Evan-Daruwalla/vision-autonomous-car/cad/README.md

# cad/ — models and print artifacts

## tolerance_coupon_v1.stl / _v2.stl — PRD M1.3

**Why this exists:** nominal Lego geometry (pin hole Ø4.8 mm, beam pitch
8.0 mm) does not print at nominal on an FDM machine — holes come out
undersize, and by an amount specific to *your* printer, filament, nozzle and
slicer settings. Community starting points are ~5.1 mm for a pin fit and
5.3–5.6 mm for a free-rotating axle bore, but those are **unverified on this
printer**, which is the whole point of this part. Every chassis dimension in
M1.5–M1.7 depends on the numbers you get here, so this is the first thing to
print and it gates the rest of M1.

Generated by [`scripts/gen_tolerance_coupon.py`](../scripts/gen_tolerance_coupon.py) —
edit the constants there and re-run rather than editing the STL. **v1 tested
2026-09-05: the axle-bore sweep (5.20-5.70 mm) was entirely too loose, so v2
moves it to 4.80-5.30 mm** (see the generator's module docstring). v1's STL
and its results stay on disk/in this file — it was actually printed and
measured, and the record doesn't overwrite tested history.

```bash
python scripts/gen_tolerance_coupon.py            # writes v2 by default now
python scripts/gen_tolerance_coupon.py -o cad/tolerance_coupon_v1.stl  # v1's own range is no longer the default; regenerate v1 only to re-check it
```

The generator self-validates and refuses to claim success quietly: it checks
the mesh is closed and consistently wound (every directed edge appears once,
its reverse once) and that the signed volume matches the analytic expectation.
v2 output: `manifold PASS`, `volume PASS` at 6.66e-16 relative error,
18,048 triangles, 104 × 56 × 8 mm.

### What's on the plate

| Feature | Layout | Diameters | How to identify |
|---|---|---|---|
| **Pitch row** | 5 holes at exactly **8.00 mm** centres | all 5.10 mm | the tightly-spaced row, no markers |
| **Pin row** | 6 holes at 16 mm centres | 4.80 → 5.30 in 0.1 steps | **one** 3 mm marker hole at the left end |
| **Axle row** | 6 holes at 16 mm centres | 4.80 → 5.30 in 0.1 steps (v2; v1 was 5.20 → 5.70, all found too loose) | **two** 3 mm marker holes, one at each end |

Sweeps ascend left-to-right from the marker end. The plate is 8 mm thick on
purpose — that matches a real Lego beam, and hole shrinkage is depth-dependent,
so a thin coupon would give you optimistic numbers.

### Printing

**Print it with the exact settings you intend to use for the chassis.** If you
later change layer height, nozzle, or filament brand, these numbers stop being
valid and the coupon has to be re-run. Record the settings you used — they go
in the record entry alongside the measurements.

- No supports needed; all holes are vertical through-holes.
- Suggested starting point: 0.2 mm layers, 3 walls, ≥20% infill, 0.4 mm nozzle.
- **Print it twice — once in PLA, once in PETG.** The research calls for PETG
  on rotating bores (PLA galls against Lego axles) and PLA is fine for static
  holes, so you need both sets of numbers. ~15 min each.

### Testing

You need real Lego parts and calipers.

- **Pin row — pass = a Lego pin pushes in with firm thumb pressure and HOLDS.**
  Too tight if you need pliers or the plate creaks; too loose if it falls out
  or wobbles. Record the smallest diameter that seats without excessive force.
- **Axle row — pass = a Lego axle spins FREELY with no perceptible radial
  slop.** Record the smallest diameter that spins freely, since larger means
  more slop.
- **Pitch row — insert two pins joined by a real Lego beam (or a 2-pin
  connector) across holes 1 and 2, then across 1 and 5.** If the beam seats on
  adjacent holes but binds across all five, your printer has a dimensional
  scaling error — measure the actual centre-to-centre distance across the 5
  holes with calipers (nominal 32.00 mm) and note the ratio. That scaling
  factor applies to every chassis part.
- Also caliper each hole's **actual printed diameter** so you know the offset
  between commanded and achieved, not just which hole happens to work.

### Results — v1 (printed and tested 2026-09-05, Appendix DI)

Printer: **Bambu P1S**  Filament: **Bambu ABS, Black** (replaces the
PLA+PETG plan — ABS is now the standing chassis material, Evan 2026-09-05)
Nozzle: **0.4 mm**  Layer height: **0.2 mm**  Walls: **2**  Infill: **10% gyroid**
Shrinkage compensation: **99%** (Bambu Studio X/Y scale-up, ABS-specific)
Date printed: 2026-09-05 (exact time not recorded)

| Row | Commanded Ø | Measured Ø | Offset | Fit verdict |
|---|---|---|---|---|
| Pin | 4.80 | not calipered | — | **PASS — best fit** |
| Pin | 4.90 | not calipered | — | pass |
| Pin | 5.00 | not calipered | — | pass |
| Pin | 5.10 | not calipered | — | not reported |
| Pin | 5.20 | not calipered | — | not reported |
| Pin | 5.30 | not calipered | — | not reported |
| Axle | 5.20 | not calipered | — | **FAIL — too loose ("seems a bit big")** |
| Axle | 5.30 | not calipered | — | FAIL — too loose |
| Axle | 5.40 | not calipered | — | FAIL — too loose |
| Axle | 5.50 | not calipered | — | FAIL — too loose |
| Axle | 5.60 | not calipered | — | FAIL — too loose |
| Axle | 5.70 | not calipered | — | FAIL — too loose |

Evan's report: pin row — "only the smallest 3 are a good fit with the
smallest one being the best" (4.80/4.90/5.00 pass, 4.80 best; 5.10-5.30
not explicitly reported, treated as untested rather than assumed-fail).
Axle row — "all the ones in the first row spin smooth, even the smallest
ones seems a bit big": **all six axle-row diameters too loose**, including
the smallest (5.20) — the sweep brackets nothing at the tight end.
⚠️ **No caliper measurements taken** — verdicts are Evan's fit-by-feel only
(firm/holds vs. spins-free-with-slop), not measured offsets. "Measured Ø"
and "Offset" columns are unfilled because of that, not because they were
skipped in the record.

**The pitch-row dimensional-scaling test (beam across holes 1-2, then
1-5) was NOT run** — Evan spin-tested a Lego axle across the pitch row's 5
holes instead (uniform 5.10 mm, also too loose for an axle, consistent with
the axle-row finding) rather than the beam-span check the row is for. Scale
factor still unknown.

**v1 chosen:** pin holes model at **4.80 mm** (best of 3 tested passes, at
the bottom of the tested range — not bracketed, could be even better below
it). Rotating axle bores: not determined in v1 — the 5.20-5.70 sweep was
entirely too loose, which is why v2 exists.

### Results — v2 (`tolerance_coupon_v2.stl`) — printed and tested 2026-09-05, Appendix DK

Same print settings as v1 (Bambu P1S, Bambu ABS Black, 0.4mm nozzle, 0.2mm
layers, 2 walls, 10% gyroid, 99% shrinkage comp) unless Evan says otherwise
— not independently confirmed unchanged, but no change was reported.

| Row | Commanded Ø | Measured Ø | Offset | Fit verdict |
|---|---|---|---|---|
| Axle | 4.80 | not calipered | — | not reported |
| Axle | 4.90 | not calipered | — | not reported |
| Axle | 5.00 | not calipered | — | **PASS — best fit ("3rd smallest hole is best for axel")** |
| Axle | 5.10 | not calipered | — | not reported |
| Axle | 5.20 | not calipered | — | not reported |
| Axle | 5.30 | not calipered | — | not reported |

Evan reported only the winner, not a pass/fail for every row — 4.80/4.90
being smaller and 5.10-5.30 being larger than the chosen 5.00 doesn't by
itself tell us whether they failed tight, failed loose, or simply fit worse
than 5.00. Recorded as "not reported," not assumed either way.

**Chosen offsets — M1.3's two headline numbers, both closed:**
**pin holes model at 4.80 mm** (v1) · **rotating axle bores model at
5.00 mm** (v2). Sits between the pin's snug-fit diameter (4.80) and v1's
smallest too-loose axle diameter (5.20), which is the physically sensible
place for a rotating cross-axle bore to land relative to a static pin's
socket.

**Still open:** the pitch-row dimensional-scaling check (beam across holes
1-2, then 1-5) has never been run, and no caliper measurements exist for
either coupon — every verdict above is fit-by-feel against the coupon's
pass criteria, not a measured offset.

### When you're done

1. Put the filled table + print settings into a record entry (they are
   portfolio evidence — this is a real measured experiment, not a guess).
2. Write the two chosen offsets into `.claude/project-memory/gotchas.md`,
   replacing the unverified community figures currently there.
3. M1.5 onward can then model against real numbers.

**If the sweep brackets nothing** — every pin hole too tight, or every axle
bore too loose — edit the ranges at the top of the generator and re-run rather
than guessing beyond the ends of the sweep.

---

## servo_lego_coupler_v1.stl — PRD task 8c(ii)

**Why this exists:** the servo-to-pinion coupling is the highest-torque joint
on the car (Appendix BV). ~~The chosen part is the Adafruit #4252 ($0.75), but~~
**Since 2026-10-04 the plan is to PRINT this part (v2, below); #4252 is the
fallback, never bought.** Originally: the chosen part was the Adafruit #4252 ($0.75), but
Adafruit is a sole-source vendor for it and charges ~$10 shipping for that one
item (Evan, 2026-09-03). This is a printed stopgap to try first — **not a
proven replacement.**

Generated by [`scripts/gen_servo_lego_coupler.py`](../scripts/gen_servo_lego_coupler.py) —
edit the constants there and re-run rather than editing the STL.

```bash
python scripts/gen_servo_lego_coupler.py
```

Self-validates the same way the coupon does (closed + consistently wound mesh,
signed volume against an analytic expectation) and refuses to write on failure.
Current output: `manifold PASS`, `volume PASS` at 1.05e-14 relative error,
1,152 triangles, Ø10 × 16 mm, 1015.12 mm³.

### Printed and fitted: v1 was too loose -> v2 (2026-10-04, Appendix FC)

**v1 was printed** (by 2026-09-03; the record had misread this as a bought
Adafruit #4252). **Its Lego-axle socket was TOO LOOSE** (Evan). Printer,
filament and settings were not recorded. Cause: the socket used the coupon's
+0.20 mm free-SPIN offset, where a grip needs the pin row's 0.00.

**`servo_lego_coupler_v2.stl` - print this one.** Same part, socket clearance
0.00 mm (4.80 x 1.80 mm cross, 2.60 mm wall):

```bash
python scripts/gen_servo_lego_coupler.py --socket-clear 0.00 -o cad/servo_lego_coupler_v2.stl
```

**Untested.** The 0.00 came from a round pin; thin cross arms may print
tighter - if a Lego axle will not go in, regenerate at 0.05 or 0.10 rather than
forcing it. Record printer, filament, settings and the fit result this time.
The generator refuses any wall under 1.2 mm (Appendix FD #6).

### v3: half the wall, 2 mm shorter (2026-10-10)

Evan fitted v2: "make the walls of the v2 1/2 as thick and a bit shorter
overall; other than that the dimensions are good". So the bore (4.65 mm) and
the 0.00-clearance cross socket are unchanged. OD 10.0 -> 7.4 mm (socket wall
2.60 -> 1.30, bore wall 2.675 -> 1.375); length 16 -> 14 mm (bore 8 -> 7,
socket 6 -> 5, web still 2). "A bit shorter" = 2 mm was a guess, not a
measured requirement - change `--bore-depth` / `--socket-depth` if not.

```bash
python scripts/gen_servo_lego_coupler.py --socket-clear 0.00 --od 7.4 --bore-depth 7 --socket-depth 5 -o cad/servo_lego_coupler_v3.stl
```

**Untested, and weaker by design:** in twist, the bore section's polar section
modulus drops to about 36% of v2's (computed, (OD^4 - ID^4)/OD), and a
1.375 mm wall around a 0.20 mm press-fit spline is more likely to split in
ABS. 1.30 mm is just above the generator's 1.2 mm floor.

### Drive-motor coupler v1: Pololu #5159 D-shaft to a Lego axle (2026-10-10)

Same generator, same socket and wall as servo v3, with a D-bore at the motor
end: 3.00 mm, 2.50 mm across the flat, 8 mm deep (the shaft is 9 mm, so the
part stops ~1 mm short of the gearbox face). 1.5 mm through-hole in the web
(a 2.2 mm one would cut the flat, which sits 1.0 mm off centre; the generator
now refuses that). OD 7.4 x 15 mm.

```bash
python scripts/gen_servo_lego_coupler.py --socket-clear 0.00 --od 7.4 --bore-dia 3.0 --bore-flat 2.5 --screw-dia 1.5 --bore-depth 8 --socket-depth 5 -o cad/motor_lego_coupler_v1.stl
```

**The 2.50 mm flat is UNMEASURED** - Pololu does not publish it; one retailer
says 2.5 mm (`docs/research/2026-07-23_drive-motor-selection.md`). Caliper
the real shaft (diameter, across-flat, length) before printing and re-run
with the measured numbers. The bore is modelled at nominal (0.00 offset, the
grip that worked on the coupon pins and on v2); if it will not go on, add
0.05-0.10 to `--bore-dia` and `--bore-flat` rather than forcing it. Untested.

**Motor v2 (2026-10-11, Evan): +0.075 mm clearance on the D-bore only** -
3.075 mm dia, 2.575 mm across the flat, still 8 mm deep; socket and body
unchanged. (A 1.5x-longer, 12 mm bore was generated first and dropped at
Evan's call: the shaft is only 9 mm.)

```bash
python scripts/gen_servo_lego_coupler.py --socket-clear 0.00 --od 7.4 --bore-dia 3.075 --bore-flat 2.575 --screw-dia 1.5 --bore-depth 8 --socket-depth 5 -o cad/motor_lego_coupler_v2.stl
```

**Motor v3 (2026-10-11, Evan): another +0.075 mm** - 3.150 mm dia, 2.650 mm
across the flat (+0.150 over v1 in total). Same everything else.

```bash
python scripts/gen_servo_lego_coupler.py --socket-clear 0.00 --od 7.4 --bore-dia 3.15 --bore-flat 2.65 --screw-dia 1.5 --bore-depth 8 --socket-depth 5 -o cad/motor_lego_coupler_v3.stl
```

### The design, and the one thing it deliberately does not do

| end | feature | why |
|---|---|---|
| servo (z 0–8) | Ø4.65 mm plain round bore | 0.20 mm under the 4.85 mm 20T spline; the metal spline cuts its own seat |
| middle (z 8–10) | Ø2.2 mm axial hole | screwdriver access to the servo's OWN retaining screw — zero new parts, stops the coupler walking off the shaft |
| Lego (z 10–16) | 5.00 × 2.00 mm cross socket, 6 mm deep | receives a **real** Lego axle |

**It prints no cross-axle profile.** Appendix BV measured a printed male cross
profile at SF 0.57–0.96 (thin cruciform fins shearing along layer lines) and
`steering.md` permits socket-style printed adapters only. This obeys that: the
printed part is a thick-walled socket (2.50 mm wall at the socket, 2.68 mm at
the bore); the cross profile is the real Lego axle's.

**The spline is not modelled, on purpose.** 20 teeth on a Ø4.85 mm circle is a
~0.76 mm tooth pitch — under what a 0.4 mm nozzle resolves. A modelled spline
would print as a blurred round hole while claiming fidelity it does not have.

### ⚠️ What is NOT known

**No safety factor is claimed, and none can be computed** without a torque
test. The bore-to-spline grip is friction plus spline bite and has never been
loaded. What protects this joint is the existing rule that the servo never
reaches stall (`SERVO_US_SPAN` limiting, task 8c). If it slips, the upgrade is
a transverse M2 grub screw into the bore — **not** the MG996R, which makes the
coupling problem ~5× worse (BOM row 7).

### Four numbers to caliper, then re-run

| constant | current | status |
|---|---|---|
| `SPLINE_DIA` | 4.85 | datasheet range 4.8–4.9; measure the real servo |
| `AXLE_ARM` | 1.80 | Lego cross-axle arm thickness — community value, **unverified**. The 4.80 mm across-the-cross span IS confirmed |
| `SOCKET_CLEAR` | 0.20 | still provisional. ⚠️ The M1.3 coupon IS now printed (2026-09-05) and its axle row closed at 5.00 mm — but that is a FREE-SPIN fit, and this socket needs a firm GRIP to transmit torque, which is closer to the coupon's PIN row (4.80 mm) in spirit. Do not copy 5.00 across without deciding which fit this joint actually wants |
| `BORE_INTERF` | 0.20 | press interference — a guess; the first print settles it |

Print it in **PETG**, not PLA: this is a loaded joint and PLA is the material
Appendix BV's failing numbers were computed against.

## OpenSCAD parts - `cad/scad/` (2026-10-11, Appendix FY)

Printed mounts are parametric OpenSCAD files. OpenSCAD 2021.01 lives at
`~/tools/openscad-2021.01/` (not on PATH; `scripts/render_scad.py` finds it,
or set `$OPENSCAD`). Never hand-export from the GUI for the repo: render with

```bash
.venv/Scripts/python.exe scripts/render_scad.py cad/scad/pla_fit_coupon.scad -o cad/pla_fit_coupon.stl --png preview.png
```

It writes a CANONICAL binary STL (OpenSCAD's raw output reorders facets run to
run, so `check_artifacts.py` could not byte-compare it otherwise). It writes
NOTHING unless the mesh is a closed manifold, the volume is positive, the
bounding box matches, and every ray probe in `<part>.probe.json` passes.
A probe file lists the holes that must be open (with solid walls) and the
points that must be open or solid. `--png` writes a preview with the
`ghost_box` component stand-ins visible.

Shared primitives are in `cad/scad/lib/lego.scad`: `technic_hole` (with optional
counterbores), `pin_grid`, `pilot_hole`, `zip_slot`, `ghost_box`. Holes are
circumscribed polygons, so they never print smaller than nominal.

### pla_fit_coupon.stl - print this FIRST (untested)

72 x 34 x 17 mm. Every mount's Lego interface depends on PLA fits nobody has
measured: the 4.80 mm pin hole came from ABS coupons judged by feel. Print it
with the same settings as the parts (P1S, PLA, 0.1 mm, 2 walls), then report:

- **Row A** (plain, 4.75 / 4.80 / 4.85 / 4.90 / 4.95 / 5.00 from the chamfered
  corner): which hole takes a black friction pin FIRMLY, by hand, without
  force.
- **Row B** (same sizes, 6.2 x 0.8 counterbore on top): does the counterbore
  let the coupon sit flush against a Lego beam when pinned?
- **Row C** (six 4.90 holes at 8 mm pitch): pin a 1x7 beam across all six; if
  the end pins bind, the printer's X/Y scale is off.
- **Horizontal holes** (4.8 / 4.9 / 5.0, through the fin): the same pin test;
  holes printed sideways come out less round.
- **Pilot holes** (1.5 / 1.7 / 1.9): which one a servo mounting screw drives
  into firmly without splitting.
- **Zip slots** (3.0 / 3.5 / 4.0 / 5.0 wide x 1.8): the smallest your zip tie
  passes through.

### motor_mount.stl - v2, printable, UNTESTED (Appendices GJ, GK, GL)

Cradle for the Pololu #5159 under the centre frame, motor connector UP,
held by 2 zip ties, with a back wall behind the encoder. v1 printed
2026-10-12: dimensions fine, but the encoder hit the back third of the side
walls, which v2 removes. v2 takes two REAL black friction pins: push them
into holes A/B of the short beams inside the centre frame from below, then
push the mount up so the pins snap into its arm sockets (6.2 x 0.8 collar
recess, 4.8 bore, 6.2 snap cavity - see
docs/research/2026-10-12_technic-pin-snap-geometry.md). Print upright, floor
on the bed, no supports. Report: do the pins snap and hold; does the motor
sit level with the coupler; is the back wall gap right (encoder end position
was a photo estimate).

### servo_mount.stl - v2, printable, UNTESTED (Appendix GS)

One plate across the two Lego 2x4 L liftarms either side of the MG90D-270,
carrying it by its ears only (the case footprint is open). Two ear screws into
1.7 mm pilots (swap for the coupon's best pilot). Pin holes at studs 1, 2 and 3
of each L; pin studs 1 and 3. Print flat side down, no supports.

### electronics_tray.stl + electronics_deck.stl - printable, UNTESTED (Appendix GW)

Layer 1 (tray) pins straight onto the middle frame row (free holes at studs 0,
4, 6, 10, 11, 15, 16 along both long edges, 48 mm apart) and carries the power
bank (ports to the rear), the 2S holder (one side lobe) and the charger / BMS /
fuse / XT30 (other lobe, zip slots). Layer 2 (deck) pins onto the tray's six
posts and carries the Pi case (camera connector forward, vent window under
it), the Uno on pegs, the LM2596 on a wing and the rocker on a rear tab.
Print both flat side down; the tray is ~162 x 169 mm.
