Evan-Daruwalla/vision-autonomous-car/cad/reference/README.md

# cad/reference - external OpenDRIVE files

These two files were not generated by this repo's code. They are vendored
here (2026-09-09) so the track scripts and their self-checks work on any
clone. Provenance as far as the record shows (added 2026-11-04, audit C3-9,
record NQ):

| File | Source | Record |
|---|---|---|
| `1122.xodr` | A 3x3 grid map Evan exported from LaneMaker on 2026-09-07 (was `~/Downloads/1122.xodr`, 96,786 B) | EF; vendored per the 2026-09-09 audit |
| `figure8.xodr` | Was `~/Downloads/figure 8.xodr` (31,208 B), named in record ER as the resolution of the LaneMaker thread. Who made it and with what tool is NOT recorded | ER |

Not checked: LaneMaker's terms for exported files. The repo LICENSE (MIT)
covers this repo's own code and docs; it makes no claim about these two
files beyond what their source allows.
