Evan-Daruwalla/vision-autonomous-car/pi/requirements-autopilot.txt

# for pi/autopilot.py; numpy and Pillow come from Raspberry Pi OS apt
onnxruntime==1.31.1
