Evan-Daruwalla/vision-autonomous-car/ml/artifacts/p1_first_frame.png

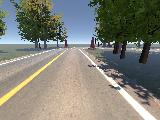
ml/artifacts/p1_first_frame.png
