Evan-Daruwalla/vision-autonomous-car/ml/runs/encoder_cmp/cone_recon.png

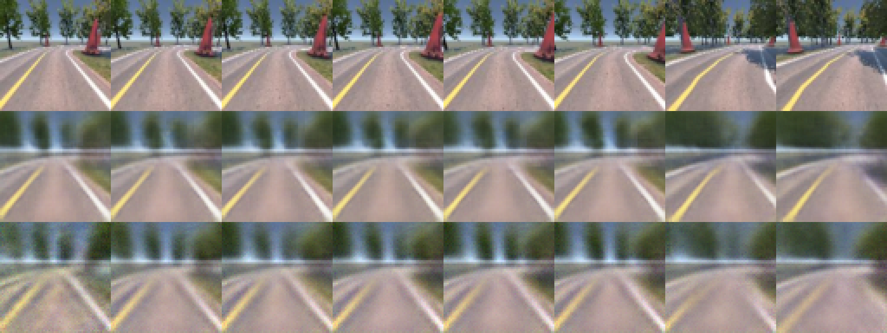
ml/runs/encoder_cmp/cone_recon.png
