Evan-Daruwalla/vision-autonomous-car/ml/runs/rollout/rollout_holdout.png

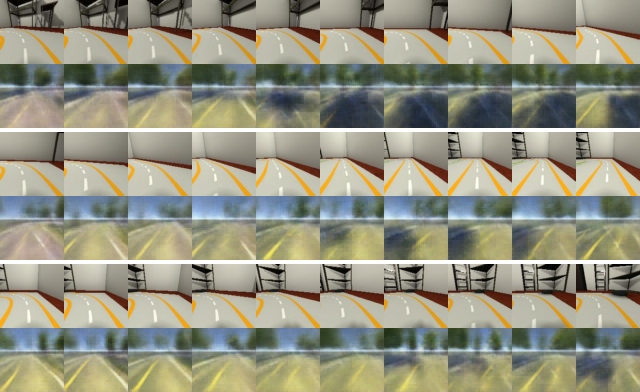
ml/runs/rollout/rollout_holdout.png
