Evan-Daruwalla/vision-autonomous-car/ml/runs/rollout/rollout_val_indomain.png

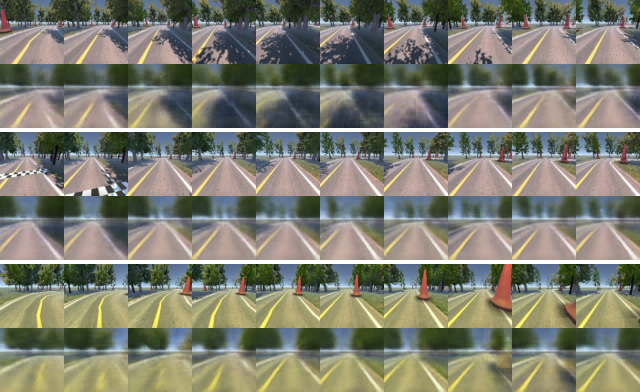
ml/runs/rollout/rollout_val_indomain.png
