Evan-Daruwalla/vision-autonomous-car/ml/runs/vae/recon_fit.png

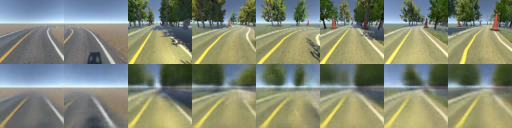
ml/runs/vae/recon_fit.png
