Evan-Daruwalla/vision-autonomous-car/ml/runs/vae/recon_holdout.png

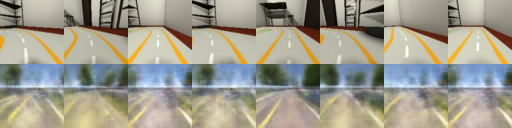
ml/runs/vae/recon_holdout.png
