Evan-Daruwalla/vision-autonomous-car/ml/runs/vae/recon_val_indomain.png

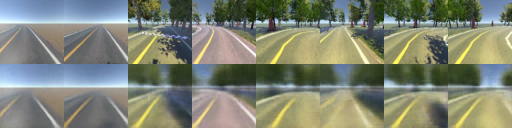
ml/runs/vae/recon_val_indomain.png
