Evan-Daruwalla/vision-autonomous-car/cad/electronics_deck.stl

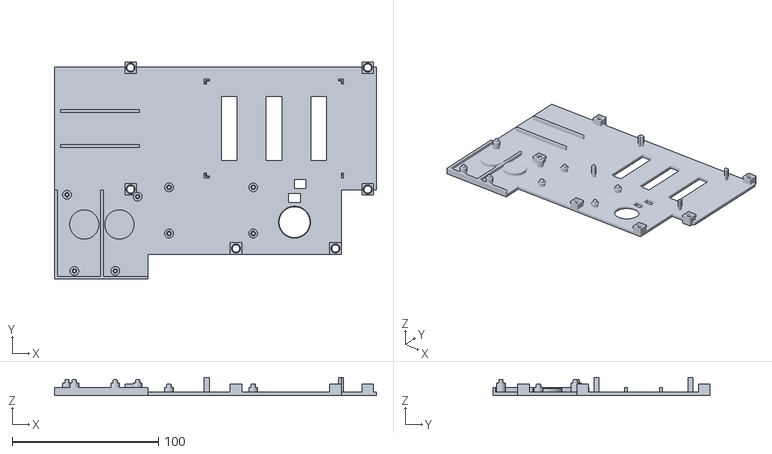
[picture p13: CAD file, 2026-11-01]
cad/electronics_deck.stl
220.0 x 148.6 x 12.5
