Evan-Daruwalla/vision-autonomous-car/cad/electronics_tray.stl

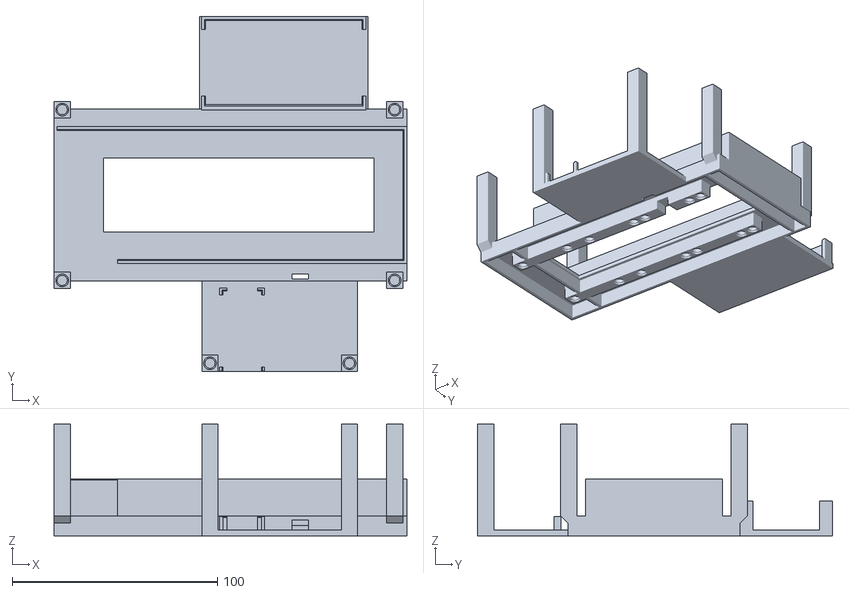
[picture p14: CAD file, 2026-11-01]
cad/electronics_tray.stl
172.0 x 173.0 x 54.5
