Evan-Daruwalla/vision-autonomous-car/cad/pla_fit_coupon.stl

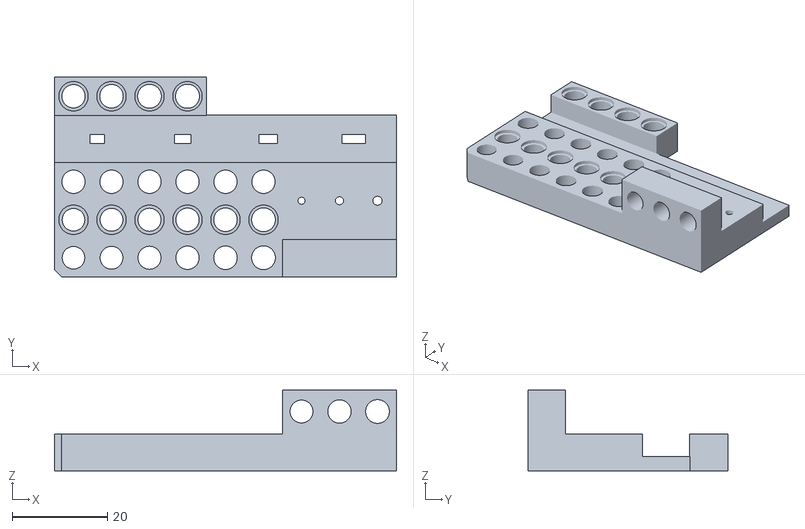
[picture p15: CAD file, 2026-10-13]
cad/pla_fit_coupon.stl
72.0 x 42.0 x 17.0
