Evan-Daruwalla/vision-autonomous-car/cad/pla_pocket_gauge.stl

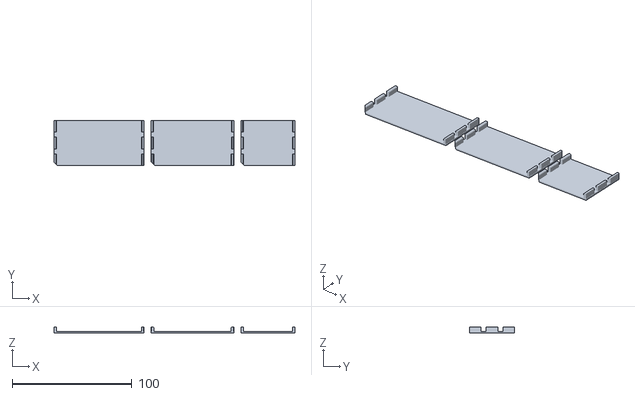
[picture p16: CAD file, 2026-10-13]
cad/pla_pocket_gauge.stl
201.6 x 38.0 x 5.20
