Evan-Daruwalla/vision-autonomous-car/cad/servo_mount.stl

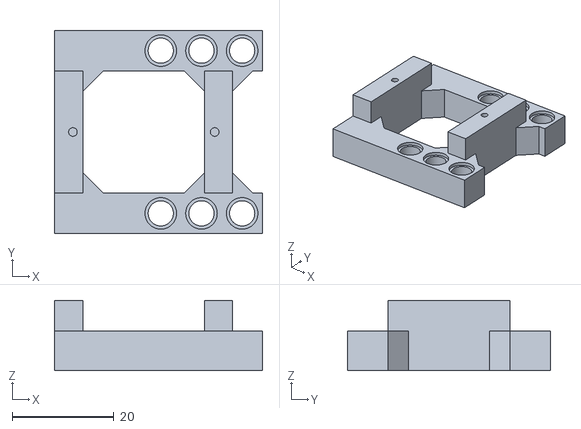
[picture p17: CAD file, 2026-10-13]
cad/servo_mount.stl
40.9 x 40.0 x 13.8
