Evan-Daruwalla/vision-autonomous-car/cad/camera_mast.stl

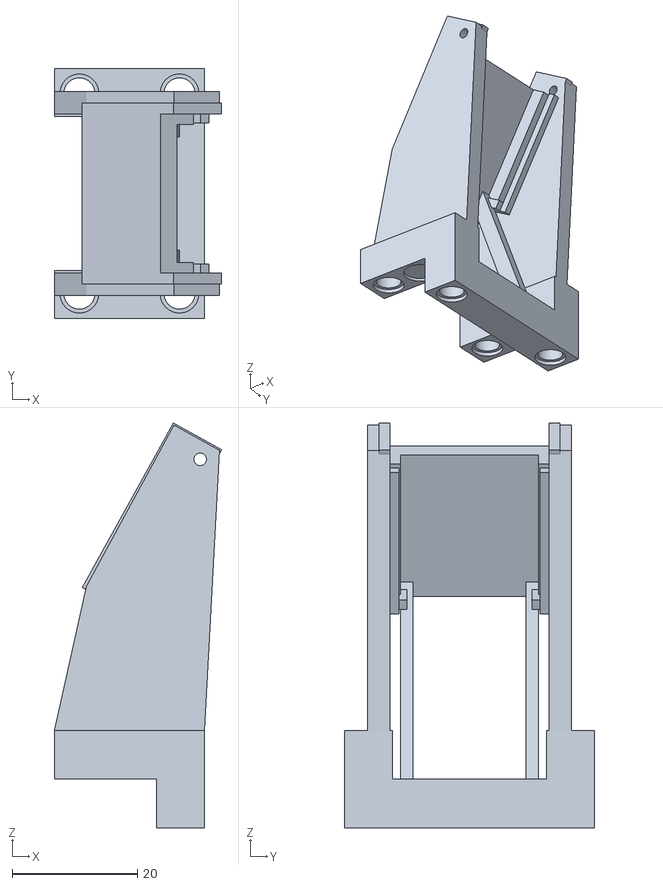
[picture p18: CAD file, 2026-10-13]
cad/camera_mast.stl
26.7 x 40.0 x 64.7
