Evan-Daruwalla/vision-autonomous-car/cad/motor_mount.stl

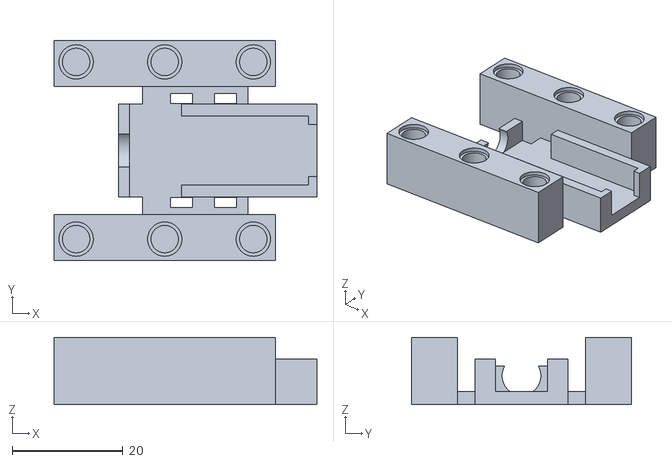
[picture p19: CAD file, 2026-10-13]
cad/motor_mount.stl
47.5 x 39.8 x 12.1
