Evan-Daruwalla/vision-autonomous-car/cad/motor_lego_coupler_v3.stl

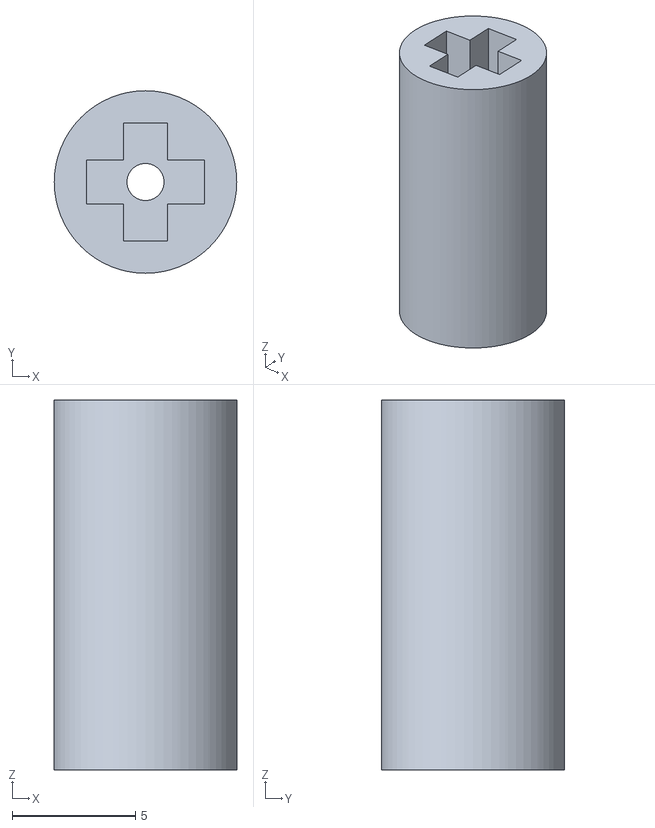
[picture p20: CAD file, 2026-10-11]
cad/motor_lego_coupler_v3.stl
7.40 x 7.40 x 15.0
