Evan-Daruwalla/vision-autonomous-car/cad/servo_lego_coupler_v3.stl

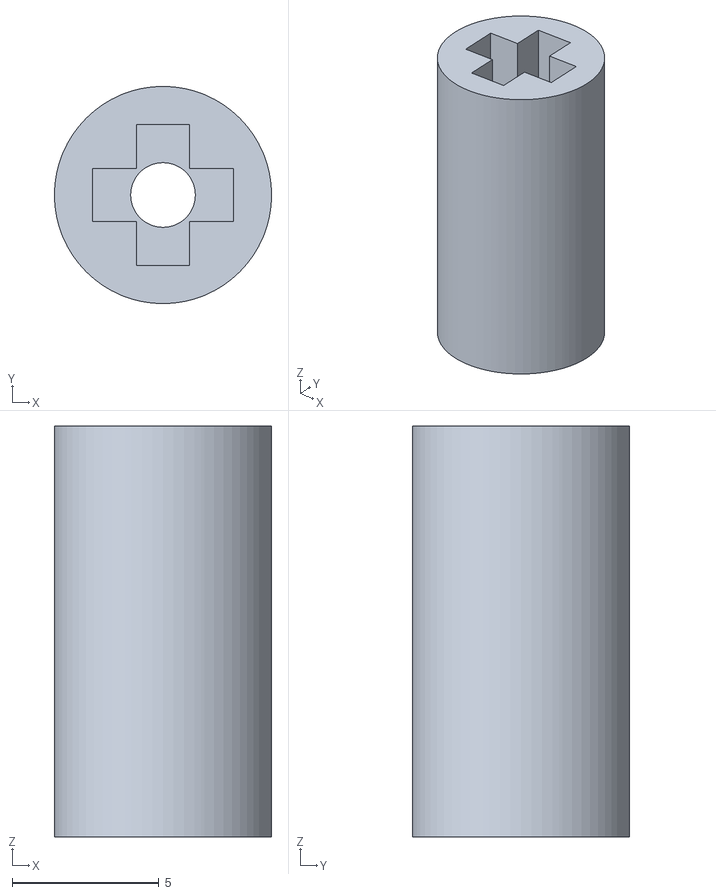
[picture p21: CAD file, 2026-10-11]
cad/servo_lego_coupler_v3.stl
7.40 x 7.40 x 14.0
