Evan-Daruwalla/vision-autonomous-car/cad/tolerance_coupon_v2.stl

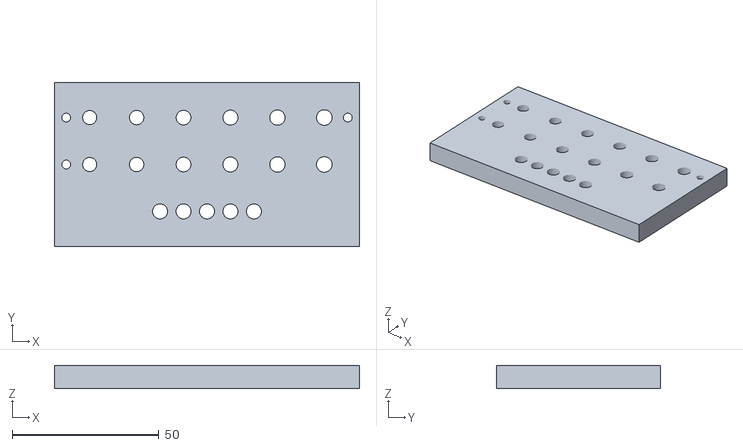
[picture p22: CAD file, 2026-09-05]
cad/tolerance_coupon_v2.stl
104.0 x 56.0 x 8.00
