Evan-Daruwalla/vision-autonomous-car/cad/servo_lego_coupler_v2.stl

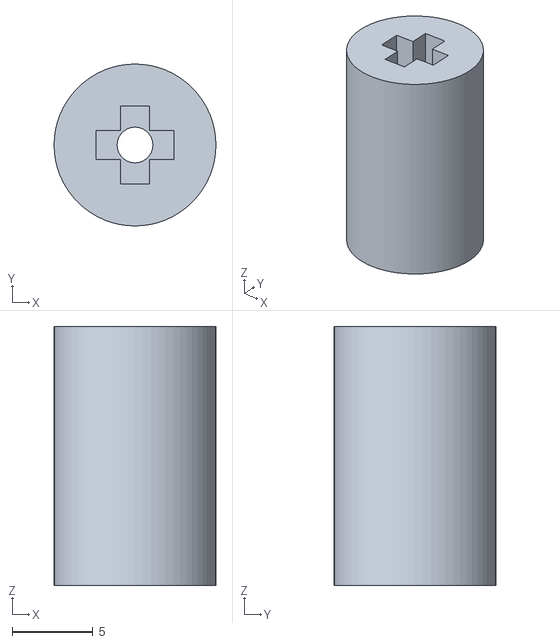
[picture p23: CAD file, 2026-10-05, an earlier design]
cad/servo_lego_coupler_v2.stl
10.0 x 10.0 x 16.0
