Evan-Daruwalla/vision-autonomous-car/cad/scad/electronics_tray.scad

// Electronics TRAY: PLA tray that pins onto the car's Lego frames and carries the
// battery bank, the battery holder, the charger / small parts, and the deck posts.
// UNTESTED - not printed.
// spec: record GW
// v2 (2026-10-12): encoder-cable notch in the -y rail (x 100..108, z 0..5) and floor slot
// (x 100..108, y -41.0..-38.5); see the record entry of that date.
// v3 (2026-10-13): print-friendly per docs/research/2026-10-12_print-friendly-cad-rules.md:
// ribs under the floor so every overhang is a bridge <= ~20 mm (Rule 7), zip-tie
// notches in the ribs, -y feet moved off the small-parts tie paths, holder lobe to
// y 85 (tie strip 0.6 -> 2.6 mm, Rule 8), 45 deg wedges under the four outer posts,
// pockets from fit class "pocket" (Rules 2, 11), 0.5 lead-in chamfers on the pocket
// tops (Rule 5). Print as modelled: z = 0 on the bed. See the record entry of 2026-10-13.
// v4 (2026-10-13): deck raised 2 mm (posts to z 32.0) - the 2S holder (20.5 tall, top
// z 30.3) hit the deck underside at 30.0. LAYOUT list = every layer-1 electronic part
// (preview ghosts + echoed for scripts/electronics_layout.py).
// v5 (2026-10-13): fences 4 -> 10 mm tall. The PETG pocket gauge showed the bank ~2 mm
// loose in a 4 mm fence: its edges are rounded and its sides are flat only from 7 mm
// above its bottom (Evan). Pocket width unchanged (70.55 + 0.25 per side). Zip slots 3.5.
// v6 (2026-10-13): posts 32 -> 42 (deck +10 mm, Evan's option A): the inline fuse holder
// (50 x 34.25 x 12, measured) lies flat on top of the bank, and the holder leads get room.
// v7 (2026-10-13): bank and holder sit on VELCRO (Evan, ~4 mm; removable) instead of zip
// ties - their edge slots could never close a loop (no return path under the part). Fences
// 10 -> 14 so the lifted bank's flat band (7 mm up) is still held; posts 42 -> 46 so the
// fuse holder on the lifted bank still clears the deck. The bank/holder slots stay, unused.
// v8 (2026-10-13): both side lobes DROPPED onto the Lego frames (Evan: frames level) -
// flat LOBE_T plates at z 0, printed on the bed: no ribs, feet or bridges under them. Only
// the middle floor stays raised (the bank spans the 7.8 mm pin rails). Holder moved out
// 6.4 mm to sit wholly on its lobe, in a 4-sided fence. Charger / BMS / XT30 on tape or
// velcro. Every zip slot and tie notch removed (nothing is tied any more).
// v9 (2026-10-16): new power bank 168 x 62.16 x 22.51 (Evan; was 151.5 x 70.55 x 18.0). Bank pocket
// moved back (bank x -14.25..153.75; the servo mount starts at x ~157); floor, edge ribs and rear
// skirt rib extend to x -16. Bank fence 14 -> 18 mm (BANK_FENCE_H; the holder fence stays FENCE_H 14).
// -y bank wall starts at x 15 so the bank's charge button (-y side, ~10 mm from its rear end) stays
// reachable. Posts 46 -> 54.5 (deck +8.5: velcro under the fuse holder on the bank). LAYOUT: velcro
// under the fuse, BMS, charger and XT30; BMS at the holder's rivet (+x) end (MB wire 55 mm); charger
// turned, USB-C out the -y lobe edge; XT30 at the lobe's inner edge.
// v9 audit (2026-10-16): fuse holder x 40 -> 10 so it no longer sits under the deck's Pi vent window (x 65..137); LAYOUT only, no geometry change.
// v10 (2026-10-16): room for wires and connectors (Evan). Rear posts x 10 -> -12 (the deck grows rearward for a 40 mm USB-A plug zone behind the Pi). Holder fence END walls removed: the -x wall blocked the lead exit, the +x wall pressed on the MB solder joint at the rivet. LAYOUT: clearance boxes reserve plug, cable and access space (bank USB-C plug / run / rise, P+/P- crossing, charger USB-C, XT30 unplug, holder lead and rivet ends).
// v11 (2026-10-16): Evan's bench results - velcro measured 3.5 per mated pair (15.5 mm dots); fuse holder x 10 -> 30, off the bank's charge LEDs (top, -y side, ~10-40 mm from the rear end, read from the side); bank USB-C cable re-routed along the bank's -y side below its top, rising past the wing's front end. LAYOUT only, no geometry change.
// v12 (2026-11-01, Evan): holder fence END walls back, each with a centred opening 80% of the holder width
// (32.4 of 40.5) for the red / black leads and the MB wire; the lead-exit and MB-rivet clearance boxes narrowed
// to that opening. Charger held by Pi-style L-brackets (2 mm legs, 6.5 mm tall = velcro + half the board) at its
// +y corners and on the x sides at its -y corners - no -y end legs (USB-C plug; the lobe edge is at y -86).
// v12b (2026-11-01, Evan): charger and XT30 swapped - charger x 104 -> 66.5 (more central, 0.75 mm clear of the
// lobe post at (60, -82)); XT30 to x 107..132 with its unplug room x 87..107 between them.
VELCRO = 3.5;             // velcro pair thickness (Evan 2026-10-16: measured 3.5 per mated pair, 15.5 mm dots)
//
// FRAME: x along the car, x = 0 at the REAR corner pin hole, +x toward the front;
// y across, the Lego pin rows at y = +/-24; z = 0 on the Lego frames' top face, z up. mm.
//
// Layout: two rails (pinned to the frames), a raised middle floor with a lightening
// window and ribs under it, a three-sided bank fence (no rear wall, for ports), two flat
// lobe plates on the frames (holder +y, small parts -y), a four-sided holder fence, and
// six deck posts (pinned, z up to 54.5).

use <lib/lego.scad>
EPS = 0.01;
$fn = 64;
PIN_D = lego_pin_d();     // 4.95: lib/lego.scad fit class "friction_pin" (record GU, HG)

RAIL_H = 7.8;             // a Lego beam's height: a pin half fits fully
FLOOR_T = 2.0;
FLOOR_TOP = RAIL_H + FLOOR_T;   // 9.8
FENCE_T = 2.0;
FENCE_H = 14.0;           // v5: past the bank's rounded bottom edge (flat side from 7 mm up, Evan 2026-10-13)
BANK_FENCE_H = 18.0;      // v9: bank fence taller than the holder fence
FENCE_TOP = FLOOR_TOP + BANK_FENCE_H;   // 27.8
LOBE_T = 3.0;             // v8: lobe plates sit on the frames, z 0..3
HFENCE_TOP = LOBE_T + FENCE_H;     // 17.0: holder fence on its lobe
POST_TOP = 54.5;
POST_S = 8.0;

RAIL_Y0 = 20;
RAIL_Y1 = 28;
RAIL_X0 = -4;
RAIL_X1 = 132;
PIN_ROW_Y = 24;
RAIL_PIN_X = [0, 32, 48, 80, 88, 120, 128];

// pockets: the bought part's footprint + fit class "pocket" (0.25 per side)
POCKET_C = fit_offset("pocket") / 2;
BANK_POS = [-14.25, -31.08];  BANK_SIZE = [168, 62.16];    // battery bank
HOLD_POS = [58.125, 44.25]; HOLD_SIZE = [75.75, 40.5];    // 2S holder (v8: wholly on its lobe)
// bank fence interior
BANK_X0 = BANK_POS[0] - POCKET_C;
BANK_X1 = BANK_POS[0] + BANK_SIZE[0] + POCKET_C;
BANK_Y = BANK_SIZE[1] / 2 + POCKET_C;
BTN_OPEN_X1 = 15;         // -y bank wall starts here (charge button opening)
// holder fence interior
HOLD_X0 = HOLD_POS[0] - POCKET_C;
HOLD_X1 = HOLD_POS[0] + HOLD_SIZE[0] + POCKET_C;
HOLD_Y0 = HOLD_POS[1] - POCKET_C;
HOLD_Y1 = HOLD_POS[1] + HOLD_SIZE[1] + POCKET_C;
HOLD_OPEN = 0.8 * HOLD_SIZE[1];   // v12: end-wall opening, centred (32.4)
HOLD_YC = HOLD_POS[1] + HOLD_SIZE[1] / 2;
// charger pocket and its corner brackets (v12)
CHG_POS = [66.5, -85.5];  CHG_SIZE = [18.3, 38.43];   // v12b: x was 104 (swapped with the XT30)
CHG_X0 = CHG_POS[0] - POCKET_C;  CHG_X1 = CHG_POS[0] + CHG_SIZE[0] + POCKET_C;
CHG_Y0 = CHG_POS[1] - POCKET_C;  CHG_Y1 = CHG_POS[1] + CHG_SIZE[1] + POCKET_C;
BR_T = 1.5;               // bracket wall, as the deck's Pi brackets
BR_LEG = 2.0;
CHG_BR_TOP = LOBE_T + 6.5;       // 9.5: velcro 3.5 + half the 6.3 board

POSTS = [[-12, 41.6], [-12, -41.6], [150, 41.6], [150, -41.6], [60, -82], [128, -82]];

RIB_T = 2.0;              // ribs under the floor (Rule 7)
LEAD = 0.5;               // lead-in chamfer on pocket tops (Rule 5)

module box(x0, x1, y0, y1, z0, z1) {
  translate([x0, y0, z0]) cube([x1 - x0, y1 - y0, z1 - z0]);
}
module rib(x0, x1, y0, y1) { box(x0, x1, y0, y1, 0, RAIL_H + EPS); }
module lead_in(x0, x1, y0, y1, ztop, c) {
  hull() {
    translate([x0, y0, ztop - c]) cube([x1 - x0, y1 - y0, EPS]);
    translate([x0 - 2 * c, y0 - 2 * c, ztop + c]) cube([x1 - x0 + 4 * c, y1 - y0 + 4 * c, EPS]);
  }
}

difference() {
  union() {
    // 1 rails
    for (s = [1, -1])
      if (s > 0) box(RAIL_X0, RAIL_X1, RAIL_Y0, RAIL_Y1, 0, RAIL_H);
      else box(RAIL_X0, RAIL_X1, -RAIL_Y1, -RAIL_Y0, 0, RAIL_H);
    // 2 floor
    box(-16, 156, -42, 42, RAIL_H, FLOOR_TOP);
    // 3 holder lobe plate, on the frames (overlaps the +y edge rib by 1 mm)
    box(55, 137, 41, 87, 0, LOBE_T);
    // 4 small-parts lobe plate, on the frames
    box(56, 132, -86, -41, 0, LOBE_T);
    // 5 bank fence: front wall and two side walls, no rear wall
    box(BANK_X1, BANK_X1 + FENCE_T, -(BANK_Y + FENCE_T), BANK_Y + FENCE_T, FLOOR_TOP, FENCE_TOP);
    box(BANK_X0, BANK_X1 + FENCE_T, BANK_Y, BANK_Y + FENCE_T, FLOOR_TOP, FENCE_TOP);
    box(BTN_OPEN_X1, BANK_X1 + FENCE_T, -(BANK_Y + FENCE_T), -BANK_Y, FLOOR_TOP, FENCE_TOP);
    // 6 holder fence on its lobe plate: inner and outer walls (v10: end walls removed for the leads / MB joint)
    box(HOLD_X0 - FENCE_T, HOLD_X1 + FENCE_T, HOLD_Y0 - FENCE_T - 0.5, HOLD_Y0, LOBE_T - EPS, HFENCE_TOP);
    box(HOLD_X0 - FENCE_T, HOLD_X1 + FENCE_T, HOLD_Y1, HOLD_Y1 + FENCE_T, LOBE_T - EPS, HFENCE_TOP);
    // 6b v12: end walls back, each split by a centred HOLD_OPEN opening for the wires
    for (ex = [HOLD_X0 - FENCE_T, HOLD_X1]) {
      box(ex, ex + FENCE_T, HOLD_Y0 - FENCE_T - 0.5, HOLD_YC - HOLD_OPEN / 2, LOBE_T - EPS, HFENCE_TOP);
      box(ex, ex + FENCE_T, HOLD_YC + HOLD_OPEN / 2, HOLD_Y1 + FENCE_T, LOBE_T - EPS, HFENCE_TOP);
    }
    // 7 v12: charger corner brackets on the -y lobe (no -y end legs: USB-C plug, lobe edge)
    for (sx = [-1, 1]) {
      xw = sx < 0 ? [CHG_X0 - BR_T, CHG_X0] : [CHG_X1, CHG_X1 + BR_T];
      box(xw[0], xw[1], CHG_Y1 - BR_LEG, CHG_Y1 + BR_T, LOBE_T - EPS, CHG_BR_TOP);      // +y corner, along y
      box(sx < 0 ? CHG_X0 - BR_T : CHG_X1 - BR_LEG, sx < 0 ? CHG_X0 + BR_LEG : CHG_X1 + BR_T,
          CHG_Y1, CHG_Y1 + BR_T, LOBE_T - EPS, CHG_BR_TOP);                               // +y corner, along x
      box(xw[0], xw[1], CHG_Y0, CHG_Y0 + BR_LEG, LOBE_T - EPS, CHG_BR_TOP);              // -y corner, x side only
    }
    // 8 deck posts: the two lobe posts stand on the bed (their lobe is at z 0)
    for (p = POSTS) box(p[0] - POST_S / 2, p[0] + POST_S / 2, p[1] - POST_S / 2, p[1] + POST_S / 2,
                        abs(p[1]) > 60 ? 0 : FLOOR_TOP, POST_TOP);
    // 8b ribs under the floor (Rule 7): edge ribs, rear skirt, rear cross, front cross, front skirt
    rib(-16, 156, 40, 42); rib(-16, 156, -42, -40);
    rib(-16, -14, -42, 42); rib(5, 7, -42, 42); rib(144, 146, -42, 42); rib(154, 156, -42, 42);
    // 8c 45 deg wedges under the four outer posts, which overhang the floor edge (|y| 42) by 3.6
    for (px = [-12, 150], s = [1, -1]) {
      d = 41.6 + POST_S / 2 - 42;     // 3.6
      hull() {
        translate([px - POST_S / 2, s > 0 ? 42 - EPS : -42, FLOOR_TOP - d]) cube([POST_S, EPS, d + EPS]);
        translate([px - POST_S / 2, s > 0 ? 42 + d - EPS : -42 - d, FLOOR_TOP - EPS]) cube([POST_S, EPS, 2 * EPS]);
      }
    }
  }
  // 9 lightening window through the floor
  box(8, 140, -18, 18, RAIL_H - EPS, FLOOR_TOP + EPS);
  // 10 rail pin holes, Lego-beam shaped
  for (x = RAIL_PIN_X, s = [1, -1])
    translate([x, s * PIN_ROW_Y, 0]) technic_hole(d = PIN_D, h = RAIL_H, cb_d = 6.2, cb_top = 0.8, cb_bot = 0.8);
  // 11 post pin holes (open at the top, deck pins in)
  for (p = POSTS)
    translate([p[0], p[1], POST_TOP - RAIL_H]) technic_hole(d = PIN_D, h = RAIL_H, cb_d = 6.2, cb_top = 0.8, cb_bot = 0.8);
  // 13 encoder-cable notch in the -y rail (x 100..108, between pins 88/120)
  translate([100, -28 - EPS, -EPS]) cube([8, 8 + 2 * EPS, 5.0 + EPS]);
  // 14 encoder-cable floor slot just outside the bank fence (y -41.0..-38.5)
  translate([100, -41.0, RAIL_H - EPS]) cube([8, 2.5, 2.0 + 2 * EPS]);
  // 15 encoder-cable notch through the -y edge rib, full height, under the floor slot
  translate([100, -42 - EPS, -EPS]) cube([8, 2 + 2 * EPS, RAIL_H + EPS]);
  // 17 lead-in chamfers on the pocket tops (Rule 5)
  lead_in(BANK_X0, BANK_X1, -BANK_Y, BANK_Y, FENCE_TOP, LEAD);
  lead_in(HOLD_X0, HOLD_X1, HOLD_Y0, HOLD_Y1, HFENCE_TOP, LEAD);
  lead_in(CHG_X0, CHG_X1, CHG_Y0, CHG_Y1, CHG_BR_TOP, LEAD);
}

// preview-only ghosts
// LAYOUT: [name, [sx, sy, sz], [x, y, z], kind, held by, ports]; kind part | zone | note.
// A zone reserves space for a part whose size is NOT measured.
LAYOUT = [
  ["velcro under the bank (3.5 mm pair)", [168, 62.16, VELCRO], [-14.25, -31.08, FLOOR_TOP], "zone", "adhesive both sides", ""],
  ["velcro under the holder (3.5 mm pair)", [75.75, 40.5, VELCRO], [58.125, 44.25, LOBE_T], "zone", "adhesive both sides", ""],
  ["battery bank (Pi power)", [168, 62.16, 22.51], [-14.25, -31.08, FLOOR_TOP + VELCRO], "part", "velcro + 18 mm bank fence, open at the rear", "-x: USB-C at the -y rear corner, USB-A at the +y rear corner; charge button on the -y side ~10 mm forward of the rear end (fence open x < 15); charge LEDs on top near the -y side, ~10-40 mm from the rear end (read from the side)"],
  ["2S holder + 2x Samsung 25R", [75.75, 40.5, 20.5], [58.125, 44.25, LOBE_T + VELCRO], "part", "velcro + 14 mm fence on its lobe, end walls 80% open (v12)", "-x: red / black leads + MB wire, 160 mm, from a SHORT end (Evan 2026-10-14) - seat that end at -x; MB 55 mm from the brass rivet on the +x end"],
  ["velcro under the fuse holder (3.5 mm pair)", [50, 34.25, VELCRO], [30, -17.125, FLOOR_TOP + VELCRO + 22.51], "zone", "adhesive both sides", ""],
  ["inline fuse holder, 3 A ATO (50 x 34.25 x 12, lying flat)", [50, 34.25, 12], [30, -17.125, FLOOR_TOP + VELCRO + 22.51 + VELCRO], "part", "velcro on top of the bank", "in the CELL+ wire, before the BMS"],
  ["velcro under the BMS (3.5 mm pair)", [41, 8, VELCRO], [92, 44.75, LOBE_T + VELCRO + 20.5], "zone", "adhesive both sides", ""],
  ["2S BMS (ACEIRMC B08HLQQCQJ)", [41, 8, 2.2], [92, 44.75, LOBE_T + VELCRO + 20.5 + VELCRO], "part", "velcro on top of the 2S holder", "+x: pads toward the rivet end (MB wire 55 mm); P+ / P- 4 x 190 mm over the bank to the -y lobe"],
  ["velcro under the charger (3.5 mm pair)", [18.3, 38.43, VELCRO], [66.5, -85.5, LOBE_T], "zone", "adhesive both sides", ""],
  ["USB-C 2S charger (Adeept p0374)", [18.3, 38.43, 6.3], [66.5, -85.5, LOBE_T + VELCRO], "part", "velcro + 2 mm corner brackets, 6.5 mm tall (v12)", "-y: USB-C out the -y lobe edge; BAT / GND pads at the +y end"],
  ["velcro under the XT30 (3.5 mm pair)", [25, 10.5, VELCRO], [107, -58, LOBE_T], "zone", "adhesive both sides", ""],
  ["XT30 pair, mated (25 x 10.5 x 5.3)", [25, 10.5, 5.3], [107, -58, LOBE_T + VELCRO], "part", "velcro (pack half)", "+x: pack half (BMS P+/P-, soldered); car half -x to the rocker"],
  ["bank USB-C plug", [30, 14, 12], [-44.25, -30, 19], "clearance", "keep clear", ""],
  ["bank USB-C cable along the bank's -y side (below its top, off the LED strip)", [168, 4, 6], [-14, -37.6, 28], "clearance", "keep clear", ""],
  ["bank USB-C cable rise past the wing's front end", [8, 8, 40], [133, -50, 34], "clearance", "keep clear", ""],
  ["P+/P- crossing over the bank", [22, 89, 6], [110, -45, 44], "clearance", "keep clear", ""],
  ["charger USB-C plug", [10, 30, 10], [70.65, -116, 7], "clearance", "keep clear", ""],
  ["XT30 unplug room", [20, 10.5, 5.3], [87, -58, 7], "clearance", "keep clear", ""],
  ["holder lead exit (through the 80% end opening)", [15, 32.4, 20.5], [43.1, 48.3, 7], "clearance", "keep clear", ""],
  ["holder MB rivet end (through the 80% end opening)", [8, 32.4, 20.5], [133.9, 48.3, 7], "clearance", "keep clear", ""]
];
for (p = LAYOUT) if (p[3] != "note") ghost_box(p[1], p[2]);
echo(LAYOUT_PARTS = LAYOUT);
ghost_box([168, 56, 7.8], [-4, -28, -7.8]);                         // middle frames (approx)
