Evan-Daruwalla/vision-autonomous-car/(list of files, cad)

Other CAD files:
cad/motor_lego_coupler_v1.stl
cad/motor_lego_coupler_v2.stl
cad/servo_lego_coupler_v1.stl
cad/tolerance_coupon_v1.stl
