Evan-Daruwalla/vision-autonomous-car/docs/guide/divider_xray.png

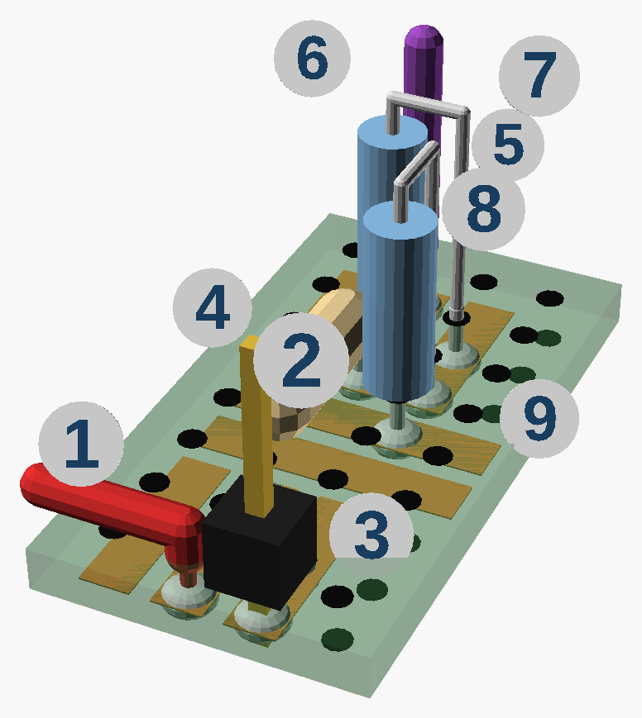
docs/guide/divider_xray.png
