Evan-Daruwalla/vision-autonomous-car/docs/guide/divider_xray_plan.png

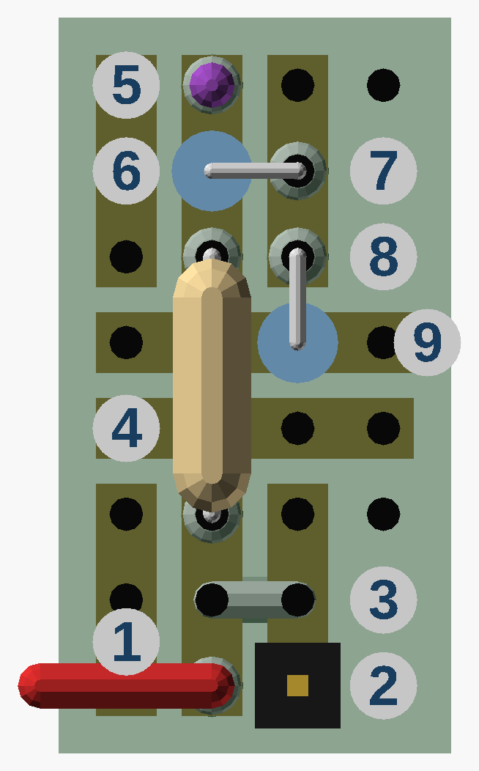
docs/guide/divider_xray_plan.png
