Evan-Daruwalla/vision-autonomous-car/docs/guide/flow_1_bottom.png

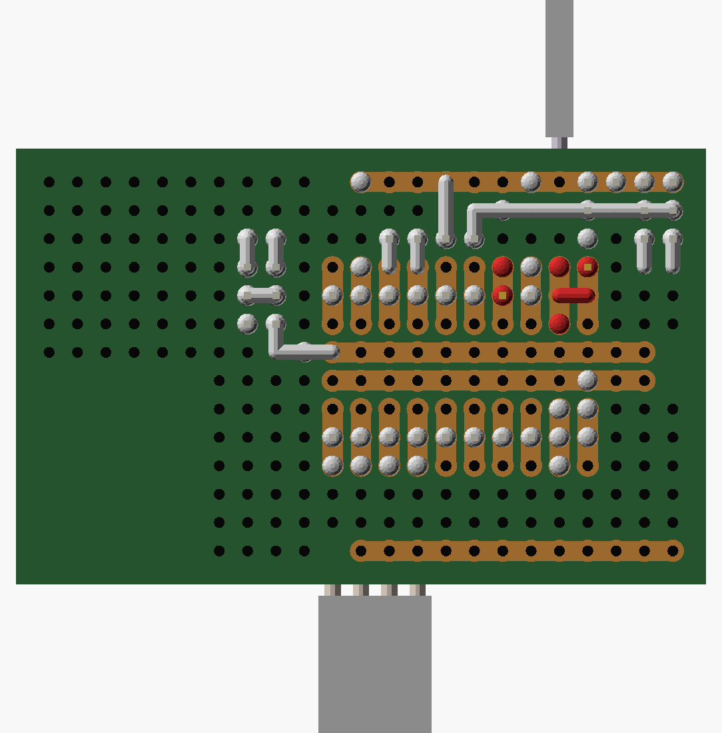
docs/guide/flow_1_bottom.png
