Evan-Daruwalla/vision-autonomous-car/docs/guide/flow_1_plan.png

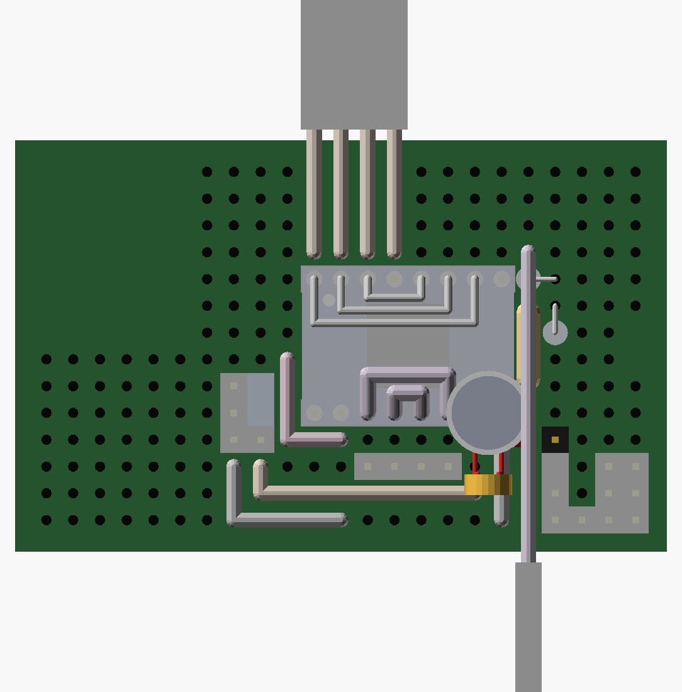
docs/guide/flow_1_plan.png
