Evan-Daruwalla/vision-autonomous-car/docs/guide/flow_1_top.png

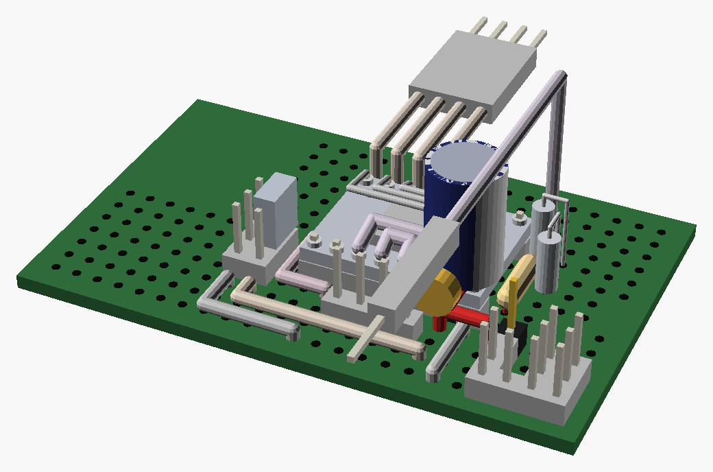
docs/guide/flow_1_top.png
