Evan-Daruwalla/vision-autonomous-car/docs/guide/flow_2_bottom.png

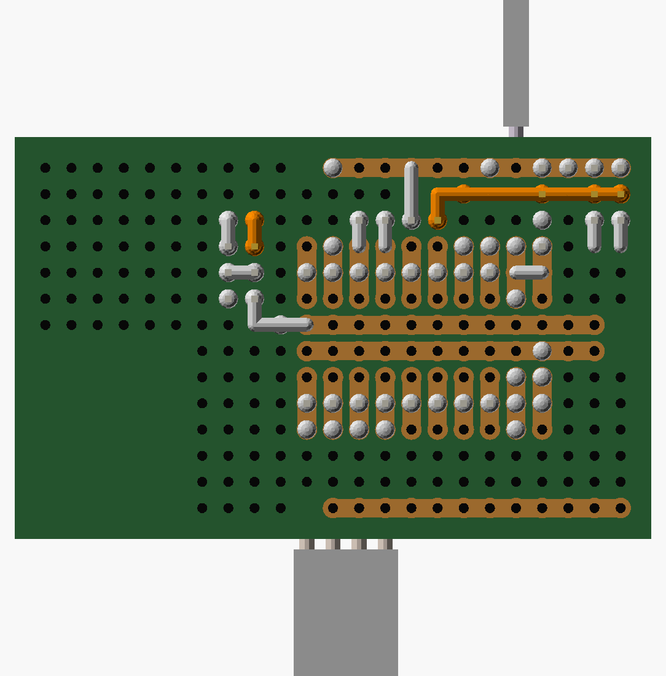
docs/guide/flow_2_bottom.png
