Evan-Daruwalla/vision-autonomous-car/docs/guide/flow_3_bottom.png

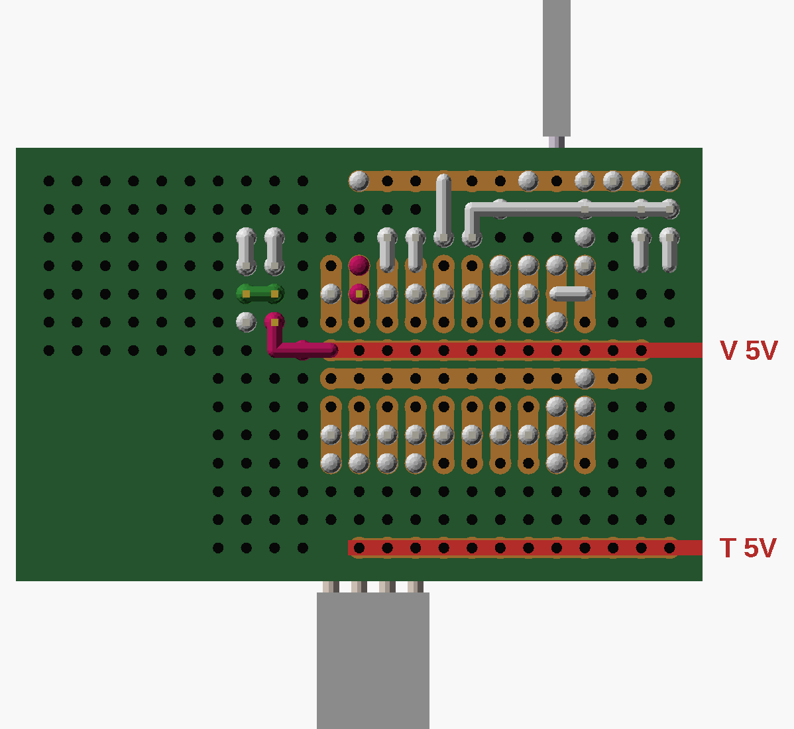
docs/guide/flow_3_bottom.png
