Evan-Daruwalla/vision-autonomous-car/docs/guide/flow_3_plan.png

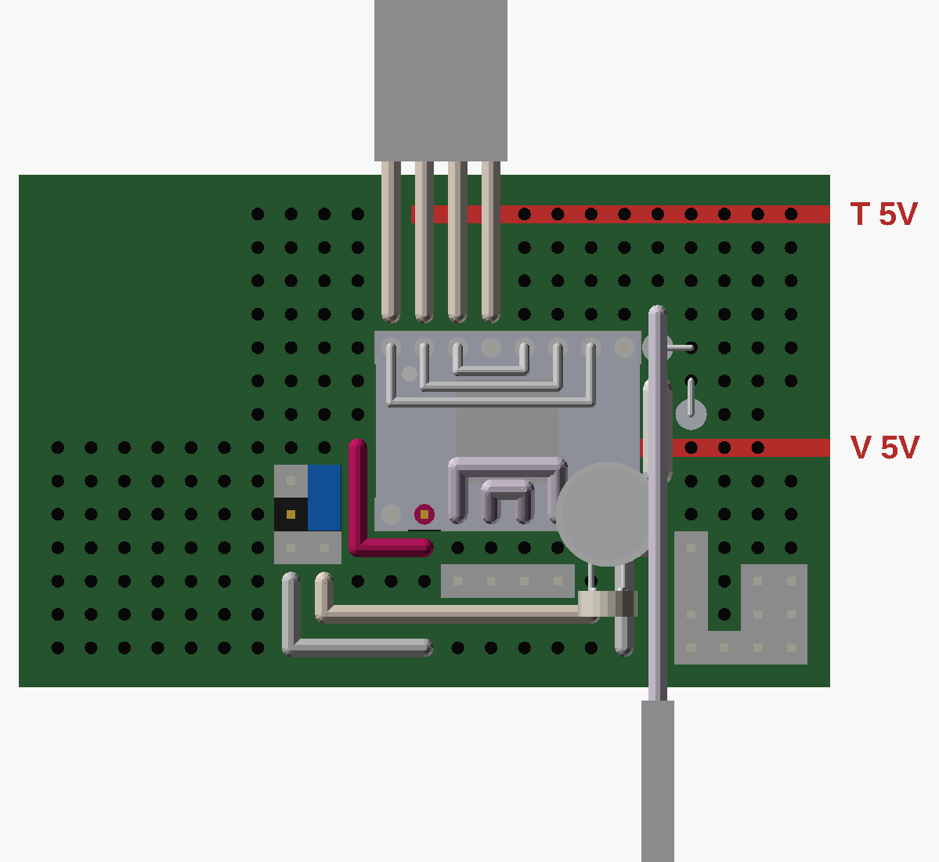
docs/guide/flow_3_plan.png
