Evan-Daruwalla/vision-autonomous-car/docs/guide/flow_3_top.png

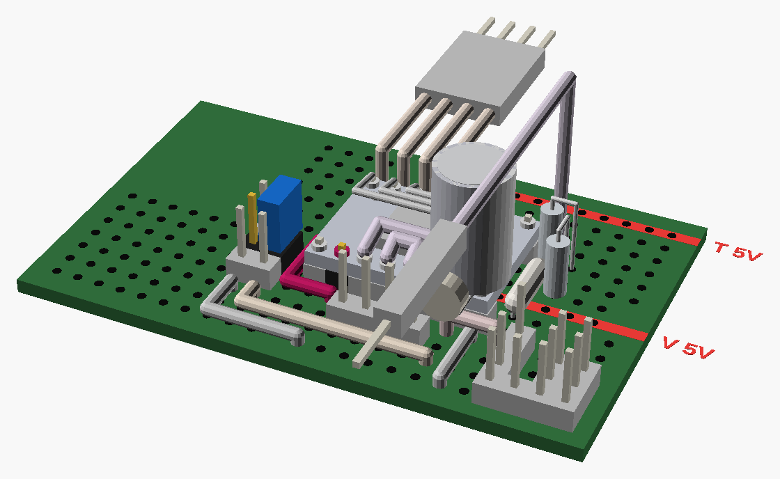
docs/guide/flow_3_top.png
