Evan-Daruwalla/vision-autonomous-car/docs/guide/flow_4_bottom.png

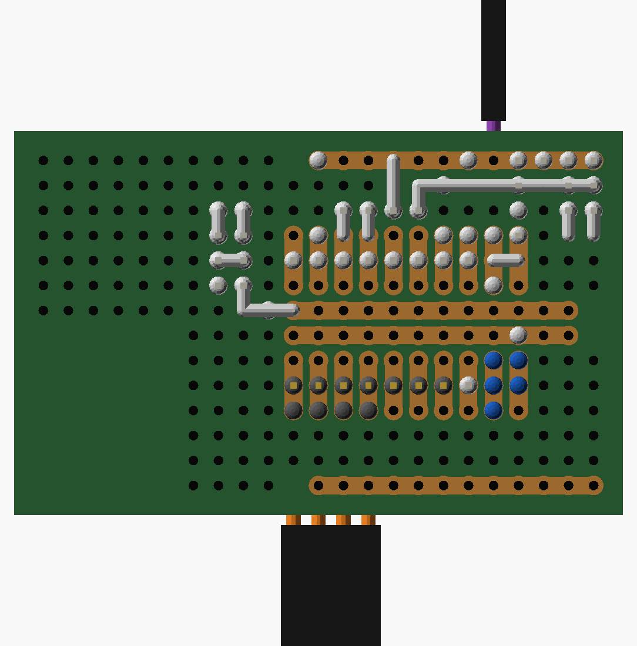
docs/guide/flow_4_bottom.png
