Evan-Daruwalla/vision-autonomous-car/docs/guide/flow_4_top.png

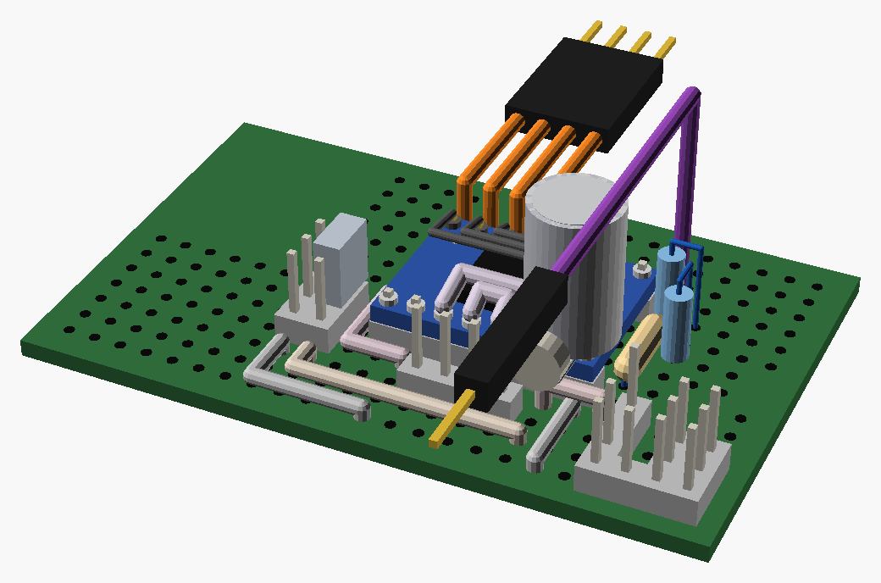
docs/guide/flow_4_top.png
