Evan-Daruwalla/vision-autonomous-car/docs/guide/flow_5_top.png

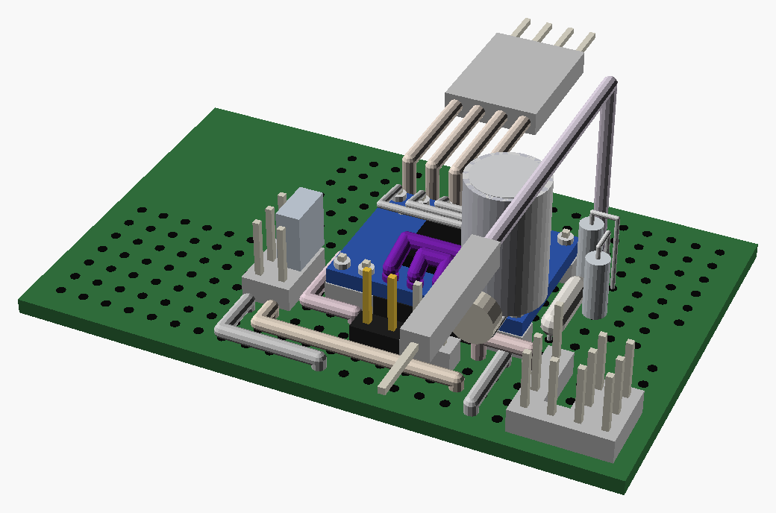
docs/guide/flow_5_top.png
