Evan-Daruwalla/vision-autonomous-car/docs/guide/flow_6_bottom.png

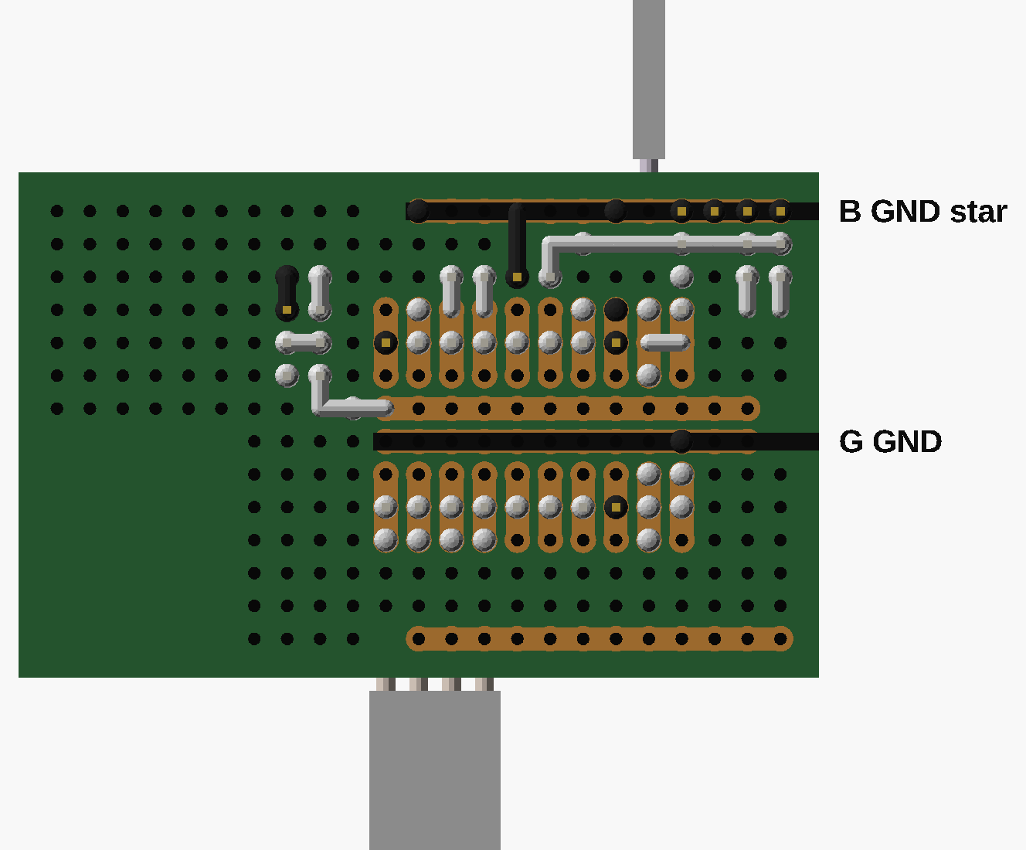
docs/guide/flow_6_bottom.png
