Evan-Daruwalla/vision-autonomous-car/docs/guide/flow_6_plan.png

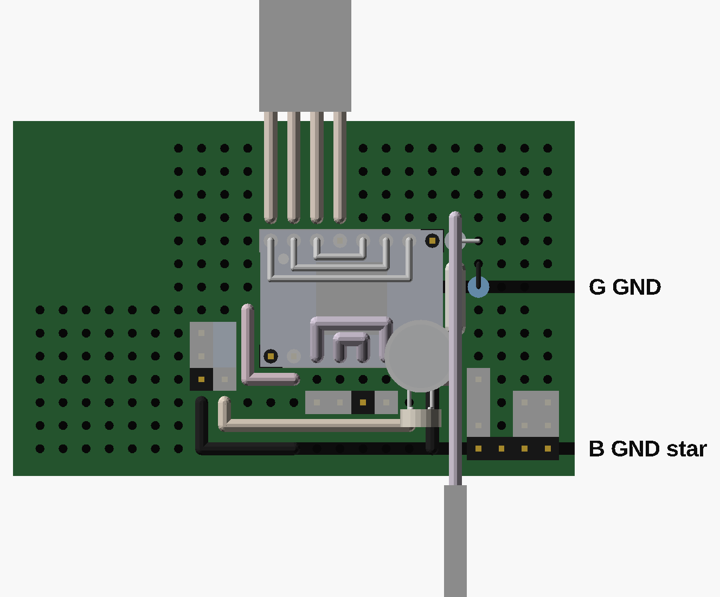
docs/guide/flow_6_plan.png
