Evan-Daruwalla/vision-autonomous-car/docs/guide/flow_6_top.png

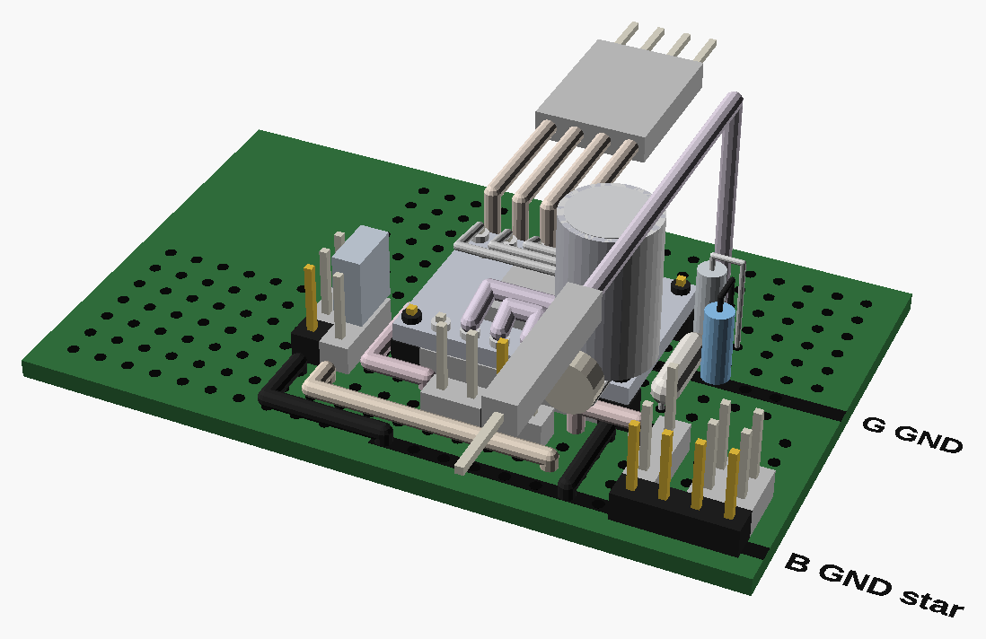
docs/guide/flow_6_top.png
