Evan-Daruwalla/vision-autonomous-car/docs/guide/step_0.png

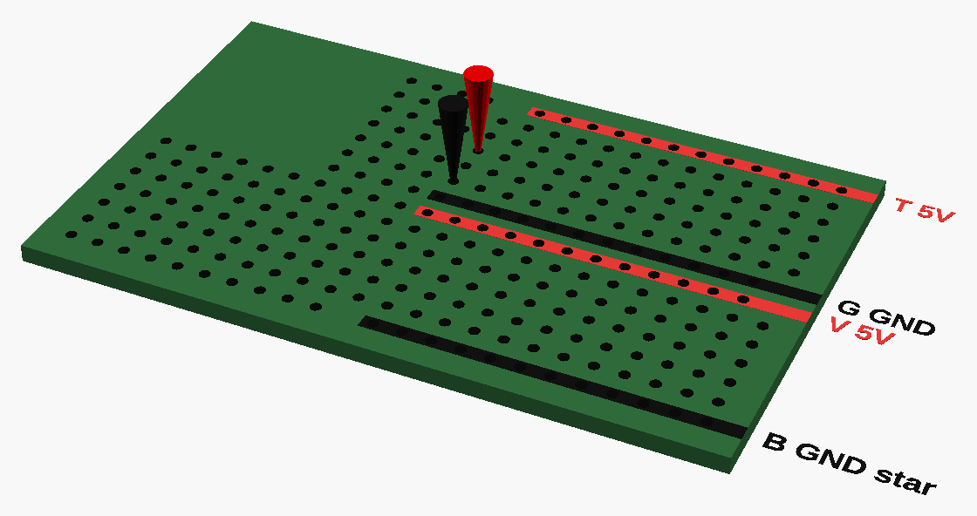
docs/guide/step_0.png
