Evan-Daruwalla/vision-autonomous-car/docs/guide/step_0_plan.png

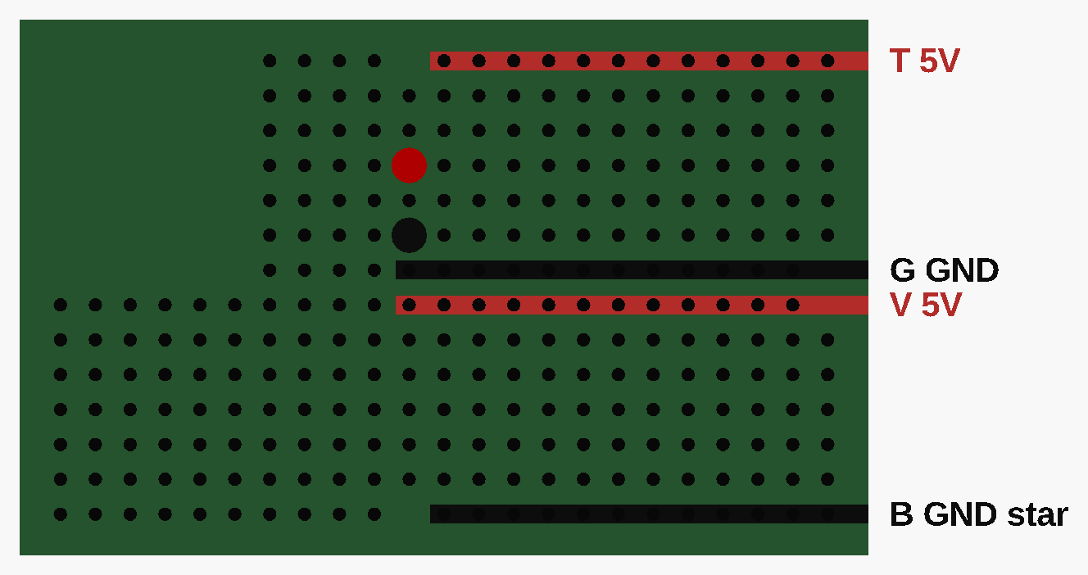
docs/guide/step_0_plan.png
