Evan-Daruwalla/vision-autonomous-car/docs/guide/step_1.png

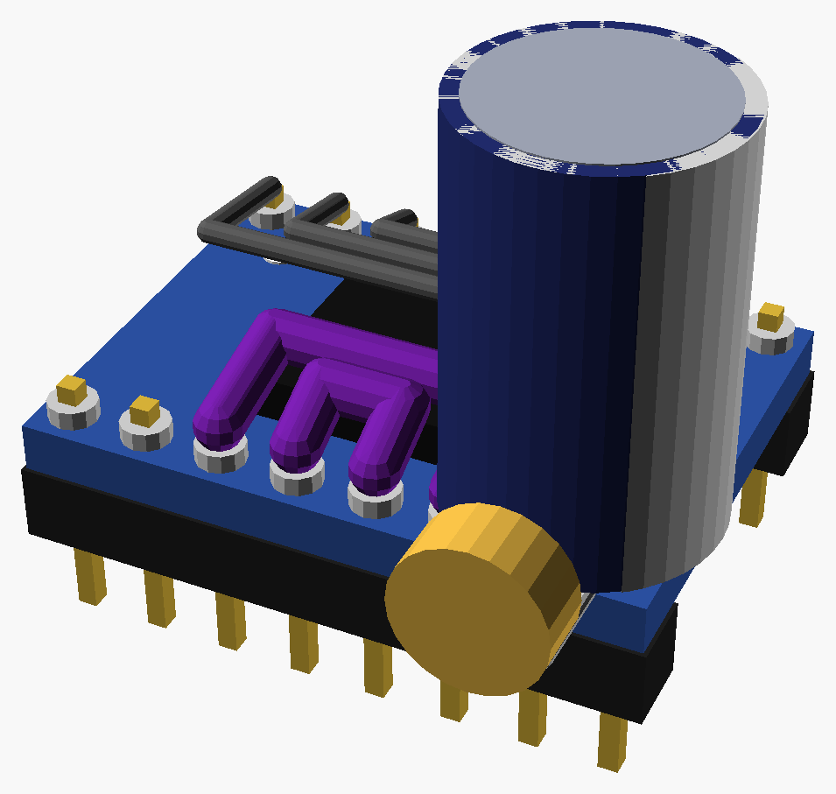
docs/guide/step_1.png
