Evan-Daruwalla/vision-autonomous-car/docs/guide/step_1_plan.png

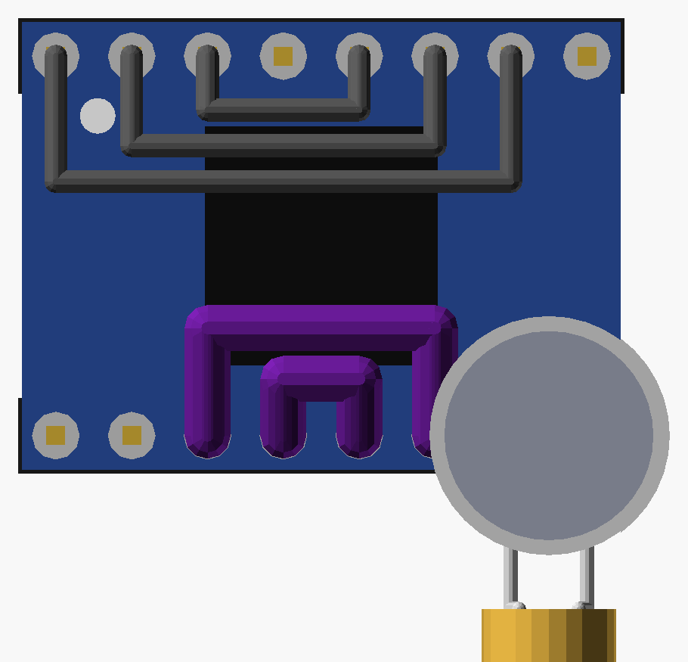
docs/guide/step_1_plan.png
