Evan-Daruwalla/vision-autonomous-car/docs/guide/step_2_plan.png

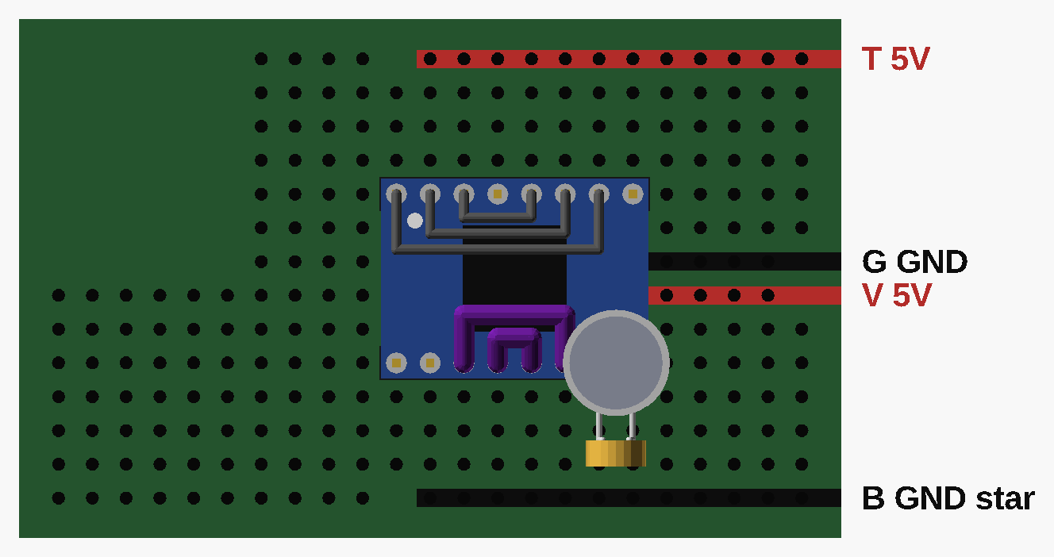
docs/guide/step_2_plan.png
