Evan-Daruwalla/vision-autonomous-car/docs/guide/step_3.png

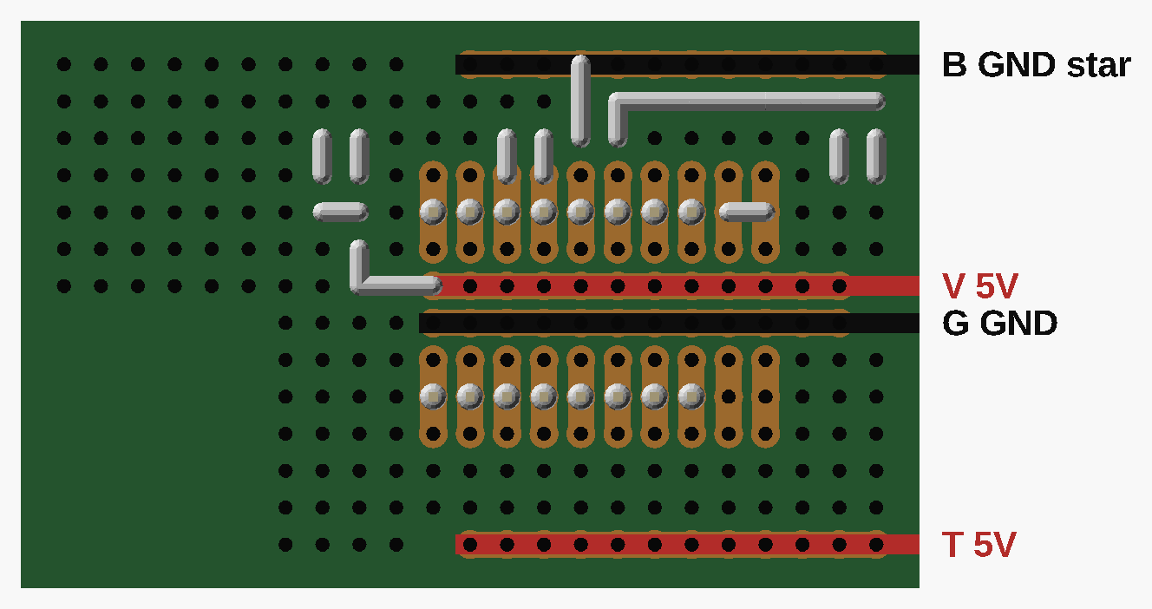
docs/guide/step_3.png
