Evan-Daruwalla/vision-autonomous-car/docs/guide/step_4.png

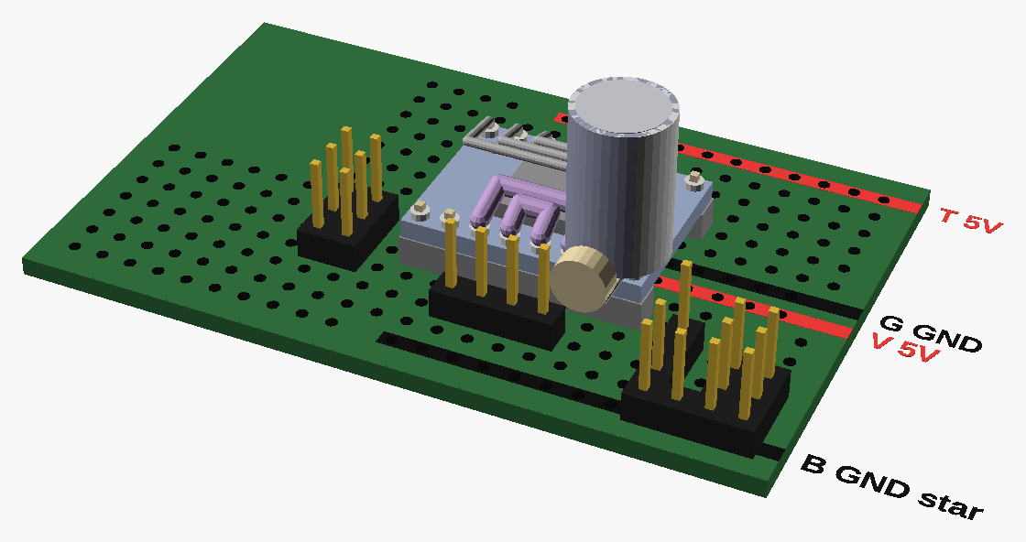
docs/guide/step_4.png
