Evan-Daruwalla/vision-autonomous-car/docs/guide/step_4_plan.png

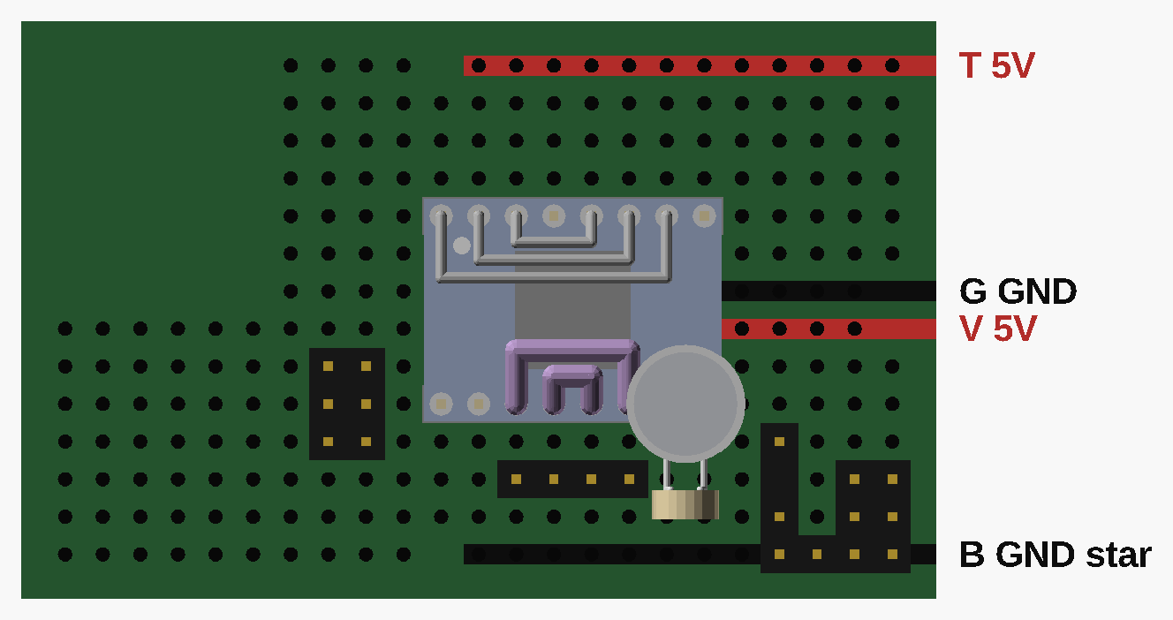
docs/guide/step_4_plan.png
