Evan-Daruwalla/vision-autonomous-car/docs/guide/step_5.png

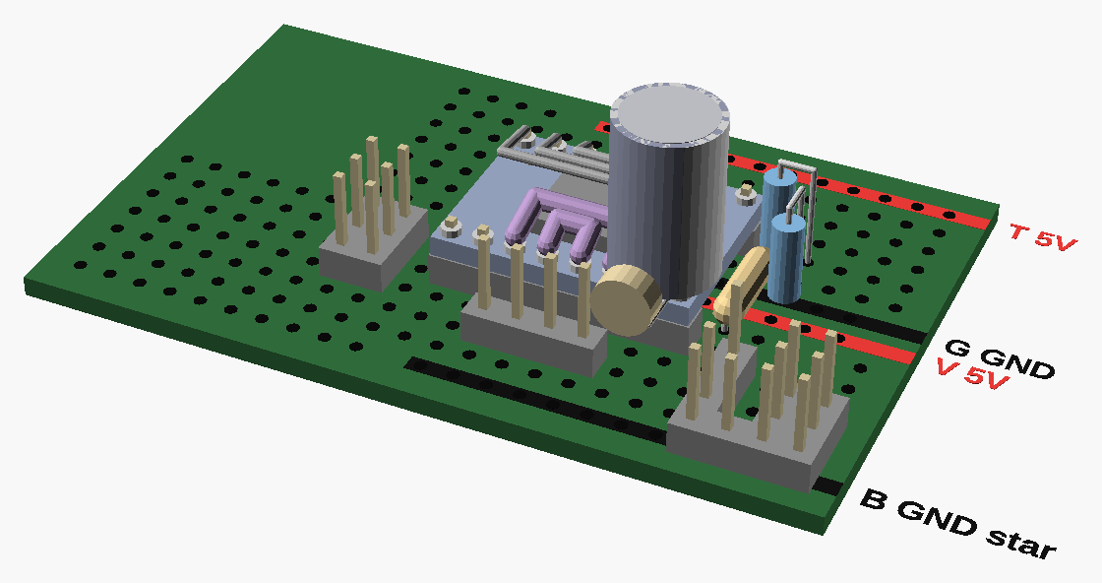
docs/guide/step_5.png
