Evan-Daruwalla/vision-autonomous-car/docs/guide/step_5_plan.png

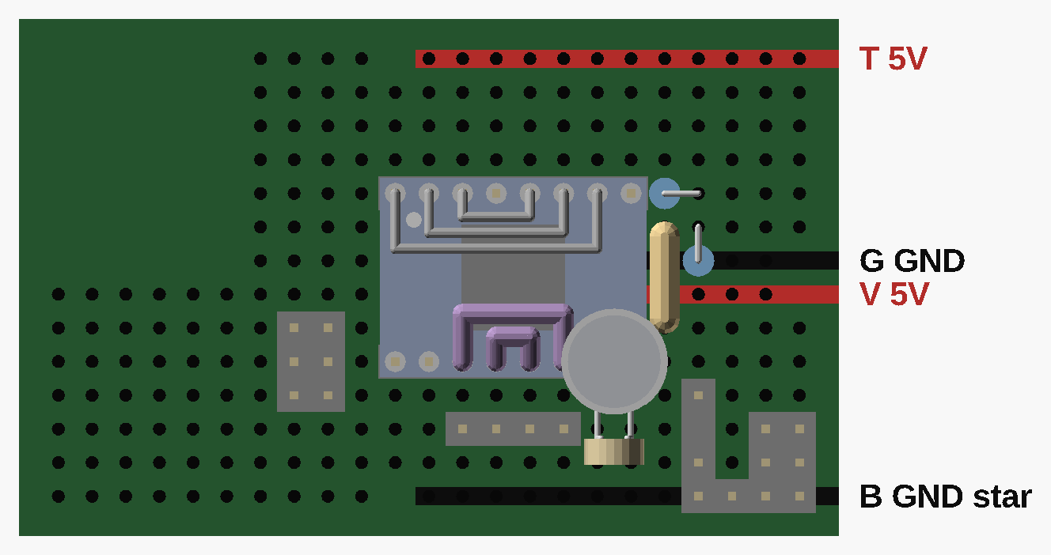
docs/guide/step_5_plan.png
