Evan-Daruwalla/vision-autonomous-car/docs/guide/step_7.png

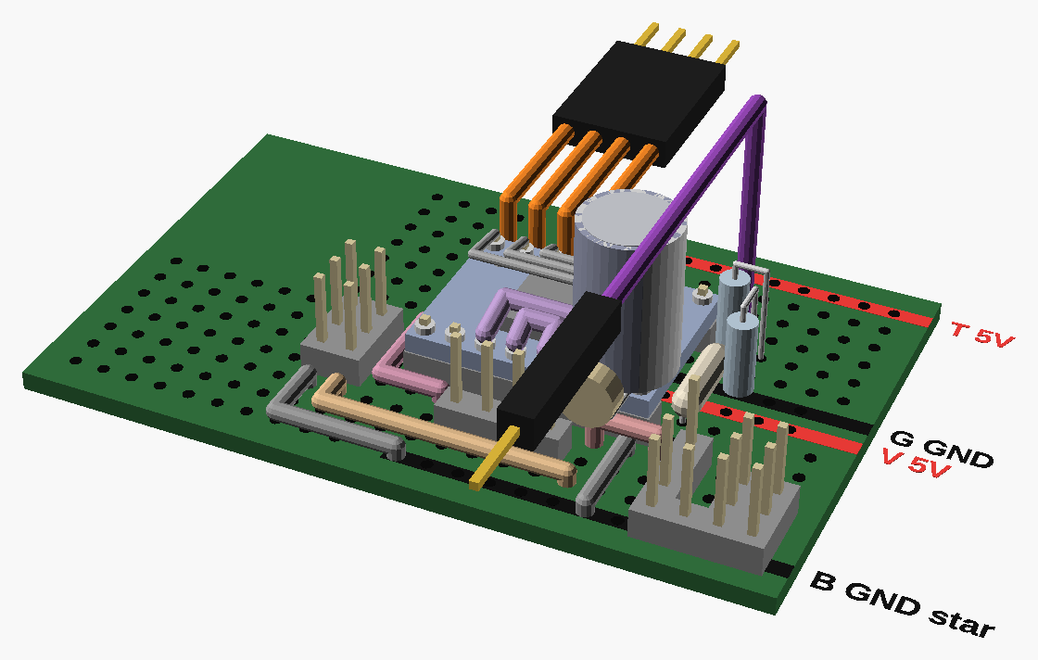
docs/guide/step_7.png
