Evan-Daruwalla/vision-autonomous-car/docs/guide/step_7_plan.png

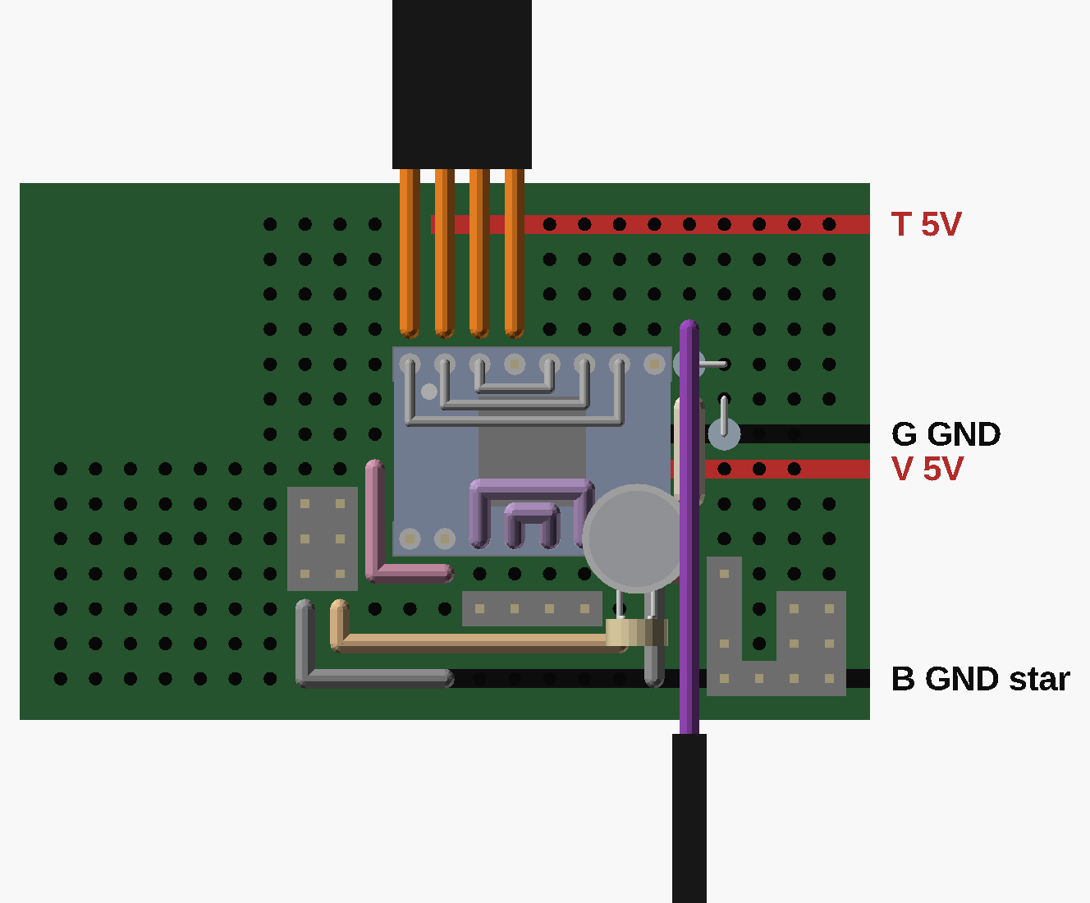
docs/guide/step_7_plan.png
