Evan-Daruwalla/vision-autonomous-car/docs/guide/step_8.png

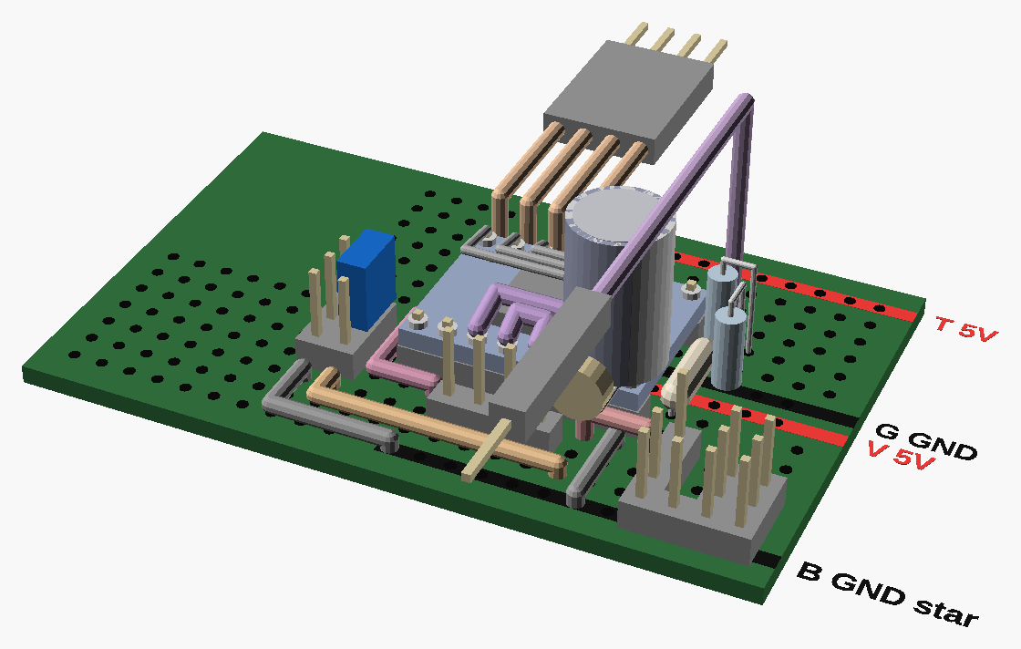
docs/guide/step_8.png
