Evan-Daruwalla/vision-autonomous-car/docs/step2b_power_wiring.png

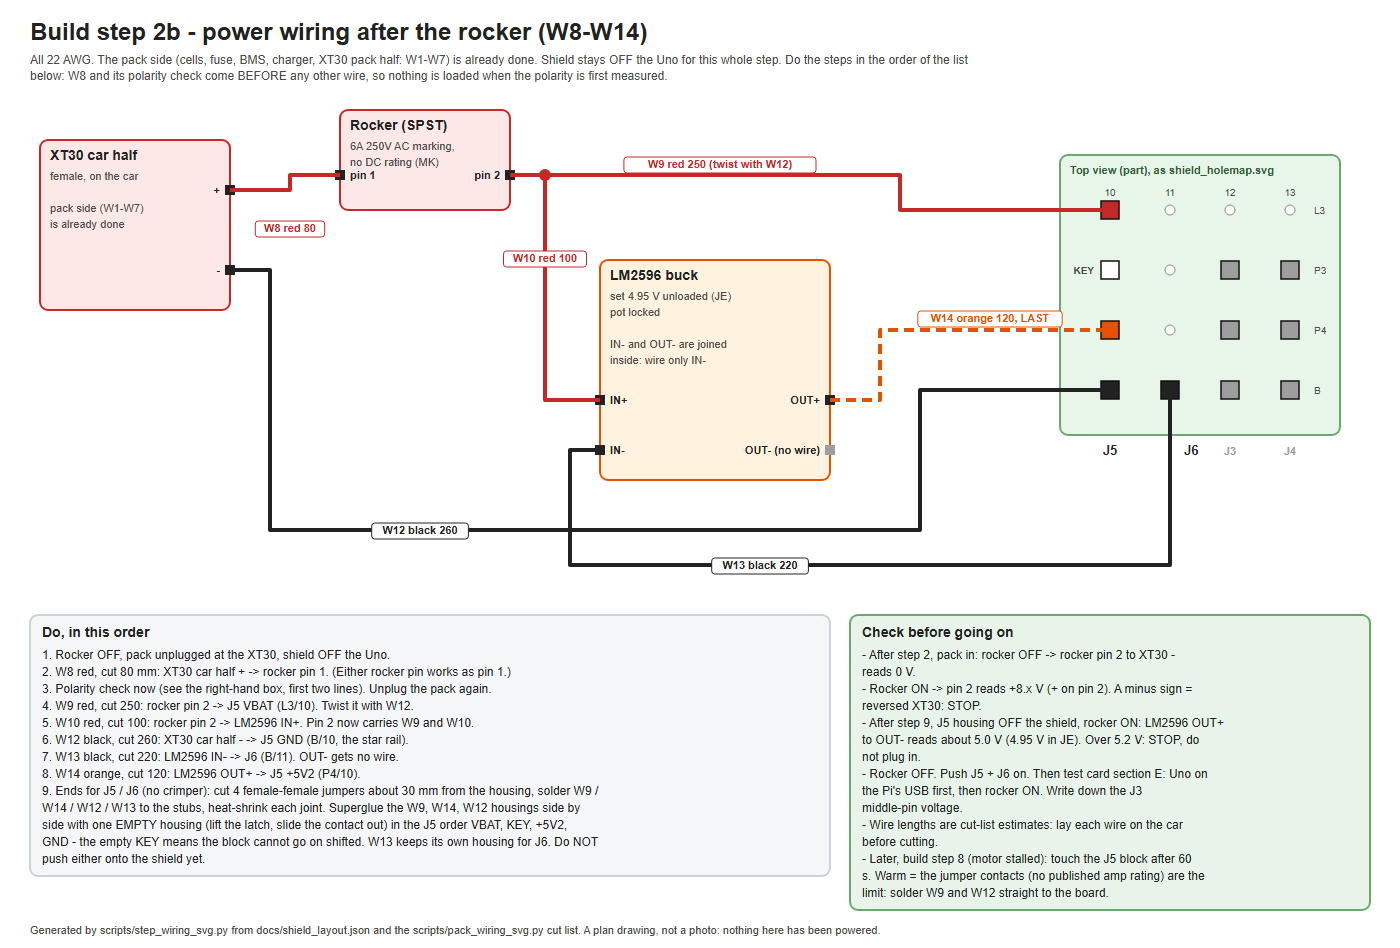
docs/step2b_power_wiring.png
