Evan-Daruwalla/vision-autonomous-car/docs/step5_motor_encoder.png

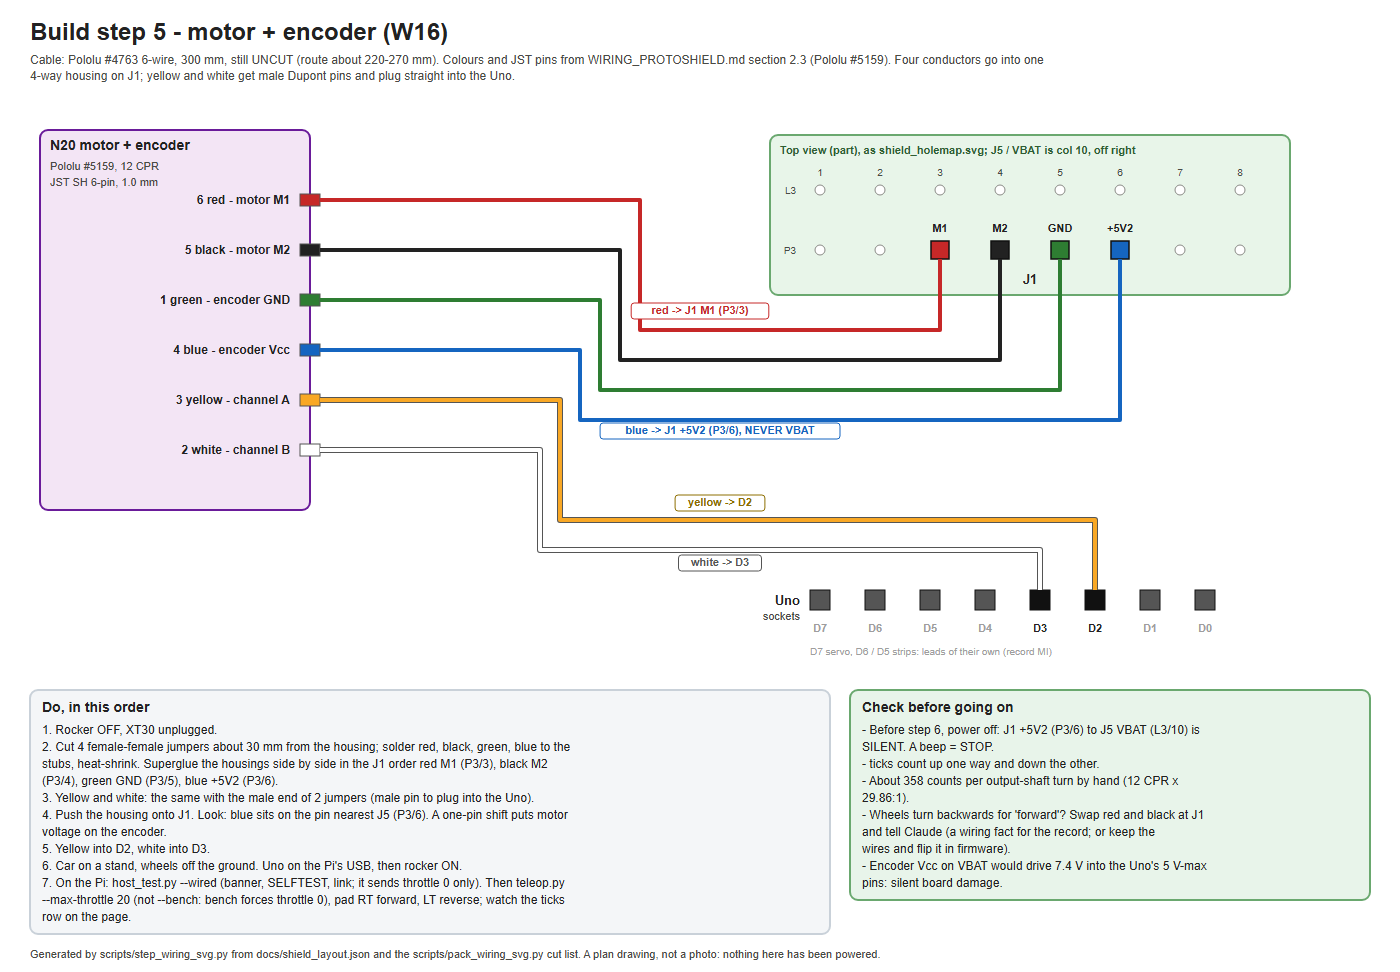
docs/step5_motor_encoder.png
