Evan-Daruwalla/vision-autonomous-car/docs/shield_test_card.png

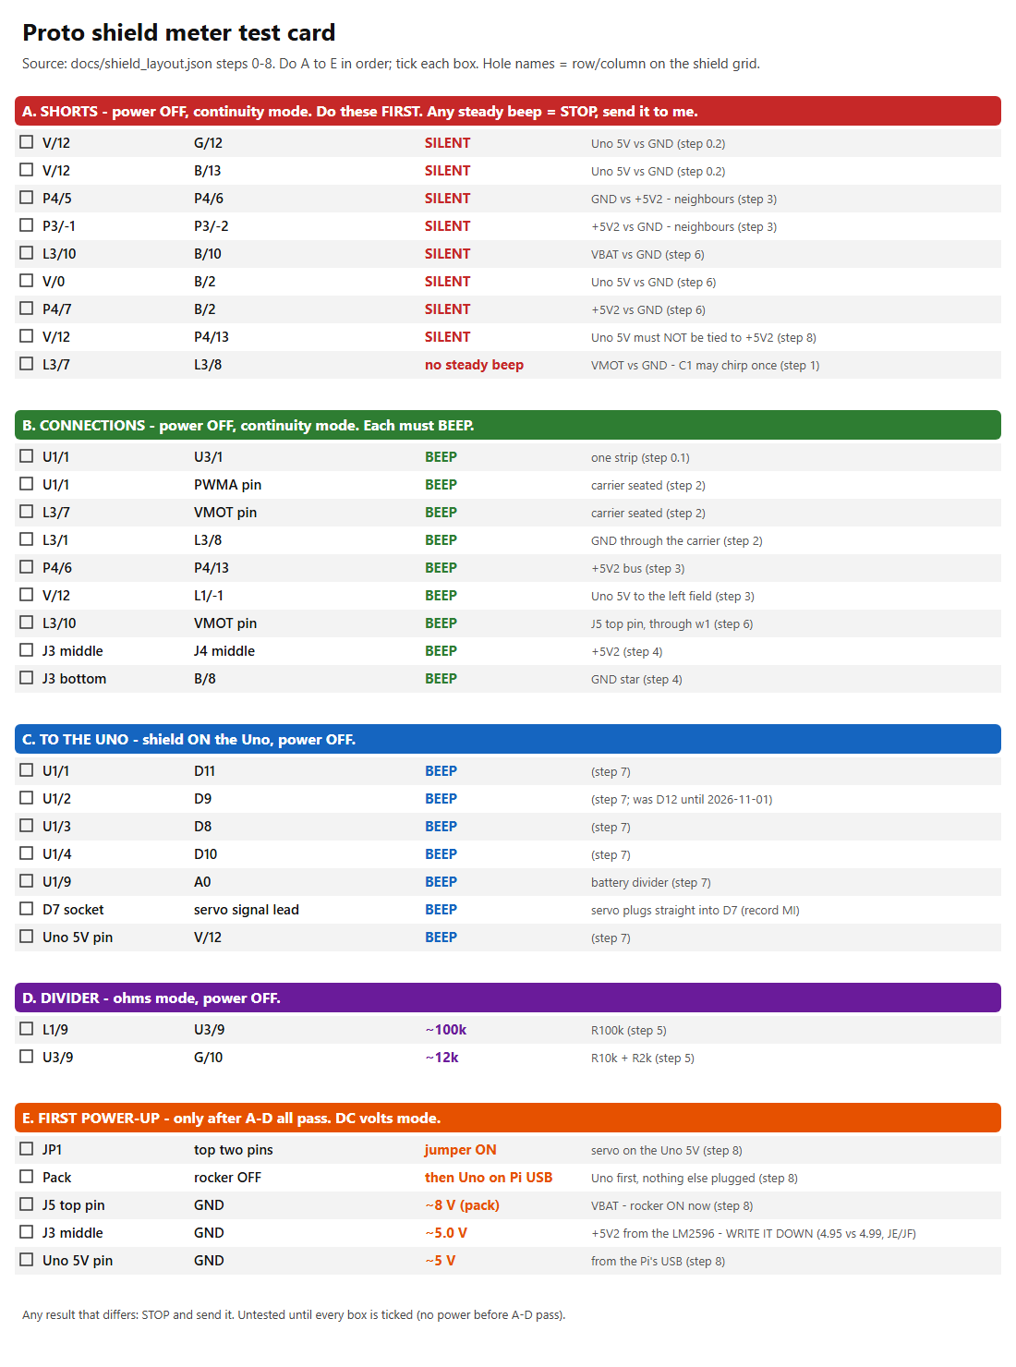
docs/shield_test_card.png
