Evan-Daruwalla/vision-autonomous-car/firmware/uno_control/uno_control.ino

/* uno_control — the actuation firmware. Implements firmware/SERIAL_PROTOCOL.md.
 *
 * LIGHTING REWRITTEN FOR WS2812B 2026-09-03 (PRD task 8e). applyLights() now
 * drives two Adafruit_NeoPixel strip objects on D6/D5 (was D4/D7 until 2026-10-31) (3 pixels each: white
 * front / red rear / amber indicator, cut-to-pixel-count per Appendix DA)
 * instead of the superseded 4-channel discrete-LED scheme this file used to
 * carry on D4-D7. Decisions this rewrite depended on, both made by Evan
 * 2026-09-03: the 3-pixel layout (Appendix DA), and DRL folds into the HEAD
 * pixel only, never the tail — see headColor()/tailColor() below.
 *
 * ⚠️ NOT VERIFIED ON HARDWARE. Compiled clean with arduino-cli (real output
 * in the record entry) — that is the only check that has run. No strip is
 * owned, nothing is wired, and this session has no serial/flash access, so
 * SELFTEST has not executed on a real board against the new checks and its
 * pass count is UNKNOWN until Evan flashes it and reads the real number.
 * Never quote a SELFTEST count for this file without having just run it.
 *
 * The interrupt question Appendix CX left open ("needs a firmware answer:
 * short strips, update only between control-loop ticks") is answered here in
 * TWO parts: the strip is short (3 px/segment, Appendix DA), and
 * applyLights() rate-limits its own NeoPixel::show() calls to 20 ms — see the
 * comment on LIGHTS_MIN_INTERVAL_MS for why that matters even though
 * handleFrame() only calls it once per 50 ms frame.
 *
 * Written 2026-09-02 (Appendix BO). This is the first firmware that drives
 * anything; uno_bringup/uno_memtest/uno_echo were measurements and
 * uno_packguard was one safety subsystem.
 *
 * LINK AND STATE MACHINE VERIFIED ON THE BOARD, ACTUATORS UNWIRED (2026-09-02,
 * pre-dates this lighting rewrite). firmware/host_test.py is the Pi-side gate.
 * No motor, servo, encoder, LED or pack exists — nothing in docs/BOM.md is
 * ordered — so every actuator path is verified only as a DECISION this
 * firmware made, never as something that physically moved.
 * 2026-10-13: the parts arrived (2026-10-10) and the SERVO is now wired to the
 * board and on the car; motor, encoder, LED strip and pack are still unwired.
 *
 * DEFECT FIXED 2026-09-02 (found by the scheduled daily-audit, Appendix BY;
 * fix recorded in Appendix CA): loop() sampled millis() once at the top, then
 * handed handleFrame() a SECOND, later millis(); the watchdog compared the
 * stale sample against the fresher stamp, the unsigned subtraction wrapped,
 * and the watchdog tripped in the SAME iteration as every good frame — after
 * the reply had already been sent, so no status byte ever showed it. Effect
 * with a motor wired: drive ~2 ms, brake ~48 ms, repeat. Both timestamps now
 * come from the one sample. The test that catches it probes `armed` inside
 * the watchdog window (host_test.py); the status-bit check that seemed
 * obvious PASSES on the broken build, which is its own lesson.
 *
 * THE SAFETY MODEL, which is the point of this file:
 *   Four independent things can stop the car, and they do NOT share one code
 *   path. That was the defect in the design before 2026-09-02 — ARMED, the
 *   watchdog and the pack cutoff all acted by writing D11, so one stuck timer
 *   register defeated all three at once.
 *     1. ARMED bit, required in EVERY command frame (not a latched mode)
 *     2. 150 ms watchdog on command arrival
 *     3. pack low-voltage cutoff, latched (packguard.h)
 *     4. D10 -> TB6612 STBY, which removes the bridge outputs in HARDWARE
 *        regardless of what the PWM and DIR pins are doing
 *
 * BRAKE THEN COAST, and the order is forced by the TB6612 truth table:
 *   IN1=H IN2=H            -> short brake  (stops the car)
 *   IN1=L IN2=L, PWM=H     -> outputs OFF  (coasts)
 *   STBY=L                 -> outputs OFF  (coasts, whatever DIR says)
 * So STBY LOW IS A COAST, NOT A STOP. Dropping STBY as the safety action would
 * leave the car rolling. Entering any unsafe state therefore brakes with STBY
 * still high for BRAKE_MS, and only then drops STBY. See SERIAL_PROTOCOL.md 1a.
 *
 * BOOT STATE IS OFF, and it is free: Uno pins are high-Z until setup() runs and
 * the Pololu #713 pulls STBY low internally, so the driver is disabled through
 * every reset — including the reset caused by the Pi OPENING THE SERIAL PORT.
 * D10 is therefore raised only after the first valid ARMED frame, never in
 * setup(). Do not "helpfully" enable it earlier.
 *
 * Serial 115200, binary frames. A lone '?' outside a frame prints a
 * human-readable status line; 'T' runs SELFTEST; 'B' toggles bench-quiet (LED
 * only -- see benchQuiet). None is a valid sync byte, but any of them CAN be a
 * payload byte, so 'T' and 'B' are refused while ARMED -- see rxFeed().
 */
#include <Arduino.h>
#include <Servo.h>
#include <Adafruit_NeoPixel.h>
#include "packguard.h"

// ---- pin map: firmware/SERIAL_PROTOCOL.md section 1 ------------------------
const uint8_t PIN_ENC_A   = 2;    // INT0
const uint8_t PIN_ENC_B   = 3;    // INT1 — nothing else may use D3
const uint8_t PIN_STRIP_L = 6;    // LEFT strip DIN (Appendix DA). Was D4 until 2026-10-31 (as-built wiring, record MD); D4 and D9 are now FREE. (2026-11-01: D9 is DIR_B; D4 and D12 are free.)
const uint8_t PIN_STRIP_R = 5;    // RIGHT strip DIN (was D7 until 2026-10-31) — its own pin: WS2812B data
                                  // is DIN->DOUT only, a cut segment cannot
                                  // share a feed (Appendix CY)
const uint8_t PIN_DIR_A  = 8;    // TB6612 AIN1+BIN1 (bridged; the "zero spare
                                 // PWM" reason died 2026-09-03 — one motor, two
                                 // channels, paralleled for the 2 A rating)
const uint8_t PIN_SERVO  = 7;    // Servo claims Timer1 (any pin works); was D9 until 2026-10-31
const uint8_t PIN_STBY   = 10;   // TB6612 STBY — master enable
const uint8_t PIN_MOTOR  = 11;   // Timer2 PWM
const uint8_t PIN_DIR_B  = 9;    // TB6612 AIN2+BIN2. Was D12 until 2026-11-01: on the car, D12 did not hold
                                 // LOW in forward (twitch) with its jumper in the right socket (Evan); D9 is
                                 // free and only ever digitalWrite here (Timer1's PWM on D9/D10 is lost to Servo)
const uint8_t PIN_STATUS = 13;

// ---- protocol --------------------------------------------------------------
const uint8_t SYNC_CMD = 0xA5;
const uint8_t SYNC_RPL = 0x5A;
const uint8_t CMD_LEN  = 7;
const uint8_t RPL_LEN  = 9;

// Declared HERE, above every function, and it must stay here. The Arduino
// preprocessor auto-generates function prototypes and inserts them near the top
// of the .ino, ABOVE anything you declare mid-file — so a function taking or
// returning a mid-file enum fails to compile with "'OutMode' does not name a
// type". Hit while compiling this file on 2026-09-02.
enum OutMode { OUT_DRIVE = 0, OUT_BRAKE = 1, OUT_OFF = 2 };
// What one received byte completed -- rxFeed(). Up here for the same reason.
enum RxEvent { RX_NONE = 0, RX_FRAME = 1, RX_BAD = 2, RX_CMD = 3 };

const uint16_t WATCHDOG_MS = 150;   // three missed frames at 20 Hz
const uint16_t BRAKE_MS    = 500;   // brake before coasting; see header

// Status bits. 0-3 are SERIAL_PROTOCOL.md v0.1; 4-5 are a v0.2 EXTENSION so the
// Pi can tell "throttle dead because the pack is flat" from "throttle dead
// because I stopped sending". Without it a cutoff is indistinguishable from a
// link fault, and the operator debugs the wrong thing.
const uint8_t ST_ARMED    = 0x01;
const uint8_t ST_WATCHDOG = 0x02;
const uint8_t ST_CRC_BAD  = 0x04;
const uint8_t ST_DROPPED  = 0x08;
const uint8_t ST_PACK_SHIFT = 4;    // 2 bits: PackState

// ---- actuator calibration --------------------------------------------------
/* THE PINION SWEEP IS MEASURED: ~180 degrees full-left to full-right (Evan,
 * 2026-09-02). That makes the span derivable instead of guessed.
 *
 * A standard hobby servo maps 1000-2000 us onto 180 degrees, i.e. 500 us per
 * 90 degrees. Centre-to-full-lock is half the sweep = 90 degrees = 500 us, so
 * the GEOMETRIC maximum is SERVO_US_SPAN = 500, and an MG90S at 180 degrees is
 * a 1:1 match to this rack with no gearing at all.
 *
 * THE OLD VALUE OF 300 WAS A REAL DEFECT, not just conservative: it reached
 * 54 of the 90 available degrees (60% of lock), giving ~19.2 degrees at the
 * road wheel against the measured 32, which is a turn radius 1.79x LARGER than
 * the mechanism can actually achieve. The car would have failed corners it is
 * geometrically capable of, and nothing would have said why.
 *
 * WHY 450 AND NOT 500. Servo centre and rack centre are aligned by hand at
 * assembly, and that alignment is unmeasured. At the full 500 any centring
 * error drives one side into a Lego hard stop, which stalls the servo and cooks
 * it. 450 keeps 10% of margin per side (81 of 90 degrees, ~28.8 degrees at the
 * road wheel, R = 1.819 x wheelbase).
 * shortcut: one symmetric span, no per-side trim. CEILING: it wastes lock on
 * whichever side has more clearance. UPGRADE TRIGGER: if bench centring cannot
 * get both stops within ~5 degrees, split this into LEFT and RIGHT limits.
 *
 * STILL UNVERIFIED: MG90S pulse range varies by unit (some are 500-2400 us for
 * 180 degrees, not 1000-2000). Confirm the real endpoints on the bench before
 * trusting 450, and never command full lock until you have. */
/* CENTRE 1525, not 1500 (2026-10-13, records HM-HQ): with the steering
 * gear backlash compensated (below), the rack lands where the command says, and
 * Evan's two straight-wheel procedures (450 -> 1650 -> 1500 and
 * 2600 -> 1400 -> 1500) both fit a backlash model whose straight-ahead rack
 * position is 1525. Fit to two observations, UNVERIFIED on the bench.
 * MEASURED 2026-10-13 ~14:10 (record HX): holding without a return, straight
 * is 1600 from the left and 1450 from the right -> centre 1525 confirmed. */
const uint16_t SERVO_US_CENTRE = 1525;
const uint16_t SERVO_US_SPAN   = 450;   // +/- from centre; 90% of measured lock
const uint16_t SERVO_US_SPAN_GEOMETRIC = 500;  // 100% of lock, for SELFTEST

/* STEERING BACKLASH COMPENSATION (Evan, 2026-10-13, records HM-HR).
 * The gear pair before the rack has tooth clearance: the rack lags the servo by
 * half the gap in the direction of motion. Was 125 per side (record HR, a
 * fit to two observations). MEASURED 2026-10-13 (record HX, servo_bench, no return to 1500): straight is
 * held at 1600 approaching from the left and 1450 from the right, the same
 * from a 950/2100 swing and from the 450/2600 locks -> gap 150 us, 75 per
 * side. The 125 fit was wrong because both its procedures ended in a return
 * to 1500, which re-crossed the gap.
 * Evan's choice: overshoot every target by the half-gap in the direction of
 * the last move and HOLD it (no return). The servo then sits at
 * target +/- 75, the rack exactly at the target, and the gear teeth stay
 * pressed. A reversal crosses the whole gap before the rack moves.
 * Reversal deadband (audit C1-2, record NQ): without it, a command dithering
 * by one steer step (4.5 us) flipped the overshoot side and the servo jumped
 * about 154 us back and forth across the gap. Now a reversal of
 * SERVO_REVERSE_DEADBAND_US or less HOLDS the current pulse: no servo motion,
 * the rack stays at the last target (error at most the deadband). The value is
 * NOT measured; re-tune it on the bench. */
const uint16_t SERVO_BACKLASH_US = 75;       // half the gear gap (measured, HX)
// A reversal of this size or less HOLDS the current pulse: no servo motion, and
// the rack stays at the last target, so the rack error is at most this value.
// 10 us is just over 2 steer steps (4.5 us each). It is NOT measured; re-tune
// it on the bench. Source: audit C1-2, record NQ.
const uint16_t SERVO_REVERSE_DEADBAND_US = 10;
// Hard limits for the commanded pulse, overshoot included. The LEFT lock is the
// rack's own stop (record HP): its first-contact pulse is NOT measured yet, so
// the left limit sits 100 us inside the 450 us lock seen on the bench. The right
// lock (~2600) is the servo's end of travel (HO). With SPAN 450 the commands
// stay within 950..2100 and never reach either limit; the Servo library's own
// 544-2400 clamp (unlimited attach) also applies.
const uint16_t SERVO_US_MIN_SAFE = 550;
const uint16_t SERVO_US_MAX_SAFE = 2600;

// Backlash compensator state. target == 0 means "no command yet". Declared up
// here, above every function: the .ino preprocessor inserts function prototypes
// before the first function, so a struct declared later breaks the build.
struct Backlash {
  uint16_t target;    // last requested pulse (what the rack should end at)
  int8_t   dir;       // +1 last move went up, -1 down
};

// Duty cap: the N20 is a 6 V motor on a pack that reaches 8.4 V. 71% of full
// scale keeps mean voltage at ~6 V (docs/BOM.md row 5 reasoning).
const uint8_t MOTOR_DUTY_MAX = 181;     // 0.71 * 255

/* Provisional brightness, derived from Appendix CZ's stated current budget —
 * never bench-verified, no strip owned. White scaled to ~33% of a WS2812B's
 * ~60 mA full-white max (~20 mA); red/amber to ~50% of a single sub-LED's
 * ~20 mA max (~10 mA), matching the old scheme's "plainly bright" 10 mA
 * reference point (Appendix BO). Recompute once BOM Verify item 5 and a real
 * bench brightness check exist. */
const uint8_t STRIP_HEAD_FULL  = 85;    // 33% of 255
const uint8_t STRIP_HEAD_DIM   = 20;    // DRL level — folds into the HEAD
                                        // pixel only, never the tail (Evan,
                                        // 2026-09-03); ratio matches the old
                                        // scheme's LIGHT_DIM:LIGHT_FULL (60:255)
const uint8_t STRIP_TAIL_LEVEL = 128;   // 50% of 255; tail never dims
const uint8_t STRIP_AMBER_R    = 128;   // 50% of 255
const uint8_t STRIP_AMBER_G    = 51;    // ~40% of R, a warm amber mix — not measured
const uint16_t BLINK_MS  = 340;         // ~1.5 Hz, each half

const uint8_t PIXELS_PER_STRIP = 3;     // cut to PIXEL count, not length (Appendix DA)
// Head + indicator are the 2 front-corner pixels; the tail is pixel 2 at the REAR
// on a 3-wire jumper (WIRING_PROTOSHIELD.md section 2.5, 2026-10-11).
const uint8_t PX_HEAD = 0, PX_IND = 1, PX_TAIL = 2;

// ---- state -----------------------------------------------------------------
Servo    steerServo;
PackGuard pack;
Adafruit_NeoPixel stripL(PIXELS_PER_STRIP, PIN_STRIP_L, NEO_GRB + NEO_KHZ800);
Adafruit_NeoPixel stripR(PIXELS_PER_STRIP, PIN_STRIP_R, NEO_GRB + NEO_KHZ800);

volatile int32_t encTicks = 0;
volatile uint8_t encPrev  = 0;

uint8_t  rxBuf[CMD_LEN];
uint8_t  rxLen = 0;
uint32_t lastFrameMs = 0;
bool     everArmed   = false;      // gates the FIRST rise of STBY
bool     armed       = false;
uint32_t unsafeSince = 0;          // 0 = currently safe/driving
int8_t   lastSteer   = 0;          // watchdog HOLDS steering, does not centre
uint8_t  lastSeq     = 0;
uint8_t  statusBits  = 0;
uint8_t  loopDt      = 0;

/* QUIET STATUS LED ON A BENCH BOARD -- and why it is not just "stop flashing".
 *
 * A floating A0 reads ~10,248 mV (measured, Appendix BJ) and so does a sense
 * wire that has FALLEN OFF. In the instant those are the same reading, which
 * is the whole reason the upper fault band exists. Going quiet on sight of a
 * floating pin would also go quiet when the wire drops off a moving car --
 * the case the indicator exists for.
 *
 * They differ in HISTORY, though, and history is free: a board that has NEVER
 * seen a plausible pack was never wired (a bench), while a car whose wire
 * drops has seen one. pack.everPlausible carries that, so the common case --
 * this board, on a desk, with nothing attached -- is quiet automatically and
 * every power cycle, with no command to remember.
 *
 * 'B' remains as a manual override for the case history cannot cover: a board
 * that HAS seen a real pack and is now deliberately being benched.
 *
 * NEITHER PATH TOUCHES SAFETY. Throttle inhibit, STBY and outputModeFor() are
 * untouched -- the car stays exactly as disabled as it was, and SELFTEST
 * asserts that. Only PACK_FAULT (no sensor) is ever silenced; a latched
 * PACK_CUTOFF is a genuinely flat battery and keeps flashing regardless.
 * Neither is persisted: any reset clears both, and the Pi opening the serial
 * port resets the board.
 */
bool     benchQuiet  = false;

// ---- pure helpers: everything SELFTEST can check ---------------------------

uint8_t crc8(const uint8_t *d, uint8_t n) {
  // Bitwise, not a 256-byte table: at 20 Hz this costs microseconds, and the
  // Uno has 2048 B of SRAM to protect.
  uint8_t c = 0;
  while (n--) {
    c ^= *d++;
    for (uint8_t i = 0; i < 8; i++) c = (c & 0x80) ? (uint8_t)((c << 1) ^ 0x07) : (uint8_t)(c << 1);
  }
  return c;
}

/* Feed ONE received byte to a command-frame parser (buf, len). On RX_FRAME
 * and RX_BAD the 7 completed bytes are copied to `out` first.
 *
 * RESYNC ON A BAD CRC (daily-audit FD row 15, fixed 2026-10-10). The parser
 * used to throw all 7 bytes away. When frame A has LOST a byte, its 7th byte
 * is frame B's sync, so B's payload then arrived with the parser idle: B was
 * lost, and any payload byte equal to '?', 'T' or 'B' ran as a command
 * (steer 63 is '?'). Now a bad frame is rescanned from byte 1 for the next
 * 0xA5 and that tail is kept. A false 0xA5 inside a payload just fails its own
 * CRC and is rescanned again, so the real sync is still reached -- at the cost
 * of one extra CRC_BAD reply per false sync.
 *
 * NOT CLOSED BY THIS: if a frame's SYNC byte itself is lost, its payload still
 * arrives with the parser idle, and no byte-level rule can tell it from a
 * human typing. cmdAllowed() is what keeps that harmless while driving. */
RxEvent rxFeed(uint8_t *buf, uint8_t &len, uint8_t c, uint8_t *out) {
  if (len == 0) {
    if (c == SYNC_CMD) { buf[len++] = c; return RX_NONE; }
    return (c == '?' || c == 'T' || c == 'B') ? RX_CMD : RX_NONE;
  }
  buf[len++] = c;
  if (len < CMD_LEN) return RX_NONE;
  memcpy(out, buf, CMD_LEN);
  if (crc8(buf, CMD_LEN) == 0) { len = 0; return RX_FRAME; }
  uint8_t k = 1;
  while (k < CMD_LEN && buf[k] != SYNC_CMD) k++;
  len = (uint8_t)(CMD_LEN - k);
  memmove(buf, buf + k, len);
  return RX_BAD;
}

// While ARMED a Pi is driving, so a lone 'T' or 'B' is far more likely to be an
// orphaned payload byte than a person at a terminal: refuse them. '?' only
// prints, and host_test.py probes `armed` with it INSIDE the armed window.
bool cmdAllowed(uint8_t c, bool isArmed) {
  return c == '?' || !isArmed;
}

uint16_t steerToUs(int8_t steer) {
  if (steer > 100) steer = 100;
  if (steer < -100) steer = -100;
  return (uint16_t)(SERVO_US_CENTRE + ((int32_t)steer * SERVO_US_SPAN) / 100);
}

/* Pure: returns the pulse to write for a requested target, updating `b`.
 * The direction only changes on a reversal larger than SERVO_REVERSE_DEADBAND_US;
 * smaller reversals hold the pulse. Repeated calls with the same target (the
 * watchdog path calls this thousands of times a second) keep the same
 * overshoot. The very first call approaches from below (dir +1) so the start
 * is deterministic. */
uint16_t backlashCommand(Backlash &b, uint16_t target) {
  if (b.target == 0) {
    b.dir = 1;
    b.target = target;
  } else if (target != b.target) {
    int8_t d = target > b.target ? 1 : -1;
    if (d == b.dir) {
      b.target = target;
    } else {
      uint16_t delta = d > 0 ? target - b.target : b.target - target;
      if (delta > SERVO_REVERSE_DEADBAND_US) {
        b.dir = d;
        b.target = target;
      }
      // else: hold. The pulse does not change, so the servo does not move.
    }
  }
  int32_t us = (int32_t)b.target + b.dir * (int32_t)SERVO_BACKLASH_US;
  if (us < SERVO_US_MIN_SAFE) us = SERVO_US_MIN_SAFE;
  if (us > SERVO_US_MAX_SAFE) us = SERVO_US_MAX_SAFE;
  return (uint16_t)us;
}

uint8_t throttleToDuty(int8_t t) {
  int16_t a = t < 0 ? -(int16_t)t : (int16_t)t;
  if (a > 100) a = 100;
  return (uint8_t)((a * (int16_t)MOTOR_DUTY_MAX) / 100);
}

// Pure pixel-colour helpers, same discipline as steerToUs/throttleToDuty:
// SELFTEST checks these directly rather than a copy of the logic.
uint32_t headColor(uint8_t bits) {
  if (!(bits & 0x01)) return 0;
  uint8_t v = (bits & 0x10) ? STRIP_HEAD_DIM : STRIP_HEAD_FULL;
  return Adafruit_NeoPixel::Color(v, v, v);
}
uint32_t tailColor(uint8_t bits) {
  // bit4 (dim/DRL) deliberately does not touch this pixel — see file header.
  return (bits & 0x02) ? Adafruit_NeoPixel::Color(STRIP_TAIL_LEVEL, 0, 0) : 0;
}
uint32_t indicatorColor(bool on) {
  return on ? Adafruit_NeoPixel::Color(STRIP_AMBER_R, STRIP_AMBER_G, 0) : 0;
}

/* The whole safety decision, as a pure function of the four inputs, so
 * SELFTEST exercises the shipping logic rather than a copy of it — the same
 * discipline that made uno_packguard testable without a battery. */
OutMode outputModeFor(bool isArmed, bool packInhibit, bool wdTripped,
                      bool hasEverArmed, uint32_t msUnsafe) {
  if (!hasEverArmed) return OUT_OFF;                 // never enabled since boot
  if (isArmed && !packInhibit && !wdTripped) return OUT_DRIVE;
  return (msUnsafe < BRAKE_MS) ? OUT_BRAKE : OUT_OFF;
}

// Steering follows commands only in OUT_DRIVE - the same gate as the motor.
bool steerAllowed(OutMode m) { return m == OUT_DRIVE; }

// ---- encoder ---------------------------------------------------------------
// 4x quadrature. Raw counts only: SERIAL_PROTOCOL.md section 6 makes converting
// ticks to distance the Pi's job, and counts-per-rev is unverified until the
// motor is in hand (#5159 is spec'd 12 CPR at the motor shaft, 29.86:1).
const int8_t QTAB[16] = { 0, -1, 1, 0,  1, 0, 0, -1,  -1, 0, 0, 1,  0, 1, -1, 0 };

/* OPEN: the SIGN is a convention, not a measurement. This table happens to
 * count the 00->01->11->10 cycle as NEGATIVE. Whether that is "forwards" for
 * this car depends on how the encoder sits on the motor and how the motor sits
 * in the drivetrain -- none of which exists yet. Flip this to -1 once the car
 * rolls forward and ticks go down. Discovered 2026-09-02 by a SELFTEST that
 * asserted a sign it could not know. */
const int8_t ENCODER_SIGN = +1;

void encISR() {
  uint8_t s = (uint8_t)((digitalRead(PIN_ENC_A) << 1) | digitalRead(PIN_ENC_B));
  encTicks += (int32_t)ENCODER_SIGN * QTAB[((encPrev << 2) | s) & 0x0F];
  encPrev = s;
}

int32_t readTicks() {
  noInterrupts();                 // int32 is four non-atomic bytes on an AVR
  int32_t t = encTicks;
  interrupts();
  return t;
}

// ---- actuator writes -------------------------------------------------------
Backlash steerComp = {0, 0};

void applyOutputs(OutMode mode, int8_t steer, int8_t throttle) {
  switch (mode) {
    case OUT_DRIVE:
      digitalWrite(PIN_STBY, HIGH);
      if (throttle == 0) {                       // explicit short brake
        digitalWrite(PIN_DIR_A, HIGH); digitalWrite(PIN_DIR_B, HIGH);
        analogWrite(PIN_MOTOR, 0);
      } else {
        digitalWrite(PIN_DIR_A, throttle > 0 ? HIGH : LOW);
        digitalWrite(PIN_DIR_B, throttle > 0 ? LOW  : HIGH);
        analogWrite(PIN_MOTOR, throttleToDuty(throttle));
      }
      break;
    case OUT_BRAKE:                              // STBY stays HIGH or it coasts
      digitalWrite(PIN_STBY, HIGH);
      digitalWrite(PIN_DIR_A, HIGH); digitalWrite(PIN_DIR_B, HIGH);
      analogWrite(PIN_MOTOR, 0);
      break;
    case OUT_OFF:
      analogWrite(PIN_MOTOR, 0);
      digitalWrite(PIN_DIR_A, LOW); digitalWrite(PIN_DIR_B, LOW);
      digitalWrite(PIN_STBY, LOW);               // hardware disable
      break;
  }
  // Actuators are inert unless ARMED (SERIAL_PROTOCOL.md): the servo follows the
  // command only when the motor may drive too. Otherwise it keeps its last pulse
  // (the Servo library repeats it) - held, not centred. Fixed 2026-10-13: the
  // daily audit (record HJ) found the servo following DISARMED frames.
  if (steerAllowed(mode))
    steerServo.writeMicroseconds(backlashCommand(steerComp, steerToUs(steer)));
}

uint32_t lastLightsMs = 0;
const uint16_t LIGHTS_MIN_INTERVAL_MS = 20;
/* Rate-limited on purpose, not for efficiency. handleFrame() calls this once
 * per received 20 Hz command (every ~50 ms), so under a healthy link this
 * limit never trips. But loop()'s watchdog branch below also calls
 * applyLights() — on EVERY free-running loop() iteration while the link is
 * down, which is thousands of times a second, not once per 50 ms.
 * NeoPixel::show() disables interrupts for the duration of the bit-bang
 * write (~30us/pixel x 3 = ~90us per strip, Appendix CZ); calling it
 * unthrottled from a tight loop would make the encoder blind almost
 * continuously during any watchdog trip, instead of the ~0.03%/tick Appendix
 * CZ estimated for ONE call per control-loop tick. This is the firmware
 * answer Appendix CX asked for ("update only between control-loop ticks"),
 * and it holds for both call sites with no special-casing at either one.
 * 20 ms is comfortably under the 50 ms frame period, so a real command never
 * gets silently dropped by this gate (asserted in SELFTEST). */
void applyLights(uint8_t bits, bool hazard, uint32_t now) {
  if (lastLightsMs != 0 && now - lastLightsMs < LIGHTS_MIN_INTERVAL_MS) return;
  lastLightsMs = now;

  uint32_t head = headColor(bits);
  uint32_t tail = tailColor(bits);
  bool phase = (now / BLINK_MS) & 1;
  bool l = hazard ? phase : ((bits & 0x04) && phase);
  bool r = hazard ? phase : ((bits & 0x08) && phase);

  stripL.setPixelColor(PX_HEAD, head);
  stripL.setPixelColor(PX_TAIL, tail);
  stripL.setPixelColor(PX_IND,  indicatorColor(l));
  stripL.show();

  stripR.setPixelColor(PX_HEAD, head);
  stripR.setPixelColor(PX_TAIL, tail);
  stripR.setPixelColor(PX_IND,  indicatorColor(r));
  stripR.show();
}

// ---- reply -----------------------------------------------------------------
void sendReply(uint8_t seq, int32_t ticks, uint8_t status, uint8_t dt) {
  uint8_t r[RPL_LEN];
  r[0] = SYNC_RPL;
  r[1] = seq;
  r[2] = (uint8_t)(ticks      );
  r[3] = (uint8_t)(ticks >>  8);
  r[4] = (uint8_t)(ticks >> 16);
  r[5] = (uint8_t)(ticks >> 24);
  r[6] = status;
  r[7] = dt;
  r[8] = crc8(r, RPL_LEN - 1);
  Serial.write(r, RPL_LEN);
}

void printStatus() {
  Serial.print(F("? armed=")); Serial.print(armed);
  Serial.print(F(" everArmed=")); Serial.print(everArmed);
  Serial.print(F(" pack=")); Serial.print((int)pack.state);
  Serial.print(F(" mv=")); Serial.print(pack.readMv());
  Serial.print(F(" ticks=")); Serial.print(readTicks());
  Serial.print(F(" status=0x")); Serial.print(statusBits, HEX);
  Serial.print(F(" dt=")); Serial.print(loopDt);
  Serial.print(F(" stby=")); Serial.print(digitalRead(PIN_STBY));
  Serial.print(F(" benchQuiet=")); Serial.print(benchQuiet);
  Serial.print(F(" everPlausible=")); Serial.println(pack.everPlausible);
}

// ---- selftest --------------------------------------------------------------
void selftest() {
  uint8_t pass = 0, fail = 0;
  #define CHECK(c, d) do { if (c) pass++; else { fail++; \
      Serial.print(F("  FAIL: ")); Serial.println(F(d)); } } while (0)

  // CRC8/ATM, poly 0x07, init 0. Reference vector: "123456789" -> 0xF4.
  const uint8_t v[9] = {'1','2','3','4','5','6','7','8','9'};
  CHECK(crc8(v, 9) == 0xF4, "crc8 check vector 123456789 = 0xF4");
  uint8_t f[CMD_LEN] = { SYNC_CMD, 1, 0, 0, 0, 1, 0 };
  f[6] = crc8(f, CMD_LEN - 1);
  CHECK(crc8(f, CMD_LEN) == 0, "crc over a whole valid frame is 0");
  f[3] ^= 0xFF;
  CHECK(crc8(f, CMD_LEN) != 0, "a corrupted frame fails crc");

  // steering map
  CHECK(steerToUs(0)    == SERVO_US_CENTRE, "steer 0 is centre");
  CHECK(steerToUs(100)  == SERVO_US_CENTRE + SERVO_US_SPAN, "steer +100 is full right");
  CHECK(steerToUs(-100) == SERVO_US_CENTRE - SERVO_US_SPAN, "steer -100 is full left");
  CHECK(steerToUs(127)  == steerToUs(100),  "over-range steer clamps");
  /* Guards the defect fixed 2026-09-02: a span far under the measured lock
   * silently caps steering. The pinion sweeps 180 deg, so centre-to-lock is
   * 500 us; anything below ~85% of that is throwing away turning circle. */
  CHECK(SERVO_US_SPAN <= SERVO_US_SPAN_GEOMETRIC,
        "span must not exceed the measured mechanical lock");
  CHECK(SERVO_US_SPAN * 100 / SERVO_US_SPAN_GEOMETRIC >= 85,
        "span must reach >=85% of lock, or the car loses turning circle");
  CHECK(steerToUs(-128) == steerToUs(-100), "under-range steer clamps");

  // throttle map, including the duty cap that protects a 6V motor on 8.4V
  CHECK(throttleToDuty(0)    == 0,               "throttle 0 is zero duty");
  CHECK(throttleToDuty(100)  == MOTOR_DUTY_MAX,  "throttle 100 is the CAP, not 255");
  CHECK(throttleToDuty(-100) == MOTOR_DUTY_MAX,  "reverse uses magnitude");
  CHECK(throttleToDuty(127)  == MOTOR_DUTY_MAX,  "over-range throttle clamps");
  CHECK(MOTOR_DUTY_MAX < 255,                    "duty MUST be capped below full scale");

  // lighting: pure colour helpers (task 8e, WS2812B rewrite)
  CHECK(headColor(0x00) == 0, "head off is pixel off");
  CHECK(headColor(0x01) == Adafruit_NeoPixel::Color(STRIP_HEAD_FULL, STRIP_HEAD_FULL, STRIP_HEAD_FULL),
        "head on, no dim, is full white");
  CHECK(headColor(0x11) == Adafruit_NeoPixel::Color(STRIP_HEAD_DIM, STRIP_HEAD_DIM, STRIP_HEAD_DIM),
        "head on + dim bit is the DRL level");
  CHECK(tailColor(0x00) == 0, "tail off is pixel off");
  CHECK(tailColor(0x02) == Adafruit_NeoPixel::Color(STRIP_TAIL_LEVEL, 0, 0), "tail on is red");
  CHECK(tailColor(0x12) == tailColor(0x02),
        "the dim bit does NOT touch the tail pixel -- DRL is head-only by decision");
  CHECK(indicatorColor(false) == 0, "indicator off is pixel off");
  CHECK(indicatorColor(true) == Adafruit_NeoPixel::Color(STRIP_AMBER_R, STRIP_AMBER_G, 0),
        "indicator on is amber");
  CHECK(LIGHTS_MIN_INTERVAL_MS < 50,
        "the lights rate limit must stay under the 20 Hz frame period, or a real update gets dropped");

  // the safety decision
  CHECK(outputModeFor(true,  false, false, false, 0) == OUT_OFF,
        "before the first ARMED frame the driver stays OFF");
  CHECK(outputModeFor(true,  false, false, true,  0) == OUT_DRIVE,
        "armed, healthy, fed -> DRIVE");
  CHECK(outputModeFor(false, false, false, true,  0) == OUT_BRAKE,
        "disarm brakes FIRST");
  CHECK(outputModeFor(false, false, false, true,  BRAKE_MS) == OUT_OFF,
        "and coasts only after BRAKE_MS");
  CHECK(outputModeFor(true,  true,  false, true,  0) == OUT_BRAKE,
        "pack cutoff brakes even while armed");
  CHECK(outputModeFor(true,  false, true,  true,  0) == OUT_BRAKE,
        "watchdog brakes even while armed");
  CHECK(outputModeFor(true,  true,  false, true,  BRAKE_MS + 1) == OUT_OFF,
        "a sustained cutoff ends in hardware disable");
  CHECK(outputModeFor(true,  false, false, true,  9999) == OUT_DRIVE,
        "a healthy armed frame overrides a stale unsafe timer");

  // everPlausible: false until a sane 2S reading is seen, then sticky.
  PackGuard q; q.simMode = true;
  CHECK(!q.everPlausible,                 "everPlausible starts false");
  q.simMv = 10248; q.poll(1000);
  CHECK(!q.everPlausible,                 "a floating-pin reading is NOT plausible");
  CHECK(q.state == PACK_FAULT,            "...and still faults");
  q.simMv = 7400;  q.poll(2000);
  CHECK(q.everPlausible,                  "a real 2S reading sets it");
  q.simMv = 10248; q.poll(3000);
  CHECK(q.everPlausible,                  "it STAYS set - a wire that falls off after "
                                          "a good reading must still be loud");
  CHECK(q.state == PACK_FAULT,            "...and faults again");

  // bench-quiet is an LED concession and must never be a safety one.
  bool savedQuiet = benchQuiet;
  benchQuiet = true;
  CHECK(outputModeFor(true, true, false, true, 0) == OUT_BRAKE,
        "bench-quiet must NOT re-enable drive while the pack inhibits");
  CHECK(outputModeFor(true, true, false, true, BRAKE_MS + 1) == OUT_OFF,
        "bench-quiet must NOT keep STBY up through a sustained inhibit");
  // Silencing the watchdog BLINK must not silence the watchdog itself.
  CHECK(outputModeFor(false, false, true, true, 0) == OUT_BRAKE,
        "a watchdog trip still brakes even when its blink is suppressed");
  CHECK(outputModeFor(false, false, true, false, 0) == OUT_OFF,
        "...and before anything ever armed, the driver stays OFF");
  benchQuiet = savedQuiet;

  // pack guard — the transitions that matter, against the copied logic
  PackGuard g; g.simMode = true;
  CHECK(g.step(7400, 1000) == PACK_OK,     "7.4V is OK");
  CHECK(g.step(6300, 1000) == PACK_WARN,   "below warn is WARN");
  CHECK(g.step(5900, 10000) == PACK_WARN,  "brief dip is not a cut");
  CHECK(g.step(5900, 10500) == PACK_CUTOFF, "sustained 500ms latches");
  CHECK(g.step(8400, 12000) == PACK_CUTOFF, "latch survives a full pack");
  CHECK(g.step(10248, 13000) == PACK_FAULT, "a fault reading outranks the latch: FAULT names the real problem");
  CHECK(g.latched,                          "...but the latch SURVIVES underneath it");
  CHECK(g.step(7400, 14000) == PACK_CUTOFF, "so a sane reading returns to CUTOFF, not OK");
  PackGuard h; h.simMode = true;
  CHECK(h.step(10248, 100) == PACK_FAULT,  "floating A0 (10248mV measured) is FAULT");
  CHECK(!h.latched,                         "FAULT must not set the cutoff latch");
  h.state = PACK_FAULT; CHECK(h.inhibits(), "FAULT inhibits throttle");
  h.state = PACK_WARN;  CHECK(!h.inhibits(),"WARN does NOT inhibit");

  /* Quadrature. WHICH direction is "forward" is NOT knowable until the encoder
   * is on a motor and the motor is on the car, so asserting a sign here would be
   * asserting something unverifiable. Assert only what is true either way. */
  int8_t oneWay = 0, other = 0;
  const uint8_t seqf[5] = { 0, 1, 3, 2, 0 };          // the Gray cycle
  for (uint8_t i = 0; i < 4; i++) oneWay += QTAB[((seqf[i] << 2) | seqf[i + 1]) & 0x0F];
  for (uint8_t i = 4; i > 0; i--) other  += QTAB[((seqf[i] << 2) | seqf[i - 1]) & 0x0F];
  CHECK(oneWay == -other,        "the two directions are exact opposites");
  CHECK(oneWay == 4 || oneWay == -4, "one full cycle is 4 counts (4x decoding)");
  CHECK(QTAB[(0 << 2) | 3] == 0, "an illegal 2-bit jump counts 0, not a guess");
  bool antisym = true;                                 // the property, over ALL 16
  for (uint8_t a = 0; a < 4; a++)
    for (uint8_t b = 0; b < 4; b++)
      if (QTAB[(a << 2) | b] != -QTAB[(b << 2) | a]) antisym = false;
  CHECK(antisym, "QTAB is antisymmetric: reversing any transition negates it");

  /* Per-frame status bits (daily-audit finding 12, fixed 2026-09-09).
   * These test the BIT ARITHMETIC, not the whole frame path: handleFrame()
   * drives the servo, motor and arm state, so calling it from SELFTEST on a
   * bench board would actuate hardware to prove a mask. Stated plainly rather
   * than dressed up as end-to-end coverage. */
  {
    uint8_t sb = ST_WATCHDOG | ST_CRC_BAD | ST_DROPPED | (2 << ST_PACK_SHIFT);
    uint8_t cleared = sb & (uint8_t)~(ST_DROPPED | ST_CRC_BAD);
    CHECK((cleared & ST_DROPPED) == 0, "handleFrame's clear drops ST_DROPPED");
    CHECK((cleared & ST_CRC_BAD) == 0, "handleFrame's clear drops ST_CRC_BAD");
    CHECK((cleared & ST_WATCHDOG) != 0, "...and leaves ST_WATCHDOG alone");
    CHECK((cleared >> ST_PACK_SHIFT) == 2, "...and leaves the pack bits alone");
    /* This is WHY the clear must exist: the reply mask preserves ST_DROPPED,
     * so without a per-frame clear one gap would stick for the whole session. */
    CHECK(((ST_DROPPED | ST_WATCHDOG) & 0x0E) == (ST_DROPPED | ST_WATCHDOG),
          "reply mask 0x0E preserves ST_DROPPED, so it must be cleared per frame");
  }

  /* RX resync (daily-audit FD row 15, 2026-10-10). Runs rxFeed() -- the SAME
   * function loop() calls -- on a LOCAL buffer, so the live parser is never
   * touched. Frame A loses byte 3; frame B's payload is 'T', '?', 'B'. On the
   * pre-fix parser all three ran as commands and B was lost. Pass 1 also puts
   * a false sync (0xA5) in A's seq byte. */
  for (uint8_t pass1 = 0; pass1 < 2; pass1++) {
    uint8_t a[CMD_LEN] = { SYNC_CMD, (uint8_t)(pass1 ? SYNC_CMD : 1), 0, 0, 0, 1, 0 };
    a[6] = crc8(a, CMD_LEN - 1);
    uint8_t b[CMD_LEN] = { SYNC_CMD, 2, 'T', '?', 'B', 1, 0 };
    b[6] = crc8(b, CMD_LEN - 1);
    uint8_t s[2 * CMD_LEN - 1], n = 0;
    for (uint8_t i = 0; i < CMD_LEN; i++) if (i != 3) s[n++] = a[i];
    for (uint8_t i = 0; i < CMD_LEN; i++) s[n++] = b[i];
    uint8_t buf[CMD_LEN], len = 0, out[CMD_LEN];
    uint8_t frames = 0, cmds = 0, seq = 0;
    for (uint8_t i = 0; i < n; i++) {
      RxEvent e = rxFeed(buf, len, s[i], out);
      if (e == RX_FRAME) { frames++; seq = out[1]; }
      if (e == RX_CMD) cmds++;
    }
    if (pass1) {
      CHECK(frames == 1 && seq == 2, "false 0xA5 in a bad frame: next frame still recovered");
      CHECK(cmds == 0, "...and no payload byte runs as a command");
    } else {
      CHECK(frames == 1 && seq == 2, "a lost byte costs ONE frame: the next one is recovered");
      CHECK(cmds == 0, "...and its 'T' '?' 'B' payload never runs as commands");
    }
  }
  {
    uint8_t buf[CMD_LEN], len = 0, out[CMD_LEN];
    CHECK(rxFeed(buf, len, '?', out) == RX_CMD && len == 0, "idle '?' is a command, not a frame");
    CHECK(rxFeed(buf, len, 'x', out) == RX_NONE && len == 0, "idle junk is ignored");
    CHECK(cmdAllowed('?', true), "'?' allowed while armed (host_test probes with it)");
    CHECK(!cmdAllowed('T', true) && !cmdAllowed('B', true), "'T' and 'B' refused while armed");
    CHECK(cmdAllowed('T', false) && cmdAllowed('B', false), "'T' and 'B' allowed when disarmed");
  }

  {
    // Backlash compensator (records HM-HQ). Local state: the live steerComp
    // is never touched by SELFTEST.
    Backlash b = {0, 0};
    CHECK(backlashCommand(b, 1525) == 1525 + SERVO_BACKLASH_US,
          "first command approaches from below: target + half-gap");
    CHECK(backlashCommand(b, 1525) == 1525 + SERVO_BACKLASH_US,
          "an unchanged target keeps its overshoot (watchdog path), no return");
    CHECK(backlashCommand(b, 2000) == 2000 + SERVO_BACKLASH_US, "moving up overshoots above");
    CHECK(backlashCommand(b, 1500) == 1500 - SERVO_BACKLASH_US, "moving down overshoots below");
    CHECK(backlashCommand(b, 1490) == 1490 - SERVO_BACKLASH_US, "a further step down keeps the low side");
    CHECK(backlashCommand(b, 1495) == 1490 - SERVO_BACKLASH_US, "a reversal inside the deadband holds the pulse");
    CHECK(backlashCommand(b, 1490 + SERVO_REVERSE_DEADBAND_US + 1) ==
          1490 + SERVO_REVERSE_DEADBAND_US + 1 + SERVO_BACKLASH_US,
          "a reversal past the deadband switches to the high side");
    Backlash dd = {0, 0};
    uint16_t p0 = backlashCommand(dd, 1500);
    bool ditherHeld = true;
    for (uint8_t i = 0; i < 4; i++)
      if (backlashCommand(dd, (i & 1) ? 1500 : 1495) != p0) ditherHeld = false;
    CHECK(ditherHeld, "one-step dither does not move the servo (audit C1-2)");
    Backlash sd = {1500, 1};
    CHECK(backlashCommand(sd, 1495) == 1575, "slow drift: first small reversal holds");
    CHECK(backlashCommand(sd, 1490) == 1575, "slow drift: delta 10 is not past the deadband, holds");
    CHECK(backlashCommand(sd, 1489) == 1489 - SERVO_BACKLASH_US,
          "cumulative reversal past the deadband switches");
    Backlash e = {600, 1};
    CHECK(backlashCommand(e, 560) == SERVO_US_MIN_SAFE, "overshoot never goes past the left safe limit");
    Backlash g = {2500, -1};
    CHECK(backlashCommand(g, 2550) == SERVO_US_MAX_SAFE, "overshoot never goes past the right safe limit");
    // Steering gate (audit HJ): a DISARMED, pack-inhibited or watchdog-tripped
    // state never moves the servo; only OUT_DRIVE does.
    CHECK(!steerAllowed(outputModeFor(false, false, false, true, 0)),
          "a disarmed frame does not steer (brake window)");
    CHECK(!steerAllowed(outputModeFor(false, false, false, false, 0)),
          "never-armed boot state does not steer");
    CHECK(!steerAllowed(outputModeFor(true, true, false, true, 0)),
          "armed but pack-inhibited does not steer");
    CHECK(!steerAllowed(outputModeFor(true, false, true, true, 0)),
          "armed but watchdog-tripped does not steer");
    CHECK(steerAllowed(outputModeFor(true, false, false, true, 0)),
          "armed, pack OK, link alive: steers");
    CHECK(steerToUs(-100) - SERVO_BACKLASH_US > SERVO_US_MIN_SAFE &&
          steerToUs(100) + SERVO_BACKLASH_US < SERVO_US_MAX_SAFE,
          "full steer plus overshoot stays inside both safe limits");
  }

  Serial.print(F("SELFTEST ")); Serial.print(fail ? F("FAIL ") : F("PASS "));
  Serial.print(pass); Serial.print('/'); Serial.println(pass + fail);
  #undef CHECK
}

// ---- frame handling --------------------------------------------------------
void handleFrame(const uint8_t *f, uint32_t now) {
  // PER-FRAME status bits are RECOMPUTED here, never accumulated. Both are
  // cleared BEFORE the sequence test below, which is the whole point: clearing
  // ST_DROPPED after that test would wipe the bit the test had just set.
  //
  // Fixed 2026-09-09 (daily-audit finding 12). ST_DROPPED was OR'd in on a
  // sequence gap and cleared NOWHERE, while :550's `statusBits & 0x0E` preserves
  // it across every reply -- so ONE dropped frame made every later reply for the
  // rest of the session report "dropped", and the host could not tell a live
  // link problem from a stale bit. ST_CRC_BAD and ST_WATCHDOG were both already
  // cleared; ST_DROPPED was the odd one out.
  statusBits &= (uint8_t)~(ST_DROPPED | ST_CRC_BAD);

  uint8_t seq = f[1];
  if ((uint8_t)(seq - lastSeq) != 1 && lastFrameMs != 0) statusBits |= ST_DROPPED;
  lastSeq = seq;
  lastFrameMs = now;

  int8_t  steer    = (int8_t)f[2];
  int8_t  throttle = (int8_t)f[3];
  uint8_t lights   = f[4];
  armed = f[5] & 0x01;
  if (armed && !pack.inhibits()) everArmed = true;   // first rise of STBY
  lastSteer = steer;

  bool wd = false;                                  // a fresh frame is not late
  OutMode mode = outputModeFor(armed, pack.inhibits(), wd, everArmed,
                               unsafeSince ? now - unsafeSince : 0);
  if (mode == OUT_DRIVE) unsafeSince = 0;
  else if (!unsafeSince) unsafeSince = now;

  applyOutputs(mode, steer, mode == OUT_DRIVE ? throttle : 0);
  applyLights(lights, false, now);

  statusBits = (uint8_t)((statusBits & 0x0E) | (armed ? ST_ARMED : 0) |
                         ((uint8_t)pack.state << ST_PACK_SHIFT));
  sendReply(seq, readTicks(), statusBits, loopDt);
}

void setup() {
  // Order matters: STBY must be driven LOW before anything else can enable the
  // bridge. Until this line the pin is high-Z and the carrier's internal
  // pull-down holds the driver off — that is the boot fail-safe, not luck.
  pinMode(PIN_STBY, OUTPUT);  digitalWrite(PIN_STBY, LOW);
  pinMode(PIN_DIR_A, OUTPUT); digitalWrite(PIN_DIR_A, LOW);
  pinMode(PIN_DIR_B, OUTPUT); digitalWrite(PIN_DIR_B, LOW);
  pinMode(PIN_MOTOR, OUTPUT); analogWrite(PIN_MOTOR, 0);

  pinMode(PIN_STATUS, OUTPUT);
  // begin() sets DIN pinMode; show() with the zeroed default buffer blanks
  // both strips on boot -- dark until the first valid frame, the same
  // fail-safe shape as STBY staying low until the first ARMED frame.
  stripL.begin(); stripL.show();
  stripR.begin(); stripR.show();

  pinMode(PIN_ENC_A, INPUT);  pinMode(PIN_ENC_B, INPUT);
  // No internal pull-ups: the #5159 encoder already pulls its outputs to Vcc
  // through internal 10k. Enabling ours too would fight nothing, but it would
  // also hide a disconnected encoder, which would then read as "not moving".
  encPrev = (uint8_t)((digitalRead(PIN_ENC_A) << 1) | digitalRead(PIN_ENC_B));
  attachInterrupt(digitalPinToInterrupt(PIN_ENC_A), encISR, CHANGE);
  attachInterrupt(digitalPinToInterrupt(PIN_ENC_B), encISR, CHANGE);

  // Timer2 prescaler 1 -> 31.25 kHz, above the audible band. This is the whole
  // reason motor PWM is on D11: Timer0 also drives millis() and cannot move.
  // Safe for D3, which is a digital interrupt input here, not a PWM output.
  TCCR2B = (uint8_t)((TCCR2B & 0xF8) | 0x01);

  steerServo.attach(PIN_SERVO);
  // Through the compensator: the first approach is from below, so the rack
  // starts on a known side of the gear gap.
  steerServo.writeMicroseconds(backlashCommand(steerComp, SERVO_US_CENTRE));

  analogReference(INTERNAL);        // 1.1 V band gap — packguard.h
  pinMode(PG_PIN, INPUT);

  Serial.begin(115200);
  delay(200);
  Serial.println(F("== UNO CONTROL == protocol v0.2, SERVO WIRED; MOTOR, ENCODER, LEDS, PACK UNWIRED"));
  selftest();
}

void loop() {
  uint32_t now = millis();
  static uint32_t lastLoop = 0;
  uint32_t dtUs = (now - lastLoop) * 1000UL;
  loopDt = (uint8_t)(dtUs / 100 > 255 ? 255 : dtUs / 100);
  lastLoop = now;

  pack.poll(now);

  while (Serial.available()) {
    uint8_t c = (uint8_t)Serial.read();
    uint8_t f[CMD_LEN];
    RxEvent ev = rxFeed(rxBuf, rxLen, c, f);
    if (ev == RX_FRAME) handleFrame(f, now);   // ONE clock sample per iteration -- see header
    else if (ev == RX_BAD) {
      // A bad CRC is a DROPPED frame, never a guessed one: no actuator action,
      // and the watchdog keeps running so a stream of corrupt frames still
      // trips it rather than looking like a healthy link.
      statusBits |= ST_CRC_BAD;
      sendReply(f[1], readTicks(), statusBits, loopDt);
    } else if (ev == RX_CMD && cmdAllowed(c, armed)) {
      if (c == '?') printStatus();
      else if (c == 'T') selftest();
      else {
        benchQuiet = !benchQuiet;
        Serial.print(F("bench-quiet ")); Serial.print(benchQuiet ? F("ON") : F("OFF"));
        Serial.println(F(" - LED only; throttle stays inhibited, cleared on reset"));
      }
    }
  }

  bool wd = (lastFrameMs == 0) || (now - lastFrameMs > WATCHDOG_MS);
  if (wd) {
    statusBits |= ST_WATCHDOG;
    armed = false;
    OutMode mode = outputModeFor(false, pack.inhibits(), true, everArmed,
                                 unsafeSince ? now - unsafeSince : 0);
    if (!unsafeSince) unsafeSince = now;
    applyOutputs(mode, lastSteer, 0);        // HOLD steering, do not centre
    applyLights(0x02, everArmed, now);       // hazards, once it has ever driven
  } else {
    statusBits &= (uint8_t)~ST_WATCHDOG;
  }

  // Quiet ONLY the no-sensor case, and only the LED: automatically when no
  // real pack has ever been seen, or on the manual override.
  bool quiet = pack.state == PACK_FAULT && (benchQuiet || !pack.everPlausible);
  // The watchdog blink follows the SAME rule applyLights() already uses for the
  // hazards: a watchdog "trip" before anything has ever armed is not a fault,
  // it is simply no Pi connected yet. Blinking it on a bare bench board is
  // crying wolf, and a light that always cries wolf is not read when it means
  // something. Once everArmed is set -- the car has driven -- silence stops.
  bool wd_alarm = wd && everArmed;
  uint16_t period = (pack.inhibits() && !quiet) ? 150
                    : (wd_alarm ? 400 : (armed ? 1000 : 0));
  digitalWrite(PIN_STATUS, period ? (uint8_t)((now / period) & 1) : LOW);
}
