Evan-Daruwalla/vision-autonomous-car/(commit log)

2026-07-24 Bootstrap: doc system, six research briefs, staged PRD, final BOM
    Project conception through completed research phase (2026-07-23).
    Docs: HANDOFF.md (live snapshot), append-only project record with
    Appendices A-H, PRD_ROADMAP.md (M1 chassis -> M4 offline world model,
    M5 optional sim-RL), docs/BOM.md, codebase-memory bins.
    Research: four briefs in docs/research/ from six Opus workers covering
    compute, sensors, electronics, AI pipeline, drive motor, and power. Every
    load-bearing claim spot-checked against primary sources; the drivetrain
    gearing/torque and power runtime/peak-current chains re-derived
    independently.
    Stack settled: Pi 5 4GB + Camera Module 3 Wide + Pololu #1093 N20 30:1 HP
    thr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
2026-07-24 M1.3: generate and validate the Lego-fit tolerance coupon
    Replaces the PRD's third-party Printables download with a parametric
    generator. The download's contents could never be verified (the page 403s to
    automated fetch) and a fixed STL cannot be re-swept if it brackets nothing.
    scripts/gen_tolerance_coupon.py -> cad/tolerance_coupon_v1.stl
    104 x 56 x 8 mm on the real 8 mm Lego beam pitch, 20 holes, 18048 triangles:
    - pitch row, 5 holes at exactly 8.00 mm centres (catches printer scaling)
    - pin-fit sweep 4.80-5.30 mm, marked with 1 marker hole
    - axle-bore sweep 5.20-5.70 mm, marked with 2 marker holes
    Plate is 8 mm thick to match a real beam, since hole shrinkage is
    depth-dependent. C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
    [tolerance_coupon_v1.stl]
2026-08-06 SIM-POC P1: ML environment verified (CUDA + simulator camera frame)
    P1 DONE-CHECK: PASS. Real output from ml/verify_env.py:
    torch 2.13.0+cu126, cuda.is_available True
    NVIDIA GeForce RTX 3060 Ti, 8.00 GiB
    sim launched, reset + 20 steps, obs (120,160,3) uint8, reward 0.739
    frame saved, min 0 max 255 mean 119.2 -- a real track, not a black frame
    Environment (ml/requirements.txt has exact pins + rebuild instructions):
    Python 3.12.10 venv. 3.11 is not installed on this machine and was the
    pre-declared fallback; verified before switching that torch classifies
    3.10-3.14 and gym-donkeycar needs only gymnasium/numpy/pillow at
    python_requires>=3.7, so installing 3.11 would have been u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
2026-08-06 SIM-POC P2: sim data collection with a layout-based split
    Three modules: episode_writer.py (dreamerv3-torch npz format),
    collect_sim_data.py (scripted PID expert), verify_corpus.py (done-check).
    SPLIT BY TRACK, NEVER BY FRAME. Frame t and t+1 in a driving log are
    near-duplicates, so a random frame split leaks and overstates accuracy. Whole
    tracks are held out, chosen before any data was collected so the split cannot
    be tuned to flatter a result. The 11 Donkey tracks are the simulator's
    analogue of the physical tile layouts (record Appendix L).
    The expert driver was tuned by measurement, not guesswork:
    - open-loop probe: steer +0.35 drove cte +0.005 -> +4.224, proving positive
    steer i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
2026-08-06 docs: HANDOFF gains the track spec and SIM-POC P2 status
2026-08-06 docs: track design spec + P2 tuning record; holdout episode count
    Track (record Appendix L, PRD TRACK block T1-T6), from Evan's description of
    the real driving environment:
    - Print MARKINGS, not the road surface. A minimum two-lane loop is ~6.4 kg
    of filament and ~150-250 print-hours as printed tiles, vs ~0.15 kg and
    ~6 hours as printed strips on dark matte board - 97% less for identical
    camera input, because at 120x160 the camera sees markings, not road.
    The printer is also committed to chassis parts in weeks 1-3.
    - Figure-8, never a plain oval: a one-handed loop teaches the BC model
    "always steer left", which looks perfect on the training track and fails
    everyw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
2026-08-06 docs: deadline moves to RD; grid/routing scope logged; --only resume flag
    Deadline (record Appendix N): the hard deadline is now Regular Decision
    (~Jan 1-15 2027); Nov 1 2026 becomes a soft milestone. The Appendix K
    schedule already assumed Nov 1 needed only SIM-POC + M3, so nothing is cut
    and M4 moves from stretch to comfortably in scope.
    Scope expansion logged as UNDER EVALUATION, not adopted - destinations,
    parking, and routing. Two blockers recorded before it can enter the PRD:
    1. End-to-end BC likely cannot route. At an intersection two identical
    camera images require different actions depending on the destination,
    and pi(action|image) has no term for the destination. Same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
2026-08-06 fix: restore the image-axis alignment gate the docs claimed existed
    A cold audit (no session history, docs handed to it as claims under test)
    found that verify_corpus.py's alignment gate did not gate what its own
    docstring claimed. check_pid_identity relates action[i] to log_cte[i-1] and
    never opens an image, so a corpus with a rolled IMAGE array passed cleanly -
    exactly the bug Appendix M says the check exists to catch.
    Verified independently before accepting the finding: images rolled +1 -> PASS,
    rolled +3 -> PASS, actions rolled +1 -> FAIL. Confirmed.
    Cause is mine. Appendix M records replacing the pixel-motion check with the
    PID identity after the pixel check peaked at lag -1 on good d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
2026-08-06 perf: stream the corpus verifier; stop misdiagnosing weak signal as misalignment
    Streaming (audit F9/E7). verify_corpus.py retained every episode's image
    array so two later passes could iterate over them. The audit predicted an OOM
    at the PRD's own ~100k-frame target; at the current 76,299 frames the
    retained-images estimate was 4.09 GB.
    Both gates are now per-episode functions writing into small accumulators,
    with separate finalizers, so each episode is checked and immediately
    discarded. Measured peak Python RSS after the change: 0.10 GB - about 40x
    lower, and O(1) in corpus size instead of O(n). All four adversarial tests
    still behave correctly (baseline PASS; images +1 FAIL; images +3 FA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
2026-08-06 data: quarantine the two sim tracks the expert cannot drive
    Evan's decision (option a from record Appendix P.3).
    mountain-track had 13 of 13 episodes rejected by the quality filter on the
    top-up run; roboracingleague averaged 303 frames against a 1200 request, with
    the worst mean|cte| of any saved track. Between them they supplied 7% of the
    corpus and 100% of its verification failures - all 12 unverifiable episodes
    came from these two.
    Their 15 episodes / 4,637 frames were MOVED to ml/data/sim_quarantine/, not
    deleted, so this is reversible if the expert is ever re-tuned per-track. Both
    tracks are struck from TRAIN_TRACKS with the reason, the numbers, and the
    quarantine path in the comment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
2026-08-06 SIM-POC P2 done: 102,888-frame corpus, 88/88 verified on both axes
    Final top-up landed with 26 of 26 episodes saved, zero rejected.
    train : 78 episodes, 91678 frames, [generated-roads, generated-track]
    holdout : 10 episodes, 11210 frames, [waveshare]
    split is disjoint
    total frames: 102888
    exact PID identity : verified on 88/88 episodes
    image-axis gate : 88/88 in band (-2,-1), mode -1, |r| 0.74-0.96
    P2 CORPUS CHECK: PASS
    The PRD target was ~100k. At quarantine time the corpus sat at 71,662 (72%)
    and the tempting move was to declare that sufficient; collecting the rest
    cost ~30 minutes of unattended wall-clock and removed the argument entirely.
    Target met, not rede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
2026-08-06 SIM-POC P3 done: Ha & Schmidhuber world model, rollouts beat baseline 30/30
    The V+M+C world model (arXiv:1803.10122) trains on the P2 corpus and produces
    30-step imagination rollouts that are recognisably track-like and measurably
    better than a do-nothing baseline. Total training on the 3060 Ti: VAE 198s +
    MDN-RNN 140s, well under the 8GB ceiling.
    New: preprocess.py, splits.py, models.py, train_vae.py, train_mdnrnn.py,
    rollout_eval.py.
    Architecture reproduces the paper exactly - the ConvVAE has 4,348,547
    parameters, matching the published figure to the digit, and models.py asserts
    it. That proves every kernel size and channel width is wired as specified,
    which reading the code cannot.
    THE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
2026-08-06 SIM-POC P4 CLOSED: the model trains, and the memory boundary holds
    The 2000-step DreamerV3-S offline run finished (exit 0), closing the one item
    Appendix T left open. P4's done-check now passes on BOTH halves.
    image reconstruction loss 588.31 -> 61.39 (9.6x, monotonic after epoch 1)
    peak VRAM 2.550 - 2.552 GB across all 20 epochs
    2000 gradient steps, no OOM, 7.0 GB allocator cap
    The peak-VRAM spread of 0.002 GB is the result that matters more than the loss
    curve. It hardens the Appendix T fitting table: a 20-step probe could have been
    a warm-up artifact that crept upward under real training, since fragmentation
    and cache growth are exactly what make short memory pr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
2026-08-06 fix: cold audit - 15 findings + 10 edge cases, four gates that could not fail
    A cold auditor (no session history, no inherited belief) swept nine methods and
    four edge-case generators. It VALIDATED the documented claims: every headline
    number in README.md reproduces from committed artifacts, both corpus alignment
    gates genuinely fire under deliberate corruption, the coupon STL regenerates
    byte-identically, and no secret has ever been committed.
    The risk was entirely in scripts nothing asserts. Four P1s, all silent-wrong-
    answer class, all now fixed and each verified by being made to FAIL:
    1. sweep_dreamer_p4.py inferred success from a file EXISTING, never reading the
    child's exit code.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
2026-08-07 SIM-POC P5 CLOSED: no learned policy finishes; the latent is the bottleneck
    P5 built BOTH options the PRD offered -- latent behavioural cloning
    (train_controller.py, linear and MLP) and CEM planning through the learned
    dynamics (plan_cem.py) -- and evaluated each over 3 seeds x 3 episodes against
    the PID expert that produced the training corpus. SIM-POC (P1-P5) is complete.
    THE RESULT, stated plainly:
    driver steps (mean+-sd) mean|cte| rev/100 completed
    expert (PID) 600.0 +- 0.0 0.367 9.87 9/9
    BC, linear C (paper) 104.1 +- 66.5 1.043 8.50 0/9
    BC, MLP C 69.3 +- 1.2 0.435 9.28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
2026-08-09 diagnose the P5 wall (perception goes OOD) + both encoders erase small objects
    Closes the two items Appendix V.4 left undiagnosed. New: ml/trace_failure.py,
    ml/compare_encoders.py, plus checkpoint saving in run_dreamer_p4.py (P4 threw
    its trained model away, so the encoder question needed a retrain to ask).
    1. THE 69-110 STEP WALL IS PERCEPTION GOING OUT OF DISTRIBUTION.
    trace_failure.py separates the three stages that could be at fault by logging
    perception, dynamics and true cte per step against the actions actually taken.
    |actual cte| perception err (MLP) perception err (PID expert)
    0.0 - 0.3 0.202 0.198
    0.6 - 1.0 0.307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
2026-08-09 recovery data cuts off-centre perception error 57% with a FROZEN encoder
    Two experiments, both prompted by Evan. Record entry: Appendix X.
    1. RECOVERY DATA (the direct test of the Appendix W.1 diagnosis)
    W.1 found the wall is perception going out of distribution, because
    collect_sim_data.py rejects mean|cte| > 1.2 and the expert averaged 0.36, so
    no off-centre frames exist. collect_recovery.py supplies them by DART-style
    noise injection: drive the expert, inject a steering-noise burst every 60
    steps for 8 steps, then hand back control and let the PID drive home.
    DART over DAgger deliberately. DAgger needs an expert relabelling states the
    learner visits -- on a physical car that means a hu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
2026-08-11 stop-sign decision enacted and validated; recovery data ruled out as the fix
    Three things Evan asked for, plus two measurement problems found while doing
    them. Record Appendices Y, Z, AA.
    STOP-SIGN (PRD 6(b) resolved: aux detection head + oversized sign)
    - probe_cone.py: the frozen ConvVAE latent does NOT contain small objects. A
    cone probe scored AUC 0.997 and collapsed to 1% of the pos/neg gap when the
    cone was painted out -- it was reading TRACK POSITION. The ablation control
    is the finding; the shuffled-label control (0.427) would not have caught it.
    - Consequence, now a hard PRD requirement: the printed sign must be
    RELOCATABLE. On a fixed track a policy passes the showcase by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
2026-08-12 correct AD; the harness fix is a paired design, not more launches
    Appendix AE. /landing-check run cold on e5dceed re-derived every headline
    number exactly and found six corrections plus a methodological critique that
    is more useful than anything AD proposed.
    CORRECTIONS TO AD
    1. "Post-reset position identical to four decimals across 16 episodes" is
    OVERSTATED. z, speed and reset_seconds hold; x does not - episode 0 of each
    launch reads 6.2114 vs 6.2116 for the other 14. Difference is 2.8e-4 world
    units, so the conclusion stands, but the claim as written is false.
    2. The episode pool was STALE: 35 quoted, 47 on disk (the lc_* launches were
    added by that same commit). Re-derived: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
2026-08-12 propagate AE's corrections to the live docs (AE fixed the record and forgot them)
    Appendix AF. Third /landing-check confirmed every number in AE re-derives
    exactly, then found that two of AE's six corrections went into the append-only
    record and never reached HANDOFF.md or the ml-training bin - the same failure
    AE was correcting AD for, one layer up.
    THE PATTERN, now three deep and clearly systematic
    AB reported a result the instrument could not support -> caught by replication
    AC retracted it, asserted a replacement with the same defect -> caught by AD
    AD quoted CV 0.553 off n=7 to three figures -> caught by landing-check 2
    AE corrected AD in the RECORD, left the live docs sta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
2026-08-12 BOM re-pricing verified against live vendor pages; the $200 ceiling is genuinely breached
    The re-pricing in docs/BOM.md was authored outside the session that found
    it, so it was held out of four commits rather than shipped unverified. Evan
    asked for it to be checked. All six prices confirmed exactly against live
    vendor pages 2026-08-12 ~07:40 CDT:
    Pi 5 4GB $110.00 pishop.us (in stock) / $130.00 adafruit.com
    Camera Mod 3W $38.50 pishop.us (in stock)
    Pololu #1093 $23.95 (unchanged)
    Pololu #713 $4.95 (unchanged)
    Pi 5 2GB $65.00 pishop.us (in stock) <- the budget lever
    The edit is accurate, including its own self-flagged UTC date error on the
    2026-08-06 stamp. Tota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
2026-08-13 sim-transfer spec: measure the operating point the physical car must match
    Evan chose: buy the encoder motor (#5159, +$6), take MORE FLOOR SPACE over the
    ~1:20 track re-spec, and research Pi alternatives before a ~September purchase.
    This records what the real car has to match for the sim work to transfer.
    MEASURED, not estimated (ml/measure_operating_point.py, new, 400 steps):
    control rate 20.00 Hz
    cruise speed 1.401 m/s steady mean, 1.586 max -> 7.0 cm per control step
    frame 120x160x3 native, squashed to 64x64
    |cte| mean 0.317 m, p95 0.789, max 1.122
    |steer| mean 0.598, p95 1.000 - the expert SATURATES its steering
    The speed was never recorded anyw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
2026-08-13 Evan build decisions + operating point measured + the camera nobody configured
    Appendix AG.
    EVAN DECIDED (2026-08-12): buy the encoder motor #5159 (+$6); take MORE FLOOR
    SPACE over the ~1:20 re-spec; research Pi alternatives, purchase ~September.
    OPERATING POINT MEASURED for the first time (ml/measure_operating_point.py):
    20.00 Hz, 1.401 m/s mean (7.0 cm per control step), 120x160 frames, expert
    holds |cte| 0.317 m mean and SATURATES steering at the p95. None of this had
    ever been written down - THROTTLE 0.20 is a normalised command and the corpus
    logs cte but not velocity. docs/SIM_TRANSFER_SPEC.md turns it into the contract
    the physical car must meet; recommends ~300 mm lanes and 0.3-0.5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
2026-08-13 research: the camera was never the constraint - the PWM pin is, and it breaks the Pi 5
    Appendix AH. /research-brief on alternatives to the Pi 5 as a whole. Four
    agents, one per pre-registered hypothesis, each hunting its own falsifier.
    Verdict keeps the incumbent, but BOTH reasons the previous brief gave were
    wrong, and a live defect in the current plan turned up.
    THE PRIOR ARGUMENT DOES NOT HOLD. That brief rejected non-Pi boards on the
    picamera2/IMX708 dependency. Verified false in DonkeyCar main: picamera2 and
    RPi.GPIO are only in the pi extra, PiCamera imports picamera2 INSIDE __init__
    (never runs with CAMERA_TYPE=CVCAM), and the nano extra already ships a non-Pi
    config with Jetson.GPIO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
2026-08-13 correct the BeagleY-AI comparison: it was not like-for-like
    Evan pointed out that the brief compared BeagleY-AI 4GB ($70) against the Pi 5
    *2GB* ($65) rather than the Pi 5 4GB ($110). He is right and the framing
    flattered the incumbent.
    At equal RAM, BeagleY-AI undercuts the Pi 5 4GB by $40.
    The consequence is bigger than the sentence: THE PI 5 4GB IS NOW DOMINATED IN
    BOTH DIRECTIONS. If 2GB suffices, the Pi 5 2GB is $5 cheaper. If 4GB is
    wanted, BeagleY-AI is $40 cheaper. The 4GB Pi retains no price argument.
    BeagleY-AI price re-verified 2026-08-12: $70.00, in stock, 4GB (Seeed).
    Power sourced for the first time (it was a NOT-COLLECTED gap): ~4.7-4.8 W
    idle, requires 5V @ 3A over USB-C P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
2026-08-13 the generated track regenerates every launch - that is the harness mystery, solved
    Appendix AI. The camera-FOV identification (top no-hardware item from AG.4)
    answered its own question AND solved the closed-loop variance that AD, AE and
    AF spent three entries failing to explain - by failing first, loudly.
    THE TRACK IS REGENERATED ON EVERY LAUNCH. The FOV test needs a stable scene to
    compare frames; on donkey-generated-track-v0 the default-vs-default noise floor
    came back 23.9, then 48.4 with a fully controlled pose. Three identical-config
    launches at an identical spawn: pairwise MAE 29-36, 27-35% of pixels differing
    by >30, mean brightness stable at spread 6.6. Structure changes, not lighti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
2026-08-13 paired closed-loop re-run: valid at last, and no intervention helps
    Appendix AJ. AI.5's top item - re-run the closed-loop comparisons now that the
    confound (track regeneration per launch) is known. New: ml/eval_paired.py.
    A FIXED TRACK IS NOT THE FIX, and that is itself a finding. Confirmed fixed by
    launch-to-launch frame MAE: donkey-avc-sparkfun-v0 (0.367),
    donkey-mountain-track-v0 (0.481). Also confirmed REGENERATED:
    donkey-generated-roads-v0 (3.504). But on both fixed tracks the learned
    controllers collapse to 13-67 steps at mean|cte| 2.2-3.8, against the 0.317
    they trained at - every fixed track is far outside the corpus's visual
    distribution, so all arms bunch at the floor. The generat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
2026-08-16 Pin the sim's camera geometry at every launch site, not just the diagnostic
    Appendix AK.
    AI (2026-08-13) identified the sim's default FOV as 90 degrees by
    comparison, but that identification was never asserted in code - cam_config
    appeared only in the diagnostic script that discovered it. The 9 modules
    that actually build the corpus and run every eval each hand-built a conf
    dict with no camera geometry, so a gym-donkeycar/DonkeySimWin version bump
    could silently move every number in SIM_TRANSFER_SPEC.md.
    Added ml/sim_conf.py as the single chokepoint; migrated all 9 call sites.
    diag_camera_fov.py deliberately untouched - it discovers this constant, so
    it can't depend on it. Also wired a sec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
2026-08-21 Restore the missing TOC line for Appendix AK
    The record had 37 appendix headings and 36 TOC lines: `# Appendix AK` (line
    4412, dated 2026-08-16) was never given a table-of-contents entry. Found by a
    landing-check sweep, not by the record failing - it had been sitting imbalanced
    since 08-16.
    The anchor was not hand-written. It was computed with the same slugify used by
    append-record-entry.js, which mirrors the HTML renderer's algorithm (this repo
    has no HTML twin to read the id from, so the shared algorithm is the authority):
    lowercase -> strip all but letters/digits/underscore/space/hyphen -> spaces to hyphens
    Inserted as a byte-precise splice rather than a split/join, because this file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
2026-08-21 Pin shell scripts and git hooks to LF
    core.autocrlf is true on this machine and this repo had no .gitattributes, so a
    fresh clone rewrote every tracked shell script to CRLF - shebang included. It
    arrives as `#!/bin/sh\r`, a POSIX kernel execs the literal interpreter
    "/bin/sh\r", and the result is "bad interpreter". For a pre-commit hook that
    means the clone silently has NO commit gate, and no error names the cause.
    Measured on a real clone of another repo on 2026-08-20: the CRLF form still
    runs correctly under Git for Windows (hook exit 0, and it DENIED a staged AKIA
    literal at exit 1), so this protects Linux/macOS clones and CI rather than this
    machine. Stated that way deliberately - "fixe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
2026-09-01 doc sync: rebuild HANDOFF as a snapshot, record AM, wire 3dstreet-mcp
    Appendix AM. Evan is designing the physical street layout in 3dstreet.app and
    supplied the 3dstreet-mcp config; wiring it turned into a full doc sync,
    because surveying state for a handoff found the tree well out of date.
    3DSTREET WIRED, WITH A FIT CAVEAT THAT MATTERS MORE THAN THE WIRING
    .mcp.json written at project scope (npx 11.9.0 present; the `claude` CLI is
    NOT on PATH here, so `claude mcp add` has to be run by Evan). The server is a
    bridge to a LIVE browser tab over WebSocket - alpha, no auth token - not a
    headless generator. And it is a street CROSS-SECTION tool: linear segments
    plus 90/T/dead-end intersections, n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
2026-09-01 floor space is 3x3 m; correct the lane-width rule Evan caught as over-provisioned
    Appendix AN.
    FLOOR SPACE: 3.0 x 3.0 m, confirmed by Evan. 9 m2 against the 4.48 m2 the old
    1.6 x 2.8 plan assumed, so the 2026-08-12 "more floor space" decision more than
    doubled the area. Every candidate car/lane combination fits the FULL estimated
    500-670 mm corner range: at R=500 the figure-8 is 1.30 x 2.30 m, at R=670 it is
    1.64 x 2.98 m. M1.4b's floor-space blocker is closed.
    CAR WIDTH: measure it, do not choose it. Evan asked about ~100 mm. Space does
    not require it, and neither does turn radius - R_min ~ wheelbase / tan(max
    steer) is 157-322 mm across plausible wheelbases, far below the corners the
    tra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
2026-09-01 AL audit fixes, verified: load_cached_mu resolves three cache states
    The AL fixes sat uncommitted since 2026-08-25 because nothing had been run
    end-to-end. Ran them. The central fix was wrong: load_cached_mu collapsed
    "cache has no sidecar key" into "stale", which hard-stopped train_cte_probe.py
    on an unchanged corpus and made train_controller.py and diag_copycat.py
    re-encode 91,678 frames the cache already answered.
    ml/data/proc/ has no .key file at all -- the fingerprint scheme postdates the
    2026-08-06 cache and only train_mdnrnn.py can stamp one. Measured the cache
    against vae_best.pt on a 4,096-frame sample: residual 5.2e-4 relative, versus
    5.1e-2 for a +1% weight perturbation. 100x mar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
2026-09-01 verify_corpus.py: absolute default path, and P2 re-verified PASS
    Correcting a false claim I put in the record. AP.5 said ml/data/sim "is not on
    disk" and that P2's DONE status rested on the 2026-08-06 record alone. Both
    wrong: the corpus is there, 88 episodes / 3.9 GB, matching the recorded figure.
    ml/data/ is gitignored as large-and-regenerable, which is not evidence of
    absence.
    The real defect: verify_corpus.py was the only script in ml/ whose default path
    was cwd-relative ("ml/data/sim"). Run from ml/, it resolved to ml/ml/data/sim
    and printed its own honest "corpus not found". I read a path error as a missing
    corpus. Added REPO and made the default absolute, matching collect_sim_data.py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
2026-09-01 Sim camera pose: fov proved VERTICAL, pitch 16.3 deg down, height not identified
    HANDOFF's next-action 2 asked for the camera height/pitch/offset "by the same
    comparison method that pinned fov=90". That method does not transfer.
    send_cam_config's contract is "set any field to Zero to get the default camera
    setting" -- FOV was sweepable because its default (90) is non-zero, but for
    offset_x/y/z and rot_x/y/z 0.0 MEANS "keep the default", so no sweep can
    reproduce a default it cannot express. The fov=90 run sent all six extrinsic
    keys as 0.0, so it held them at default and learned nothing about them.
    Measured geometrically instead, mostly off frames already on disk.
    fov is the VERTICAL field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
2026-09-01 HANDOFF sync: session end 2026-09-01
    Next-action 2 (the uncommitted AL fixes) closed. Camera section rewritten with
    the AR pose findings: fov proved VERTICAL, pitch 16.3 deg down (horizon row
    41.97 of 120), height still open with the reason stated. Notes P2 re-verified
    PASS and points at the new diag_camera_pose.py. Appendix count A-AR.
2026-09-02 Track layout v1, plus a record-race repair and the AU audit's fixes
    TRACK LAYOUT (Appendix AT). Asked for a twisty layout via the 3dstreet MCP with
    5 destinations and a bridge; three of those four do not survive the constraints.
    The MCP has no paired tab so it exposes zero tools, and Appendix AM had already
    recorded that 3DStreet cannot draw this track - it is a street cross-section
    tool with no curved streets.
    "Twisty" is geometrically impossible at 3x3 m: at the frozen minimum corner
    radius only 1.75-2.33 hairpins fit across the WHOLE usable floor, and 1.04-1.40
    S-bends. At R=670 mm, the top of the frozen band, even a plain figure-8 does
    not fit - a live risk on the B3 turning test.
    The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
2026-09-02 Track v2: 3x3 city grid, figure-8 route, hybrid print plan
    SIM: a custom track cannot be simulated. gym-donkeycar's protocol has ten
    message types and none defines a road; load_scene picks from 11 prebuilt Unity
    scenes. Costs less than it sounds - PRD M3 trains on 10-20 real laps, not the
    sim corpus. What must still match the sim is the control loop and camera
    (20 Hz, 1.401 m/s, 64x64, fov 90 vertical, horizon row 42), not the scenery.
    GEOMETRY: a 3x3 street grid fits at R=500mm and nowhere else in the frozen
    500-670mm band - span 2780mm of 2800mm usable, 20mm spare. There is no
    smaller-city fallback either: a 2x2 grid has the space but cannot carry a
    figure-8, which needs a centre street t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
2026-09-02 Correct the street-pitch error, shrink v2, and spec the lighting
    PITCH CORRECTION. AX.2 said a 3x3 city grid fits at exactly one radius. Wrong,
    and it was my arithmetic. track_layout_v2.py used pitch = 2R + lane; deriving it
    instead, the turn arc consumes R before the corner and R after, so consecutive
    corners need only pitch >= 2R. The lane term is not part of it - parallel
    streets need pitch >= lane merely so their surfaces do not overlap, and 2R
    (>=1000mm) dwarfs lane (260mm). That inflated every span by 520mm. Corrected,
    the grid fits at R=500 (2660mm, 140mm spare), 550 and 600 (2800mm); only 670
    fails. B3 kills the city only at the top of the band, not across three quarters
    of it.
    SMAL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
2026-09-02 BOM: add the PCA9685 and lighting, and reconcile the doc drift
    BOM rows 17-20 (PCA9685 16-ch I2C driver, 8 LEDs, resistors, I2C wire),
    ~$10.50-24.00, in a new "Lighting + I/O" category matching the file's existing
    format. Per Evan: all PWM moves to the PCA9685 - motor and servo as well as the
    four light channels, 6 of 16 used. That was Appendix AH's original portability
    argument (DonkeyCar's pins.py has a PCA9685 backend, so actuation stops being
    Pi-locked); lighting only made the channel count decide it too. The TB6612's two
    direction pins stay on GPIO - the backend drives PWM, not direction logic.
    TOTALS recomputed from the rows rather than carried forward. Rows 1-16 sum to
    $221.82-$224.8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
2026-09-02 Vehicle envelope, camera-height attempt 2 (negative), indicator logging
    ENVELOPE (cad/vehicle_envelope.py). Width/length/steering derived from track v2
    instead of measured off the Lego, so B2 has a pass/fail to meet. At the R=500
    corner: min steering lock 11.3 deg at a 100mm wheelbase rising to 19.8 at
    180mm; max car width 400mm with tangent corners or 200mm with 200mm straights.
    Length is bounded by OFF-TRACKING, which the project had not accounted for
    anywhere - a turning car sweeps wider than its own width, 41.7mm extra at a
    200mm wheelbase, and past ~160mm it breaches 50mm/side lane clearance. All are
    FLOORS from a bicycle model that ignores slip, Ackermann error and roll.
    HEIGHT cannot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
2026-09-02 Arduino Uno supersedes the PCA9685; codebase-memory bins updated
    BOARD IDENTIFIED. Uno R3 clone: ATmega328P TQFP, 5V logic, FTDI FT232RL,
    enumerating OK as COM3, driver already installed. I guessed CH340G from the
    photo and was WRONG - the USB vendor/product ID (VID_0403 PID_6001) is
    authoritative, a package outline is not.
    DECISION. Actuation moves to the Uno; the PCA9685 chosen yesterday in AY is
    dropped. The Uno does everything that part would (motor PWM + servo + 4 light
    channels, fitting with one PWM pin spare after Servo takes Timer1) plus two
    things it cannot: quadrature encoder counting on hardware interrupts D2/D3 -
    which a Pi does badly because Linux guarantees no interrupt latenc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
2026-09-02 Uno bring-up: first verified hardware in the project
    The board runs our firmware. Not stock Blink - clones ship with the factory
    image, so a 1 Hz LED proves nothing. The sketch uses a 3-fast-blinks-then-pause
    pattern AND a serial banner, so success is read rather than eyeballed:
    UNO-BRINGUP-OK build=2026-09-02 pattern=3fast+pause
    F_CPU=16000000
    Device signature 1E 95 0F confirms a real ATmega328P; F_CPU is the chip
    reporting its own clock; bootloader is STK500 v1 HW3/FW4.4; 2430 bytes (7%
    flash, 9% SRAM) uploaded over COM3. Upload path, bootloader and serial both
    directions all work. arduino-cli ships inside the Arduino IDE and needed no
    separate install.
    The trap worth keeping: ardui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
2026-09-02 Measure SRAM (2048 B) and the real clock (16.0042 MHz); correct BD
    Evan asked how much RAM the board has. 2048 bytes - but measuring it corrected
    an error, produced a real clock number, and turned up a signature conflict.
    CORRECTION to BD: "F_CPU is the chip reporting its own clock" is WRONG. F_CPU is
    a macro the build supplies; printing a constant you compiled in is circular. The
    chip never reported it. That mattered because avrdude's signature is shared with
    the LGT8F328P, which runs at 32 MHz, so the clock was exactly what needed
    independent measurement.
    SRAM, measured: RAMEND 0x8FF = 2048 B total, 1705 B free with a small sketch,
    1472 B obtainable by malloc in 46x32B blocks. freeRam re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
    [uno_memtest.ino]
2026-09-02 FTDI latency timer measured: ~0.9ms, not the 16ms I twice flagged as a risk
    Registry LatencyTimer really is 16, so the premise was right - a control reply
    is a short packet, exactly what the timer governs. The wire disagrees.
    firmware/uno_echo echoes a byte with no delay, formatting or flush, leaving USB
    out + microseconds of AVR + USB back. At the shape that matters (4-byte command
    -> 4-byte reply, paced at 20 Hz, 400 exchanges):
    p50=0.869 p95=0.956 p99=1.069 max=5.753 ms
    over 10ms: 0 over 16ms: 0 over 50ms: 0 fails: 0
    ~2% of the 50ms budget at p99, ~12% in the worst single sample. The serial link
    does not constrain the 20 Hz loop.
    THE MECHANISM IS NOT ESTABLISHED and I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
    [uno_echo.ino]
2026-09-02 Serial protocol v0.1 draft; fix D3 double-booked in yesterday's pin map
    Drafting the protocol found a real conflict in the diagram committed in
    5ee14a9: docs/BOM.md:153 gave D3 to the encoder's second interrupt and :164 gave
    D3 to motor PWM. The ATmega328P has exactly two external interrupts (INT0 on D2,
    INT1 on D3), so quadrature consumes both and D3 cannot also carry PWM. Wired as
    drawn, the encoder loses a channel and the motor fights it - erratic counts,
    which is the exact failure BC.2 says the Arduino was adopted to avoid.
    Corrected map in both the BOM diagram and firmware/SERIAL_PROTOCOL.md. Motor PWM
    moves to D11/Timer2, and that assignment is forced: Timer0 drives millis() so
    its fr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
2026-09-02 Fix all nine landing-check findings
    /landing-check swept 397c46a..590f765 cold, from artifacts only, and returned
    FIX FIRST with eight findings. A ninth turned up while fixing them.
    THE ONE THAT MATTERED was not a doc slip. "Fits with one PWM pin spare" (BC,
    repeated in three live docs) was falsified by the D3 fix in BG and nothing
    noticed. Servo claims Timer1 killing D9/D10 -> {3,5,6,11}; the encoder then
    takes D3 -> {5,6,11}, all three used by motor + headlights + tail. ZERO spare.
    There is no PWM headroom at all, and gotchas.md was still telling a future
    reader "usable PWM: 3, 5, 6, 11" with one of them spoken for.
    SELF-CONTRADICTION: firmware/SERIAL_PROTOCOL.md:14 warned that BOM.md CU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
2026-09-02 BOM: add verified product links, spot-check prices
    Source column now carries markdown links - a deliberate departure from this
    file's bare-domain convention, noted in the file rather than slipped in.
    Re-verified live and ALL UNCHANGED from the 2026-08-08 re-pricing: Pi 5 4GB
    $110.00 in stock, Camera Module 3 Wide $38.50 in stock, Pololu #1093 $23.95,
    Pololu #713 $4.95. So the stated TOTAL is current rather than stale - the first
    time this file can say that.
    Pi 5 2GB confirmed $65.00 and IN STOCK at pishop.us. That matters beyond price:
    it is the only path whose low end clears the $200 ceiling, and Adafruit lists it
    at $75 OUT OF STOCK, so the cheap path currently depends on a single vendor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
2026-09-02 BOM rows 11/13/14 linked; row 11 exposes a pack safety gap
    Row 11's board is titled "BMS" and the BOM credited it with "overcharge,
    over-discharge and short protection". Adeept's own page documents over-VOLTAGE
    and short-circuit protection only - over-discharge is NOT listed. The EVE 25P
    cells in row 9 are bare. So as written, nothing stops the 2S pack being run flat
    under motor load, which is what a driving robot does to a battery.
    That matters because below ~2.5V/cell lithium takes permanent capacity loss and
    can grow internal copper shunts that become a fire risk on the NEXT charge.
    Short-circuit is already covered by the mandatory inline fuse; this is the
    low-voltage end specifically, a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
2026-09-02 Pack low-voltage cutoff on the Uno: closes the BI safety gap
    Evan chose option (c) from Verify item 6. Implemented, uploaded, SELFTEST PASS
    27/27 on the real board.
    THE HARDWARE TEST CAUGHT A DEFECT THE DESIGN MISSED. The first build had a FAULT
    band for implausibly LOW readings, reasoning that an unwired A0 reads near zero.
    It does not - a floating pin sits near full scale, and the board reported
    "PACK OK mv=10248 throttle=allowed" with nothing connected. That is ABOVE a full
    2S pack, so it sailed past a low-only check and read as a healthy battery: the
    guard would have allowed driving with no sensor attached, the exact failure it
    exists to prevent. Fixed with an upper band (fault outside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
    [uno_packguard.ino]
2026-09-02 Fix eight landing-check findings; record the unfixable escape defect
    Second cold sweep of 590f765..930980b. The firmware control is genuine - every
    threshold walked on real hardware, SELFTEST 27/27 twice, 16/16 arithmetic and
    8/8 BOM totals exact, 14/14 URLs resolve - but the docs around it carried eight
    false or self-contradicting claims.
    UNFIXABLE, so recorded instead: this range put 21 lines of literal backslash-u
    escape sequences into the append-only record (0 at 590f765, 21 at HEAD, all in
    BH/BI/BJ). Cause was mine - those entry bodies were written with a QUOTED
    heredoc, which performs no escape interpretation, so an em dash written as an
    escape landed as six characters. Entries writte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
2026-09-02 Control firmware runs on the board; measured car geometry lands everywhere
    The actuation firmware is written, flashed and verified on the real Uno, and
    three of Evan's measurements replace estimates the whole track rested on.
    firmware/uno_control/ implements SERIAL_PROTOCOL.md v0.2.
    SELFTEST 37/37 on the board, host_test.py 11/11 exit 0.
    7134 B flash (22%), 312 B SRAM (15%), loop 2-3 ms of a 50 ms budget.
    ACTUATORS UNWIRED: link and state machine verified, nothing physical moved.
    It compiled clean while carrying three wrong assertions; only flashing it
    found them. One asserted the pack latch outranks a fault reading (the
    firmware is right, matching the 27/27-tested uno_packguard). Tw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
    [host_test.py, packguard.h, uno_control.ino]
2026-09-02 Lego motor question: correct a bin that overstated its source
    Evan asked whether an easily Lego-Technic-mountable motor exists. It does not,
    but checking found hardware.md claiming more than its own research supports.
    hardware.md said Lego motors were "rejected on physics, not price". The source
    (docs/research/2026-07-23_drive-motor-selection.md) says a 20t->8t step-up
    layshaft brings PF M to 0.92-1.74 m/s and calls that "workable" -- so after a
    step-up the rejection is on mechanism count, packaging volume and used-part
    cost, not on physics. Sound rejection, weaker claim than was recorded.
    The live constraint has also changed and is now the ENCODER, which did not
    exist as a factor when the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
2026-09-02 Steering: the servo-to-pinion coupling is specified nowhere
    Evan asked the Lego-mountability question about steering. The answer inverts
    the drive-motor one, and asking it exposed an unclosed mechanical interface.
    BOM row 7 is "MG90S metal-gear servo | Steering"; WIRING_PROTOSHIELD 2.4 covers
    its three wires. Nothing says how a splined servo horn reaches the 12-tooth
    Lego pinion Evan built. Same defect class as the missing TB6612 STBY: an
    interface every document assumes and none specifies.
    The drive-motor rejection does NOT transfer. Geekservo was rejected as a drive
    motor at 70-90 rpm; a steering servo needs position accuracy and torque, not
    rpm. Recorded explicitly so a future session d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
2026-09-02 Board re-flashed to uno_control; BQ.2's board-state claim is now stale
    Evan supplied the PowerShell upload command. Reading the board's boot banner
    showed it was still running uno_packguard (SELFTEST PASS 27/27) -- the upload
    had not landed, either pasted rather than run or failed on his end. Caught only
    by checking instead of assuming.
    Re-flashed and verified end to end: uno_control SELFTEST PASS 37/37,
    host_test.py 11/11 exit 0. Floating pack sense read 10266 mV, consistent with
    the 10164-10248 range from earlier runs and still classified FAULT.
    HANDOFF's Uno-firmware row corrected: uno_control is the currently flashed
    firmware, not uno_packguard.
    Actuators remain unwired.
    Co-Authored-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
2026-09-02 Pinion sweeps 180 deg: the servo span was capping steering at 60% of lock
    Evan measured the pinion at ~180 degrees full-left to full-right. That one
    number closes the servo question and exposes a defect in firmware flashed an
    hour earlier.
    A standard hobby servo maps 1000-2000 us onto 180 degrees, so centre-to-lock
    is 500 us. SERVO_US_SPAN was 300 -- 54 of the 90 available degrees, 60% of
    lock, ~19.2 deg at the road wheel against the measured 32. That is a turn
    radius 1.79x LARGER than the mechanism allows: the car would have failed
    corners it is geometrically capable of with nothing indicating why. The
    constant was written when the sweep was unknown and labelled "deliberately
    narrow" -- a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
    [uno_control.ino]
2026-09-02 Steering coupler is the highest-torque joint and a printed one fails
    Specifying the servo-to-pinion coupling (flagged missing in BS) produced the
    number nobody had computed. Scaling the drive research's own figure -- a
    printed Lego cross-axle stub sees 6.64 MPa at the N20's 55.9 mN.m stall against
    ~15-25 MPa PLA interlayer shear:
    N20 drive coupler 55.9 mN.m 6.64 MPa SF 2.26-3.77
    MG90S steering coupler ~216 mN.m 26.1 MPa SF 0.57-0.96 FAILS
    MG996R fallback ~1079 mN.m 128.3 MPa SF 0.12-0.19
    The exact inverse of the drive side. The drive research went to length showing
    the motor coupler is the LOWEST-torque joint and survivable; nobody ran the
    same check on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
2026-09-02 project-memory pass: PRD_ROADMAP and auto-memory were a session behind
    HANDOFF, the record and the bins were updated repeatedly this session while
    PRD_ROADMAP.md and the auto-memory went untouched -- so the roadmap still
    described a project with no firmware and an unmeasured car.
    PRD_ROADMAP, five edits, all append-or-strike, nothing deleted:
    - T1 "Confirm scale" CLOSED, original text struck not deleted. Car width
    114.75 mm measured, track_layout_v2 re-run: lane 260->230, span 2660->2629,
    spare 140->171, tiles 79->73. States the partial: the marking table itself
    is NOT yet recomputed, and T1's own done-check named that table.
    - M1.4b updated and deliberately NOT closed. Max steer 32 d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
2026-09-03 HANDOFF's workstream table contradicted itself on P6
    Answering 'what work is left' surfaced two stale rows.
    P6 appeared TWICE with opposite verdicts: DONE 2026-08-13 (Appendix AI/AJ,
    cause found -- donkey-generated-track-v0 regenerates per launch) and OPEN,
    BLOCKING all closed-loop claims (Appendix AD, 2026-08-11, cause unknown). The
    OPEN row is two days older and was never struck, so since 2026-08-13 it has
    been telling every reader that closed-loop claims are blocked when they are
    not. Struck in place with a pointer to the superseding row and the narrower
    surviving rule: never compare closed-loop numbers across launches.
    Track fabrication still quoted 1.6x2.8 m at 1:14 -- the floor Evan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
2026-09-03 PRD cleanup: 24 dated strikes/appends; P1-P3 stamped; P6 ticked; schedule escalated
    Evan asked for the PRD to reflect the current state. Done under the standing
    rule -- ADD by appending, REMOVE by dated strikethrough, never delete -- and
    NOT as a fork: the direction is unchanged, what drifted is hardware terms,
    estimates, and the schedule.
    Method: whole file read first, then 24 exact-match substitutions in one
    script that aborts before writing if any matches other than exactly once. It
    aborted on run 1 (one wrong anchor) and wrote nothing; run 2 applied all 24.
    934 -> 1130 lines; the 20 diff deletions are lines re-wrapped in ~~ ~~ with
    their original words intact.
    Terms wrong for weeks, st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
2026-09-03 Fix the watchdog false-trip the daily-audit found; verify red then green on the board
    A scheduled daily-audit (Appendix BY, 19:27 CDT) ran during the PRD cleanup,
    appended findings to the record uncommitted, and was swept into db6f37a unread.
    Its CRIT was in uno_control, declared "verified on the board" an hour earlier.
    Confirmed against the code before acting: loop() sampled millis() at the top,
    burned ~2 ms in the pack guard's analogReads, then handed handleFrame() a
    second, later millis() that became lastFrameMs. The watchdog subtracted the
    fresher stamp from the stale sample, unsigned, and wrapped past 150 ms on
    every iteration that handled a good frame. Effect with a motor wired: drive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
    [host_test.py, uno_control.ino]
2026-09-03 HANDOFF appendix count: 79 A-CA (was left at 77 A-BY)
    The previous chain reported the anchor miss but a stray ';' before the sweep
    echo reset the && guard, so the commit proceeded without this line and without
    the encoding sweep. Root cause of the miss: the PRD's wrong "Appendix BY" refs
    were corrected but HANDOFF's count line was never advanced past 77 A-BY.
    Sweep now run as an assertion and clean.
2026-09-03 Daily-audit findings given PRD homes as tasks A1-A7; A2 and A4 first
    CA.8 said the audit's deferred findings would get PRD homes and did not give
    them one. New AUDIT-2026-09-02 block in PRD s6, before s6b: seven checkbox
    tasks with the audit's file:line evidence and a done-check each.
    A1 no result file records its commit (0/108) . A2 split-seed leak in
    train_mdnrnn.py:165 and two siblings . A3 preprocess.py's claimed atomic swap
    . A4 collect_recovery.py asserts a gate that cannot pass (reproduced) . A5
    pre-commit fails open . A6 LIGHTING_SPEC still 20 mA/LED . A7 seven small
    hygiene items batched.
    Priority stated: A2 and A4 first -- silent correctness defects in the M3/M4
    data path. A1 bef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
2026-09-03 A4: the recovery gate was made TRUE, not exempted
    collect_recovery.py claimed "the PID identity gate still passes". True of the
    data, false of the gate: check_pid_identity diffed the recomputed PID against
    the EXECUTED action, into which that collector deliberately injects noise. It
    had never been run on ml/data/sim_recovery by any script, doc or CI, so the
    claim survived unchallenged.
    RED, exit 1, four failure classes -- pid-identity on 20/20 (max |diff|
    1.663858 at index 128, reproducing the audit exactly); mean|cte| 1.222 over a
    1.2 cap the collector deliberately raises to 2.5; "split check did NOT run,
    needs holdout/"; and an image-lag MODE of -2 from a 10/10 TIE resolved by set
    iterati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
2026-09-03 Status LED: quiet on a bench board, loud once a real pack has been seen
    Evan asked for the flashing to stop. It was the indicator working: pack=3
    (PACK_FAULT) from a floating A0 with no divider wired, blinking at 150 ms, AND
    the watchdog blinking at 400 ms because no Pi is sending frames.
    Silencing it by inference is not available. A floating pin and a sense wire
    that has FALLEN OFF read identically (~10,248 mV -- the measurement that put
    the upper fault band in uno_packguard). Going quiet on sight of a floating pin
    also goes quiet when the wire drops off a moving car.
    They differ in HISTORY, and history is one bool. PackGuard::everPlausible is
    set whenever a reading lands inside the fault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
2026-09-03 A1 done: every result names the commit that produced it; BOM audited
    PRD task A1. New ml/provenance.py (stdlib only) with stamp() and
    write_result(); all 23 ad hoc write_text(json.dumps(...)) sites across 21
    files converted by a paren-balancing transformer, not a regex. Stamps commit,
    dirty, dirty_files, ts_utc, python/torch/numpy. Refuses to write when it
    cannot determine the commit (A1's own done-check); records rather than refuses
    on a dirty tree, since dirty is the normal state while iterating and
    dirty_files is written into the file. Three list payloads wrapped as dicts.
    Live proof: train_cte_probe.py --epochs 1 wrote a JSON whose provenance.commit
    equals git rev-parse HEAD, with real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
2026-09-03 Landing-check fixes: A1's checkbox, a second clobbered file, two false claims in CF
    A /landing-check sweep on 2aed9ed and fa79791. No landing failure, no
    publication leak, core arithmetic exact -- but two claims in Appendix CF are
    false and the commit titled "A1 done" left A1 unticked.
    CF.3 said "No other result file was touched". FALSE. The --epochs 1 smoke test
    also overwrote ml/runs/cte_probe/cte_probe_mlp.pt, which .gitignore:34 (*.pt)
    makes untracked -- so git checkout could not and did not restore it, and the
    JSON claiming 40 epochs / R2 0.9571 sat next to a 1-epoch checkpoint while the
    record said the incident was closed. CF.3's stated lesson (git status ml/runs/)
    would not have caug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
    [uno_control.ino]
2026-09-03 A3/A5/A6/A7 close the audit; rear track 148.25 mm; and A7 found CR corruption I wrote
    Every PRD audit task A1-A7 is now done.
    A3: preprocess.py claimed "all four outputs swapped in together" -- it renames
    four files one at a time, which cannot be atomic. Guarded on the READ side
    where the corruption reaches a trainer: splits.load_proc now refuses per-frame
    disagreement, per-episode disagreement, and the cross-check that actually
    catches a half-swapped set (the episode index must cover exactly as many frames
    as the image array holds). My FIRST guard was wrong -- I assumed episodes was
    per-frame when it is (N,2) [start,length] -- and the green run on the real
    corpus caught it. Green: 91,678/7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
2026-09-03 Width fully measured: rear track governs at 148.25; Pi decided at 4GB by stock
    Front track 107.5 mm, rear track 148.25 mm, body 135.75 mm. The rear track is
    the widest point, so 148.25 governs -- and TWO long-standing caveats close at
    once: this is now a WHOLE-VEHICLE width (the body is 12.5 mm narrower, so the
    rear wheels stand 6.25 mm proud per side), and the front was re-measured
    unchanged after the new rear wheels. Lane 296.5 / span 2696.5 / spare 103.5 are
    UNCHANGED -- the first width measurement in three days that confirmed the track
    arithmetic instead of invalidating it.
    The front track is only 72.5% of the rear, a 40.75 mm split that was never a
    recorded design decision. Two consequ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
2026-09-03 Vendor consolidation: no single vendor; SparkFun's N20 fails the Lego-motor speed floor
    Three sweeps (Adafruit, SparkFun, Pololu), all against live pages. Adafruit
    10/22, SparkFun 13/22, Pololu 5/22 -- and the gaps are CATALOG gaps, not stock
    gaps. Adafruit's power line is 1S-LiPo-with-JST-PH so loose-cell 2S is not a
    product there; Pololu's battery category is NiMH AA/AAA only. No catalog
    carries a 1000 RPM 30:1-class encoder motor AND loose 2S lithium AND automotive
    fusing. Plan for three vendors.
    SparkFun's ROB-28633 N20 encoder motor is disqualified on physics, not price:
    500 RPM no-load at 6V against the Pololu #5159's 1000. Config B gives 1.28 m/s
    at 1000 RPM, so it lands at ~0.64 m/s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
2026-09-03 Pack safety hole CLOSED: a charger is not a BMS, and we aimed the requirement wrong
    Open since Appendix BI and called "the hardest item to source" in CJ.4
    yesterday. It was never a sourcing problem.
    BOM row 11 asked ONE board to both charge the pack and protect it. No vendor
    sells such a board, and that is structural, not market luck: a charger IC
    terminates CHARGE, sits on the INPUT side, and has no discharge-path FET to
    open. Over-discharge cutoff needs per-cell sensing and a series FET on the pack
    OUTPUT -- a BMS's job. The part was never missing; the requirement was aimed at
    the wrong part.
    Fix is two boards in series: Adeept p0374 keeps the USB-C charger role (row 11,
    unchanged), plus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
2026-09-03 DigiKey falsified as a consolidator, but cheapest on three Pi parts; 4GB restock 2026-10-05
    DigiKey was the one hypothesis that might have collapsed the three-vendor split
    -- it is an authorized distributor for Adafruit, SparkFun AND Pololu. It does
    not work, and the reason is structural: the Pololu parts are DigiKey
    MARKETPLACE, not DigiKey inventory. Both #5159 and #4763 state "Will ship in
    approximately 1 days from Pololu. A separate shipping fee may apply." That is a
    Pololu order with a DigiKey invoice -- a second parcel and a second shipping
    charge on exactly the items that made consolidation attractive. It also stocks
    no high-drain 18650 (their cells top out at 520 mA continuous), no 2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
2026-09-03 BOM: add a per-vendor ORDER SHEET and make the price column machine-summable
    Update requested after a session of row-by-row patching left the BOM a research
    archive rather than a shopping list.
    The defect found while verifying: the price column was polluted with historical
    annotations -- "(was $70.00)", "(+$6.00)", "(pishop $38.50)" -- so the table
    could not be summed and its low bound was garbage (a naive parse gave
    $185.74-$267.89). History stripped from 7 price cells; every one of those notes
    already exists in the notes column, so nothing was lost. The column now parses,
    and the rows sum to $262.44-$268.69, which the TOTAL row now states exactly
    instead of approximating.
    New ORDER SHEET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
2026-09-03 Vilros checked before checkout: linked variant is a $179.99 kit, not a bare board
    Evan named a purchase link. The variant URL pre-selects the Vilros Basic
    Starter Kit (SD card, cooling, PSU, HDMI adapter, storage bag, RTC connector,
    camera adapter) at $179.99, not the ~$110 bare board this BOM specs. Read
    directly off the rendered page rather than accepted from the link.
    A second check disagreed, claiming $179.99 was the Board Only price -- the
    direct page read showed the Basic Starter Kit selected at that price.
    Trusted the direct read; Board Only's actual price/stock was not obtained
    (browser click-through failed to render). Not recommended as linked: the
    kit's SD card and cooling duplica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
2026-09-03 Pi decision finalized: Vilros Basic Starter Kit $179.99, folds three BOM rows into one
    Evan confirmed 4GB IS in stock at Vilros -- direct checkout access, stronger
    evidence than Appendix CM's browser check which hit a render failure before
    confirming Board Only availability. He's buying the Basic Starter Kit
    ($179.99), not a bare board.
    Kit contents supersede two BOM rows, both marked in place rather than deleted:
    row 4 (microSD 32GB A2/U3, $21.95 -> $0, included) and the flagged Active
    Cooler row ($5.00 at DigiKey, never counted -> $0, included). Two caveats kept
    open rather than silently resolved: the kit's SD card is Class 10, a lower
    speed class than the A2/U3 row 4 specified -- whether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
2026-09-03 BOM: hyperlink every sourced item in the order-by-vendor table
    The three DigiKey links (SC1224, SC1892, SC1148) weren't already recorded
    anywhere in the BOM -- only SKU and price. Rather than guess a DigiKey
    product-detail URL (their slugs carry a numeric ID that isn't derivable from
    the SKU alone), found and live-verified all three via WebFetch before
    committing them: title, price and stock confirmed on each page against what
    the BOM already claimed.
    Every other link (Vilros, Pololu x3, IMR, Amazon, Adeept, SparkFun,
    AloftHobbies, bc-robotics) was already verified earlier in the session --
    reused those exact URLs rather than re-fetching. The Vilros link uses Evan's
    original variant-specifi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
2026-09-03 BOM: correct the ACEIRMC BMS row -- $9.59 is an 8-pack, not one board
    Evan asked whether the build really needs 8 of these. It doesn't -- one is
    needed -- but the question caught a real error: row 11b (from Appendix CK)
    priced $9.59 as if it bought a single board. Verified live on the Amazon
    listing, whose own title states "(8pcs)"; no single-unit option exists on
    the page, smallest available pack is 5-for-$8.59.
    Corrected in row 11b and the ORDER SHEET's Amazon line. No total change --
    $9.59 was already the right price, only the per-unit framing was wrong.
    Recorded as a positive rather than pure correction: per-unit cost is lower
    than assumed ($1.20/board vs the 5-pack's $1.72), and the 7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
2026-09-03 BOM: fold small-order and general items onto Amazon; +$105, stated plainly
    Evan asked to fold the "general / any" and "small-order problem" rows into
    existing vendors, preferring Amazon/eBay where they couldn't fold in. Both
    rows resolved -- one item (row 22, the servo-to-pinion coupling) genuinely
    has no Amazon/eBay match, reported honestly rather than force-linked.
    Verified live via the browser (WebFetch can't read Amazon's dynamic
    price/stock, confirmed again): MG90S metal-gear servo $7.99/2pk (first
    candidate was out of stock, found this via its own "consider these"
    carousel); Uno proto shield $7.79/2pk+breadboard; genuine-Amass XT30 pairs
    $11.99/20pk; fuse holder+70 assorted fuses INCL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
2026-09-03 BOM: link the six commodity items + five stale "any" rows, total → $452.20
    Evan asked to put the links in the BOM after Appendix CP left six Amazon-row
    items (22/26 AWG wire, heat shrink, headers, Dupont jumpers, USB-A-to-B
    cable) unlinked with only a budget guess. All six are now live-verified
    (title/price/stock read off the rendered page): $71.86 total, over the
    $35-45 guess, mostly because of the two wire kits ($45.48 alone).
    Extended the same fix to five numbered-table rows that still said "any"
    with zero link (servo, wire/heatshrink/caps/headers, LEDs, resistors,
    Dupont+USB, proto shield) using links already verified this session -
    the BOM now has zero unlinked "any" placeholders any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
2026-09-03 BOM: USB-A-to-B cable already owned, row 20 drops $5.12, total → $447.08
    Evan already has a ~3ft USB 2.0 A-to-B cable plugged into the Arduino
    right now - no need to buy the one verified in Appendix CQ minutes
    earlier. Struck the purchase, marked row 20 CABLE OWNED, dropped the
    Amazon-folded row from 17 to 16 items ($167.02 -> $161.90).
    Flagged rather than assumed away: the 5V-cut requirement in row 20 still
    applies once this cable is repurposed for the permanent Pi<->Uno link -
    owning it doesn't unmold it. Also surfaced an open question this doesn't
    answer: whether this cable stays on the bench for programming and a
    second one gets bought, or gets repurposed and lost as a debug cable.
    R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
2026-09-04 Drivetrain: real gear is 20t->28t (N=1.4), top speed 4.1-4.7mph over target
    Evan gave two wrong top-speed estimates in a row (0.2mph double-applied
    the 30:1 gearbox ratio; ~6mph skipped the differential's external gear
    stage). Asked which gear his actual differential uses to settle it -
    his answer was 20t (motor shaft) -> 28t (diff ring), N=1.4, plus 12t
    internal spider gears (irrelevant to ratio).
    That's the July research doc's Config A, not Config B (12t->28t,
    N=2.333, 62.4mm tire) that hardware.md, PRD_ROADMAP.md and HANDOFF.md
    all called "the lower-risk build." The doc's own open question - whether
    Config A's in-plane 20t/28t mesh is physically real - is closed: it is.
    But it's paired w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
2026-09-04 BOM: right-size the wire kits, 450ft -> 180ft, total -> $427.78
    Evan asked "why do i need so much wire" about the 150ft (22 AWG) +
    300ft (26 AWG) kits added earlier today. He was right - that was the
    largest size pre-selected on each listing, not a considered choice.
    Every realistic wire run on this car (motor/battery/BMS/servo leads,
    8 LED pairs, pack-sense divider) adds up to roughly 15-30ft with
    generous slack, nowhere near 450ft.
    Both listings sell smaller sizes on the same page: 22 AWG down to
    6x5ft ($9.69, was 6x25ft/$20.49), 26 AWG down to 6x25ft ($16.49, was
    6x50ft/$24.99 - 25ft is the smallest tier that listing offers). Per-foot
    price is actually worse at the smaller 22 AWG size ($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
2026-09-04 BOM: swap to Evan's cheaper wire find (SCHDRA), total -> $422.35
    Evan sent a link to a SCHDRA 26 AWG wire kit he found himself, minutes
    after the wire kits were right-sized to Fermerry's smallest tier
    (Appendix CU). Verified live: $9.99 for 6x20ft, In Stock, Amazon's
    Choice - cheaper than the Fermerry pick ($16.49/6x25ft) for less wire.
    The listing is a multi-gauge product family (one page, a Size selector
    spanning 18-30 AWG in PVC and silicone) - checked the 22 AWG silicone
    variant on the same family too: 6x13ft, $10.76, In Stock, its own ASIN.
    Switched both gauges to SCHDRA: $20.75 total (was $26.18), a further
    $5.43 saved, for slightly MORE wire (198ft vs 180ft) with a better
    gauge balan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
2026-09-04 BOM: revert 22 AWG to Fermerry, right-size rocker switch + fuse holder
    Two things in one message: (1) correction - Evan only switched 26 AWG
    wire to SCHDRA (Appendix CV), not 22 AWG too; reverted 22 AWG back to
    the Fermerry 6x5ft pick he already has ($9.69). Final wire: Fermerry
    22 AWG + SCHDRA 26 AWG = $19.68.
    (2) "all the other amazon items have very large part counts see if
    there are options for less" - audited the remaining 9 bulk items live.
    Two real wins:
    - Rocker switch: SparkFun single-unit -> 10-pack ($15.00) -> DaierTek
    5-pack ($6.39) - half the pack, better spec match (12V DC/automotive
    vs the old 125VAC household rating), pre-wired.
    - Fuse holder: 10 holders/70 fuses ($9.98)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
2026-09-04 Lighting: 8 discrete LEDs -> WS2812B strip, frees 2 PWM pins, total <$400
    Evan proposed 2 RGB LED strips instead of 8 discrete 3mm LEDs -
    "much easier to wire and mount." Verified the claim and found a
    bigger reason than the one he gave: the old scheme used the car's
    last 3 free PWM pins with zero spare; an addressable strip needs one
    software-timed digital pin, freeing 2 of those 3.
    Checked LM2596 headroom before pricing anything: the module is rated
    3A (Addicore's own listing - closes a gap WIRING_PROTOSHIELD.md had
    flagged as unverified). Existing peak load 840mA leaves ~2.16A
    margin; a strip at realistic brightness draws well under that.
    Caveat stated plainly: that's the rated capabilit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
2026-09-04 Fix: WS2812B cut segments need 2 data pins, not 1 (data is one-way)
    Evan: "the led strip only moves data 1 way." Right - Appendix CX's
    plan described the 2 cut strip segments as sharing ONE data pin.
    WS2812B is DIN->DOUT only; a physical cut severs the chain entirely,
    so each segment needs its own data feed.
    Fixed in docs/BOM.md (row 18 + its note paragraph) and hardware.md:
    two digital pins, one per segment, not one. Named the daisy-chain
    alternative (jumper from segment A's DOUT to segment B's DIN) and why
    two independent pins is simpler for this car - no wire routed across
    the chassis, no DIN/DOUT mix-up risk at the joint. The PWM-pins-freed
    count is unchanged either way (2 of 3), since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
2026-09-04 Quantify the 2 open WS2812B figures: tick loss ~0.027%, current ~80mA
    Evan: "resolve the 2 open figures in hardware.md and BOM." Appendix CX
    left two things qualitative - strip current draw ("well under that")
    and encoder tick loss ("can drop ticks") - without computing either.
    Computed both from established project constants.
    Tick loss: 358 counts/rev, N=1.4/55.75mm tire (Appendix CS), WS2812B's
    ~30us/pixel write time, and the firmware's existing BLINK_MS=340ms
    constant reused for indicator blink rate. Worst case (no-load top
    speed, continuous indicator blink, 3 pixels/segment): ~0.027% of
    ticks lost, about 1 in 3800, ~1.1 ticks/sec.
    Current draw: grounded against the old scheme's own est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
2026-09-04 Vet + rewrite the wiring diagram for the WS2812B strips; fix the pin map
    Evan: "vet the entire wiring diagram." Two findings would have stopped a
    build, eight would have misled one.
    STOPPERS:
    - WIRING_PROTOSHIELD.md 2.2 named Pololu #1093, the NO-ENCODER motor,
    while 2.3 of the same file wires six encoder conductors and 4.3 of the
    same file documents the correction to #5159. Self-contradictory for
    three weeks; the stall figure was right for either part, which is why
    it survived.
    - No pin assignment existed for the strips at all. 2.5 still assigned
    four light channels that no longer exist, zero pins for what replaced
    them. Assigned D4/D7 - plain digital, because NeoPixel bit-bang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
2026-09-04 landing-check: fix a mislanding, a $9.82 total, and three false universals
    A landing-check sweep over this evening's 10 commits, run by a fresh agent
    given the artifacts and NOT my account of them. Every finding re-verified by
    hand before acting.
    THE MISLANDING. firmware/uno_control/uno_control.ino still implements the
    discrete-LED scheme it was superseded from: analogWrite on D5/D6,
    digitalWrite on D4/D7. SERIAL_PROTOCOL.md - the doc line 1 of that file says
    it implements - now reads D4/D7 = strip DIN, D5/D6 FREE. Flashing it with
    strips wired drives static levels into two WS2812B data inputs.
    NOT rewritten, deliberately: needs a NeoPixel library, an undecided pixel
    layout, and an answer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
    [uno_control.ino]
2026-09-04 Task 8e: rewrite uno_control lighting for WS2812B; bring LIGHTING_SPEC current
    firmware/uno_control/uno_control.ino: applyLights() now drives two
    Adafruit_NeoPixel strips on D4/D7 (3px/segment: white head+DRL, red tail,
    amber indicator), replacing the superseded 4-channel discrete-LED scheme
    on D4-D7. DRL folds into the head pixel only, never the tail (Evan).
    Fixed a real bug the rewrite exposed: loop()'s watchdog branch calls
    applyLights() on every free-running loop() iteration, not once per 50ms
    frame -- unthrottled, NeoPixel::show()'s interrupt-disable window would
    have made the encoder blind almost continuously during a link drop
    instead of the ~0.03%/tick Appendix CZ estimated. Fixed wi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
    [uno_control.ino]
2026-09-04 Close Geekservo 270; wheelbase geometric estimate; coupling status; fix stale Pi/order rows
    steering.md: Geekservo 270 rejected, MG90S kept (36.0N rack force vs
    Geekservo's 14.7-16.4N) -- Evan's call, closes the HANDOFF item that wanted
    the car weighed to arithmetic-check Geekservo's 14.7N (moot now, not
    answered by weighing). Wheelbase geometric estimate: Evan measured 9.25in
    wheel-to-wheel overall length (not axle-to-axle wheelbase); derived
    wheelbase ~= 179.25mm using the 55.75mm rear tire diameter (Appendix CS),
    front tire diameter unconfirmed. R_min ~= 287mm, tighter than the 330mm
    estimate the frozen corner-radius band was checked against (favorable);
    T2's empirical test still gates co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
2026-09-04 Correct wheelbase estimate: front/rear tires differ (42.25mm/55.75mm)
    Appendix DD's wheelbase derivation assumed front and rear tires shared
    the rear/drive tire's 55.75mm diameter (flagged unconfirmed at the time).
    Evan: front tires are 42.25mm. Wrong, not just unconfirmed -- recomputed
    with separate front/rear radii:
    wheelbase ~= 234.95 - (21.125 + 27.875) = 185.95mm (was 179.25mm)
    R_min = 1.600 x 185.95 ~= 297.5mm (was 286.8mm)
    Still smaller than the ~330mm estimate the frozen 500-670mm corner band
    was checked against (favorable); T2's empirical test still gates corner
    geometry. Corrected in steering.md, HANDOFF.md (row 3b + BLOCKED-ON-EVAN
    note), PRD_ROADMAP.md task 4. Record: Appen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
2026-09-04 Steering coupling chosen: Adafruit #4252; BOM total corrected to $402.45
    Evan: "it's the adafruit 4252 adapter." Closes the open question from
    Appendix DD -- the part BOM row 22 and steering.md already named as the
    manufactured candidate is the one Evan built. He reports it "strong,"
    which empirically confirms the spline fit on his real MG90S (Adafruit's
    own listing would not guarantee that beyond their own micro servo).
    Does NOT close PRD task 8c(ii) fully: the done-check wants a stated
    stall-torque margin, and none can be computed for this part the way
    Appendix BV computed one for a printed PLA coupler (SF 0.57-0.96) --
    the #4252 is injection-moulded, a different failure mode, and Adafrui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
2026-09-04 Printed servo-to-Lego steering coupler: STL + generator, validated, unmargined
    Evan objected to ~$10 Adafruit shipping for the $0.75 #4252, then asked for
    a printed part. Searched Amazon, eBay and AliExpress: no other commercial
    source exists, which confirms BOM row 22 rather than overturning it (and
    Adafruit has no free-shipping threshold, so there is no bundling escape).
    scripts/gen_servo_lego_coupler.py -> cad/servo_lego_coupler_v1.stl, zero
    dependencies, same self-validating pattern as gen_tolerance_coupon.py
    (refuses to write a non-manifold or inside-out mesh):
    triangles : 1152
    manifold : duplicate-directed-edges=0 unmatched-edges=0 -> PASS
    volume : 1015.1211 mm^3 (expec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
    [servo_lego_coupler_v1.stl]
2026-09-05 M1.3 tolerance coupon v1 printed and tested: pin PASS, axle FAILS all six; v2 regenerated
    v1 printed (Bambu P1S, Bambu ABS Black -- ABS now replaces the PLA/PETG
    plan entirely, Evan's call). Pin row PASSES at 4.80mm, the bottom of the
    tested range and the best of the three fits reported. Axle row FAILS at
    every tested diameter (5.20-5.70mm) -- "even the smallest ones seems a bit
    big" -- the sweep bracketed nothing at the tight end, exactly the
    contingency cad/README.md's procedure anticipated ("edit the ranges...
    and re-run rather than guessing beyond the ends of the sweep").
    Three rounds of clarification were needed to identify which physical row
    Evan had actually tested -- his first repor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
    [tolerance_coupon_v2.stl]
2026-09-05 Power bank confirmed 5V/3A, 10,000mAh -- last BOM Verify item closed
    Evan: "5V/3A confirmed 10,000 mAh." Closes BOM Verify item 1, the last
    open item on the pre-order checklist. Bonus: 10,000mAh matches
    docs/research/2026-07-23_power-system.md's own working assumption
    (Battery A, ~4.3h Pi-only runtime) exactly -- that runtime figure is now
    confirmed against real hardware rather than carried as an assumption.
    Also caught while syncing the HANDOFF checklist: the PRD Appendix A1
    pre-order list has a 12-tooth bevel gear bin-check that was never
    confirmed and isn't closed by anything on record -- now the one
    remaining physical check before ordering.
    Record: Appendix DJ. All six BOM Verify items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
2026-09-05 Bevel gear bin-check: not confirmed, still open
    Evan: "I prob have one and if not i can print one." Not a confirmation --
    left the checklist item open rather than checking it off, with the plan
    noted. Flagged that a bevel gear's meshing tooth profile is harder to
    print correctly than the coupon's round holes or the coupler's socket, so
    it isn't the same-difficulty fallback if the bin comes up empty.
2026-09-06 M1.3 closed: tolerance coupon v2 axle result is 5.00mm, both headline numbers determined
    Evan: "3rd smallest hole is best for axel." v2's axle sweep ascends
    4.80/4.90/5.00/5.10/5.20/5.30mm -- third smallest is 5.00mm.
    pin holes model at: 4.80 mm (v1, Appendix DI)
    rotating axle bores model: 5.00 mm (v2, this entry)
    5.00mm sits between the pin's snug-fit diameter (4.80) and v1's smallest
    too-loose axle diameter (5.20) -- the physically sensible zone, matching
    the reasoning that moved v2's sweep down in the first place.
    Only the winning row was reported, not a verdict for every row -- recorded
    as "not reported" for 4.80/4.90/5.10/5.20/5.30, not assumed pass or fail.
    Still open,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
2026-09-06 Steering rack swapped 7-stud to 13-stud: max steer genuinely 58deg, R_min 297.5mm to 116.2mm
    Evan: "new steering angle 67 degrees" -- took three rounds to record safely.
    "67" was ambiguous (raw reading vs deviation); the correction that followed
    ("protractor reading is 32") computed to a 58deg deviation that is the
    EXACT complement of the old 32deg figure (32+58=90) -- too clean to accept
    without checking, given this project already lost a 2.6x turn-radius error
    to exactly this reading-vs-deviation confusion once (Appendix BQ). Asked
    directly whether the mechanism changed. It did: "i used a 13 stud long gear
    rack instead of the 7 length old one." Genuine, verified arithmetically
    (python3: ta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
2026-09-06 Max steer capped at 45deg for margin; front track re-measured 155mm, governance flips
    Evan sent three things in one message; two recorded, one left open.
    1. "add some margin so make the max curve be only 45 degrees." Design
    choice on top of Appendix DL's measured 58deg mechanical max -- same
    pattern as SERVO_US_SPAN=450 holding back from its own geometric max.
    R_min (mechanical, 58deg) = 116.2mm -- unchanged, still real
    R_min (planning, 45deg) = wheelbase = 185.95mm exactly (tan 45 = 1)
    2. "front wheel width of car outside to outside is now 155mm." Directly
    comparable to Appendix CI's 107.5mm front-track figure -- a real jump
    from the steering rebuild. Consequence: front (155) now e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
2026-09-06 Correction to DM: 58deg/270deg measured with no servo -- real ceiling ~38.7deg estimate
    Evan confirmed the ~270deg shaft is the pinion ("the shaft that the servo
    will be connected too"), then confirmed the 58deg wheel-deviation figure
    was measured "no servo involved" -- same as the 270deg figure, bare
    linkage, hand-turned to the rack's own end.
    This means both numbers describe the RACK's limit, not the MG90S's. The
    servo is a fixed 180deg part (90deg each way) independent of the rack --
    and the rack (135deg each way, from 270/2) now out-travels it, the
    reverse of the old setup where both were ~180deg.
    Using the same linear pinion-to-wheel ratio this project has always used
    (unverified, fla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
2026-09-06 Servo candidate found for the full 135deg range: HOOYIJ MG90D-270
    Evan asked directly for a servo covering the rack's full 135deg each way
    (Appendix DN found the MG90S caps at 90deg each way). Found: HOOYIJ
    MG90D-270, $16.99/4-pack, Amazon B0D5YBL2JX -- full spec sheet pulled from
    the live listing, not a summary.
    20T spline, 4.9mm dia -- SAME as MG90S; existing coupler design
    (Adafruit #4252, servo_lego_coupler_v1.stl)
    shouldn't need redesign
    2.2 kg-cm stall @ 6V -- same class as MG90S, doesn't worsen the
    coupler SF problem the way MG996R does
    500-1500us OR 1500-2500us (half the pulse rang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
2026-09-06 Add HOOYIJ MG90D-270 servo to BOM row 7, replacing MG90S (+$9.00, total $411.45)
    Evan: "add it to the BOM." Confirms Appendix DO's candidate as the actual
    choice.
    row 7: $7.99 (MG90S 2-pack) -> $16.99 (MG90D-270 4-pack)
    Amazon-folded: $116.52 -> $125.52
    BOM total: $402.45 -> $411.45
    all-in estimate: ~$415-430 -> ~$424-439
    Reason unchanged from Appendix DO: the 7-stud-to-13-stud rack swap gave
    the pinion 135deg of travel each way; the MG90S is fixed at 90deg each
    way and can't reach it. Same 20T/4.9mm spline and 2.2kg-cm torque class,
    so the existing coupler design shouldn't need rework -- still unconfirmed.
    Still not ordered -- this is a planning decision, not a p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
2026-09-06 3DStreet MCP tools live and verified; blocker open since 2026-09-01 now closed
    Evan pasted the relay's pairing confirmation; verified with a real call
    rather than trusting the status text. mcp__3dstreet__getSessionInfo
    returned build 2026.8.0+70fef93c, scene
    87740b35-811b-4c80-a384-7adb7ad4742e, saved:true, isAuthor:true. 26 tools
    exposed.
    The 2026-09-01 diagnosis was right and took three sessions to clear: the
    project-scoped .mcp.json server needed Evan's approval, and a session's MCP
    registry is fixed at startup, so the approving session could never see the
    tools. This session started after both approval and pairing.
    Two facts that change how it must be used:
    - AUTOSAVE IS ON (saved:true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
2026-09-06 Session sync: HANDOFF rewritten, drift sweep across every live doc
    Ran the project-memory HANDOFF workflow after 16 commits
    (5349efe..015425b). Record: Appendix DR carries the session snapshot.
    Drift the sweep caught, none of it introduced this session:
    - HANDOFF still claimed "Nothing has been printed and nothing has been
    ordered since 2026-07-23" -- false since 2026-09-05, two coupons exist.
    - HANDOFF's Immediate-next-actions table had become a graveyard of closed
    rows (every one already in the record, DI-DQ). Rewritten to only what's
    open, cheapest-first: 5 items runnable with no parts, 4 blocked on the
    order.
    - PRD_ROADMAP.md and README.md both still called the tolerance coupon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
2026-09-06 Track floor-fit fixed at root cause; marking table recomputed at the derived 1:11.80 scale
    Three appendices, DS/DT/DU, all verified with real output.
    DS - cad/track_layout_v2.py self-check failed at R=500 (90 mm spare against
    its required 100). Root cause was NOT the car outgrowing the floor:
    best_straight() sized the straight against the whole 2800 mm usable while
    self_check demanded 100 mm of it be left unused. They never agreed; the
    200 mm straight cap hid it until the 155 mm front track pushed lane to
    310 mm and ate the slack. Fix is a SPARE_MIN=0.100 constant that
    best_straight now RESERVES and the check asserts, plus MAX_STRAIGHT
    200 -> 190 mm (at 200 the span lands exactly on the flo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
2026-09-06 3DStreet street built; track proven single-lane, so the dash moves to the edges
    Appendix DV. First 3DStreet work that actually touched the scene.
    STARTUP RULE CONFIRMED BOTH DIRECTIONS. Restarted with the tab already
    paired: all 26 mcp__3dstreet__* tools registered on the first ToolSearch.
    Appendix DT had proven the negative (paired mid-session, server even
    reconnected, six queries, zero tools). Now tested deliberately rather than
    observed once.
    THE TRACK HAS ONE LANE, and that is a defect in Appendix DU written 40
    minutes earlier the same day. SIM_TRANSFER_SPEC section 3 sets lane:vehicle
    = 2.0x, benchmarked against a 12 ft lane / 1850 mm car body = 1.98x, so
    310 mm is ONE lane. track_lay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
2026-09-06 Track switched to two lanes at 250mm each; lane/road conflation refactored out
    Appendix DX. Evan's call, in two steps.
    TWO LANES at the SIM_TRANSFER_SPEC 2.0x rule need a 620mm road, and at that
    width the 3x3 grid fits ONLY at R=500 -- committing frozen corner geometry to
    the optimistic end of the 500-670 band before T2 has run. Evan chose 250mm
    lanes (LANE_TO_CAR = 1.613) instead, which also fits R=550. 1.613x sits inside
    Duckietown's measured 1.4-1.6x band, so it is a sourced deviation from the
    2.0x rule, not an arbitrary one.
    Real output:
    lane width 250 mm per direction (1.613 x car)
    road width 500 mm total, 2 lanes
    street pitch 1100 mm (straight between corners 100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
2026-09-06 Marking + substrate layout; the seam rule had no enforcement and MARK_W was 2.4-3.6x too wide
    Appendix DY. New cad/marking_layout.py, plus two defect fixes in
    cad/track_layout_v2.py.
    THE SEAM RULE WAS ENFORCED BY NOTHING. There are TWO tilings and no document
    had ever distinguished them: substrate panels (foam board) and printed marking
    strips. gotchas.md's rule -- a seam running perpendicular to travel reads as a
    STOP BAR to the model -- constrains the SUBSTRATE. The only tiling ever
    computed (print_plan's ceil(printed_len/0.200) = 122) counts STRIPS. Now
    satisfied by construction: substrate strips run ALONG travel, 2 per 500mm road,
    and the single longitudinal seam lands ON the centreline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
2026-09-06 3x3 grid recreated in 3DStreet -- street network only, and it contradicts DY's markings
    Appendix DZ. Scene work only; no CAD file or generator output changed.
    BUILT: 6 managed streets, scale-converted from track_layout_v2.py at 1:14.63.
    Pitch 1100mm -> 16.0934m, span 2700mm -> length 39.5m, road 500mm -> 7.3152m
    (2 x 12ft). Two drive lanes each, dashed yellow centreline, solid white edges,
    no vehicle models. Verified by read-back: managed-street-2lwz3p134 reports
    position "0 0 16.0934", rotation "0 90 0", length 39.5.
    WHAT IS MISSING IS THE IMPORTANT HALF. No corner arcs and no figure-8 route --
    3DStreet has no curved streets, so the junctions are square and the geometry
    the car actually f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
2026-09-07 OpenDRIVE export: the arc primitive 3DStreet lacks, plus LaneMaker's roadRunnerProfile decoded
    Appendices EA and EB.
    WHY THIS EXISTS. Appendix DZ recorded that 3DStreet cannot represent the R=500
    corner arcs -- a managed street there is a cross-section extruded along a
    STRAIGHT line. Evan installed LaneMaker; its SampleMaps turned out to be
    OpenDRIVE (.xodr), whose <planView> takes <line>, <arc>, <spiral> and
    <paramPoly3>. The samples use 356 arcs and 286 spirals. So the geometry that
    makes this a track rather than a street plan is a NATIVE primitive in a format
    already on disk.
    NEW cad/export_xodr.py -- emits the driven route as one closed road:
    scale FULL, x14.6304 (the 1:14.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
2026-09-07 LaneMaker bisection ladder: all 4 probes load; both crash hypotheses were wrong
    Appendix EC. Evan reported LaneMaker CRASHING rather than rejecting the
    profile-bearing .xodr.
    DIAGNOSED FROM WINDOWS MINIDUMPS, not guessed. Two dumps in
    %LOCALAPPDATA%\CrashDumps\. Parsed the MINIDUMP_EXCEPTION_STREAM directly, no
    debugger:
    thread 42208 code 0xC0000409 fault address 0x00007FF888D4527E params=1
    exception info ['0x7']
    0xC0000409 param 7 = FAST_FAIL_FATAL_APP_EXIT, the MSVC std::terminate/abort
    path -- an UNHANDLED C++ EXCEPTION, not memory corruption. Identical fault
    address in both dumps, so deterministic and the same code path. That reading
    ruled out a whole class of causes and fits t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
2026-09-07 3x3 grid exported as OpenDRIVE; _add_road extracted from two near-duplicates
    Appendix ED. Closes the gap EA and EC both ended on -- "still not exported: the
    3x3 grid, the 9 intersections, junction records".
    export_xodr.py --grid -> cad/track_grid3x3.xodr (and _model.xodr):
    roads 6 (3 along Z, 3 along X)
    street length 39.5021 m each
    street pitch 16.0934 m
    road width 7.3152 m, 2 lanes
    crossings 9 (geometric only)
    Same pitch and length as the 3DStreet scene from Appendix DZ, so the two
    independent representations of the grid agree.
    NO JUNCTION RECORDS, deliberately. The 9 crossings are geometric -- the roads
    simply overlap. Appendix EC licenses this: prob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
2026-09-07 Proper junctions with turn arcs; kerb return radius reconciles the figure-8 with the grid
    Appendix EE. export_xodr.py --junctions -> cad/track_grid3x3_junctions.xodr:
    56 roads (12 street segments + 44 connecting roads), 9 junctions, 32 turn
    arcs, 44 laneLinks. Arms: 1x4-way, 4x3-way, 4x2-way.
    THE KERB RETURN RADIUS IS THE DESIGN LEVER. A turn confined to the bare
    intersection box has radius road/2 - lane/2 = 125 mm, needing 56.1 deg of
    steering lock at the measured 185.95 mm wheelbase -- past the 38.7 deg the
    servo reaches (R_min 232.4 mm, Appendix DN). THE CAR COULD NOT TURN RIGHT.
    With junction radius Rt the arcs are Rt -/+ lane/2:
    Rt 250 -> right 125, left 375, street 600 left only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
2026-09-07 Connecting roads must be ONE-WAY: file now loads in LaneMaker
    Appendix EF. Evan exported a 3x3 grid FROM LaneMaker (~/Downloads/1122.xodr) --
    the ground-truth reference I had asked for two appendices earlier. It found a
    real defect immediately.
    THE DEFECT: my connecting roads were TWO-WAY. A turn movement runs one way.
    All 47 of LaneMaker's connecting roads have one shape: <right> lane -1 plus
    <center> lane 0 with NO <left> element at all, laneOffset = +lane/2, a
    LANE-level <link> inside the lane, and a roadRunnerProfile with only <right>.
    Mine had two lanes and no lane links -- that was the ACCESS_VIOLATION of
    Appendix EE.
    Fixed via _add_oneway_road(). Verified attribute by attribute agai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
2026-09-07 Session sync: U-turns added, LaneMaker banked as loads-but-no-simulation, all docs synced
    Appendix EG plus a full end-of-session doc sync.
    THE DECISIVE TEST: Evan ran simulation on LaneMaker's OWN 1122.xodr and it
    WORKS. That rules out the tool and puts the remaining fault on our export --
    which is exactly why the test came before building anything.
    U-TURNS ADDED, the cheap and exact half of the gap. LaneMaker emits k arms ->
    k*k movements: 4-arm junction 16 connections, 3-arm 9, 2-arm 4. Mine excluded
    arm-to-same-arm. Now 80 roads and 68 connections (4x4 + 4x3^2 + 4x2^2), matching
    the convention. My own self-check caught the stale constant on the first run
    (AssertionError: 68 against == 4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
2026-09-07 Fix DART action contamination in the controller's history feature
    train_controller.py overwrote act with the DART expert relabel array
    whenever train_actions_expert.npy existed, and fed that same array to
    rnn_states(), which replays it into the frozen MDN-RNN's LSTM. That RNN
    is trained only on executed actions (train_mdnrnn.py via
    splits.load_proc), so h_t was built from a counterfactual action
    sequence that never produced the observed latents -- worst on recovery
    frames, where executed and expert actions differ. diag_copycat.py
    imports the same rnn_states() and inherited the bug.
    Fix: act stays the executed sequence everywhere (feeds rnn_states); a
    new act_target holds the expert relabel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
2026-09-07 Bank the LaneMaker simulation thread as a documented negative
    Seven hypotheses, seven wrong: self-link and self-intersection (EC),
    median required (EC, re-killed against SIMULATION here), U-turns (EH),
    roads-too-short (EO/EP), missing <junction><boundary> (built, verified,
    still crashes -- EQ), and missing <signalPhase> (added to 68 of 68
    connections, still crashes -- ER).
    Resolution: use Evan's own ~/Downloads/figure 8.xodr if a simulation
    visual is ever wanted. It is a working figure-8 through a 4-way junction
    authored by LaneMaker itself -- our exact topology, already simulating.
    cad/export_xodr.py is banked as "loads and renders; simulation
    unsupported"; the physical track is track_layo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
2026-09-10 Enforce MIN_SIDE_CLEARANCE, retire TARGET_DASH_CYCLES, clear ST_DROPPED
    Three findings where a stated rule was enforced by nothing.
    vehicle_envelope.py: MIN_SIDE_CLEARANCE was checked against the LANE edge,
    where the real margin is 29.6 mm/side, so the report printed TOO LONG at all
    six wheelbases and exited 0 anyway because no assertion existed. Evan's call
    (2026-09-09): re-point it at the ROAD edge, which is what actually ends a run
    -- crossing the centreline on a two-lane track with no oncoming traffic is a
    paint violation. Road clearance is 154.6 mm/side at the measured 185.95 mm
    wheelbase, 3x the constant, and self_check now asserts it. A second assert pins
    the knowingly-accepted 29.6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
2026-09-10 Doc sync: fix the public README's self-contradiction and 3 appendices of drift
    README.md is the public repo's front page and contradicted itself: :9 said
    "Nothing has been 3D-printed and no parts have been ordered" while :140 of the
    same file said "printed and tested 2026-09-05". Status block rewritten to
    2026-09-09 -- printing STARTED, nothing ORDERED, BOM $411.45. :3's "1/14-scale"
    corrected to ~1:14.63 (marking_specs.scale() returns 14.6304), and the MG90S
    updated to the MG90D-270 it was swapped for. Voice-checked against the measured
    profile: in band on all four scored metrics, no uniform-sentence alarm.
    Appendices ES (the audit), ET (the doc half) and EU (this remediation) appended.
    Th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
2026-10-01 Project-memory bins: folder renamed, important.md + standard bin stubs (record EY)
    - .claude/codebase-memory -> .claude/project-memory (pure renames; other
    uncommitted bin edits stay uncommitted)
    - important.md (9 critical entries) and 10 STATUS: stub bins
    - 7 one-line path references updated (CLAUDE.md, PRD, cad/, firmware/,
    power-system research note, sim-harness bin)
2026-10-05 Cart review: BOM re-derived to $422.25, BMS swap blocked, 26 AWG dropped
    Propagates Evan's 2026-10-04 cart review into the BOM, bins, HANDOFF and the
    record (Appendix EZ). Nothing was bought. Cart prices are Evan's 2026-10-04
    cart and were not re-verified live.
    The BMS in the cart was ACEIRMC B08CV2VS8G, not row 11b's vetted B08HLQQCQJ.
    Its listing documents overcurrent, short-circuit and a discharge-side MOSFET
    but NO over-discharge voltage set point, which fails important.md #4. Row 11b
    stays on B08HLQQCQJ with a dated BLOCKED note until Evan confirms the order.
    Decisions: 22 AWG for every net (26 AWG dropped, 22 AWG spool upgraded to
    6x10ft); print cad/servo_lego_coupler_v1.stl instead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
2026-10-05 BMS confirmed, wiring gap flagged, resistor builds, coupler v2
    BMS: Evan is ordering the vetted ACEIRMC B08HLQQCQJ (8PCS). Re-verified live
    in a browser on 2026-10-04: buy-box $9.59, In Stock, and the description still
    states "Overdischarge detection voltage: 2.9V+/-0.05V." The set point is in
    the description, not the bullets - both this part's bullets and the rejected
    B08CV2VS8G's say only "Over-discharge protection".
    Safety gap found: docs/WIRING_PROTOSHIELD.md never included the BMS. Its net
    list still runs PACK+ from the holder straight to the fuse, so wiring from it
    would bypass the over-discharge cutoff. A dated warning now heads the net
    list (pack to B+/B-/MB, everything else to P+/P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
2026-10-10 Wiring: route the pack through the BMS and add power/signal/ground diagrams
    docs/WIRING_PROTOSHIELD.md wired the 2S holder straight to the fuse, so a
    build from it had no over-discharge cutoff (found in Appendix FA). Redrawn:
    cells -> 3 A fuse -> BMS B+ / MB / B-, with a new third wire from the
    holder's series strap to MB; charger and every load on P+ / P-; pack
    negative to the star ground is P- via the XT30, never B-. Fuse on the cell
    side by Evan's call, so it covers the BMS board and the charge path. Build
    step 2 split into pack assembly (meter MB, wake the BMS by charging once)
    and the shield power path.
    Section 2.0 adds three Mermaid diagrams - power, signals, ground. A single
    whole-ca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
2026-10-10 Correct Appendix FF: the audit's full 35 findings were saved; finish FD row 9
    A pre-publish landing-check found that FF's claim - FD's other 28 findings
    "were never saved" - was false: the full 35-row table is in the 2026-10-08
    scheduled audit's session transcript. The search had matched filenames, not
    contents. The c5e1026 message was amended before publishing (now cb78025);
    Appendix FG supersedes FF and copies the full table into the record
    (checked for private identifiers: none; transliterated to ASCII).
    FF also overstated two items. Now finished: BOM row 22's "Print v1" cell and
    unstruck "field report" sentence, the "#4252 fit was confirmed on the MG90S"
    claims in BOM.md and steering.md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
2026-10-10 Uno parser resyncs on a bad CRC (audit FD row 15); log parts arrival
    Firmware (compiled 10668 B / 379 B, zero warnings; NOT flashed):
    - rxFeed(): a frame that lost a byte used to swallow the next frame's
    sync, losing that frame too and running its payload bytes '?', 'T',
    'B' as commands. A bad frame is now rescanned for the next 0xA5.
    - cmdAllowed(): 'T' and 'B' refused while ARMED; '?' always allowed.
    - 9 SELFTEST checks through the same rxFeed() loop() calls; host_test
    test 4b is the board-level gate. Neither has run.
    - SERIAL_PROTOCOL.md: resync documented; section 5's "cannot collide"
    claim corrected.
    Parts: 23 of 24 ordered items arrived 2026-10-10; Camera Module 3 Wide
    unrepor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
2026-10-11 Couplers: servo v3, drive-motor D-shaft v1/v2; servo bench sketch
    - gen_servo_lego_coupler.py: --od, --bore-depth, --socket-depth,
    --bore-dia, --bore-flat (D-bore), --screw-dia. Defaults unchanged, so
    servo v1/v2 regenerate byte-identically. New guard: the web hole must
    sit inside the bore and socket at every angle (a 2.2 mm hole crosses a
    3 mm D-shaft's flat; the mesh checks missed it).
    - Servo v3: v2 fitted ("dimensions are good"); half the wall (OD 7.4),
    14 mm long. Untested; ~36% of v2's twist section modulus.
    - Motor v1 (3.00 / 2.50 across flat) printed TOO TIGHT; v2 adds 0.075 mm.
    The D-flat is still not caliper-measured.
    - firmware/servo_bench: type a pulse in us to map th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
2026-10-11 Motor coupler v3: D-bore another +0.075 mm (3.150 / 2.650 across flat)
    v1 was too tight, v2 (+0.075) inferred still too tight. The shaft's real
    across-flat size is still not caliper-measured. check_artifacts: 32
    checked, 0 drifted. Record: Appendix FS.
2026-10-11 Wiring audit fixed: 5.0 V rail, cut-cable gate, BMS order, pixel reorder
    Cold audit of docs/WIRING_PROTOSHIELD.md (2 auditors): doc and firmware
    agree pin for pin; 22 findings above that level, fixed per Evan's
    decisions (2026-10-11):
    - rail trimmed to 5.0 V (was 5.2, 0.3 V from the ATmega limit), pot locked
    - build order: flash first off-shield; step 1b proves the cut-5V USB
    cable on the FT232RL clone; 2a cells out, B- / MB / B+, fuse last;
    2b polarity; 8b repeat at ~6.4 V; 3 A fuse kept with a stated budget
    - strips cut 2 + 1 per side, tail on a rear jumper; uno_control PX order
    HEAD=0, IND=1, TAIL=2 (compiles, 0 warnings, 10668 B)
    - host_test.py --wired; without it, refuses (exit 2)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
2026-10-12 Printed mounts Phase A: OpenSCAD tooling + PLA fit coupon; online part dims
    - scripts/render_scad.py: renders .scad to a canonical binary STL, validated
    (closed manifold, volume, bbox, ray probes) before anything is written;
    self_check registered in run_checks.py.
    - cad/scad/lib/lego.scad: Technic hole / pin grid / pilot / zip-slot primitives.
    - cad/pla_fit_coupon.stl (untested, not printed): PLA pin-hole, counterbore,
    pitch, horizontal-hole, servo-pilot and zip-slot fits; in check_artifacts.py.
    - Record FY (mounts plan, Phase A), FZ (electronics + Lego dimensions found
    online), GA (correction: Pololu publishes #5159's dimensions, M1-M4).
    - BOM row 12 note (LM2596 link now shows a di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
2026-10-12 Motor mount v2 (real-pin snap sockets); servo + electronics layout drafts
    - cad/motor_mount.stl v2 (untested): v1 was printed (dims fine, encoder hit
    the back third of the side walls) -> walls trimmed, back wall added, arms
    take real black friction pins in Lego-beam-shaped sockets (6.2 x 0.8
    collar recess, 4.8 bore, 6.2 snap cavity). Registered in check_artifacts.
    - docs/research/2026-10-12_technic-pin-snap-geometry.md: pin/hole geometry
    (cailliau measured recess; LDraw pin lip), cold-assessed.
    - cad/scad/servo_mount_draft, electronics_tray_draft, electronics_deck_draft:
    LAYOUT DRAFTS, not printable, placeholders named *_UNMEASURED, no STL.
    - Record GA-GL: online motor dims (correc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
2026-10-12 Decision: real black pins for printed parts; docs-sync + drift check
    - decisions.md started: every printed part attaches with LEGO 2780 friction
    pins (record GM).
    - HANDOFF drift check: 6 stale claims in the next-session prompt fixed
    (suite 16/16, mounts status, motor coupler v3 fits); record GN.
    - PRD task 6: dated note on motor mount v1/v2 (done-check not passed).
2026-10-12 Servo mount v1: open under the body, ears on plastic, pinned at the L corner
    - cad/servo_mount.stl (printable, untested), registered in check_artifacts;
    replaces the servo layout draft. Measured servo (record GO) + Evan: open
    space under the case, far ear hole 2 studs + 1 mm from the shaft (GP).
    - Record GO, GP; HANDOFF, cad/README.
2026-10-12 Servo L liftarm: corner stud freed, mount v1 stands; GQ timestamp correction
2026-10-12 Servo mount v2: one plate across both L liftarms, pinned on both sides
2026-10-12 Motor mount v3 + pin holes 4.875 mm in every mount
    - Motor mount v3: floor up 2.5 mm, back wall 2 mm closer to the motor (GT).
    - Pin bore 4.80 -> 4.875 in motor, servo, tray and deck models and probes (GU);
    decisions.md updated.
2026-10-12 Servo mount v3: 6 mm higher, two pinned rails + ear bridges (record GV)
2026-10-13 Motor mount v4; printable electronics tray + deck; docs-sync
    - Motor mount v4: walls/floor 11 mm longer at the front, walls 0.2 mm in,
    1.5 x 1.5 side lips (record GW).
    - cad/electronics_tray.stl + cad/electronics_deck.stl (printable, untested),
    registered in check_artifacts; layout drafts removed (GW).
    - Camera in shipping; open requirements: motor cable routing from below,
    sturdy camera mast mount (GX). HANDOFF, PRD, cad/README, important.md,
    hardware.md.
2026-10-13 Servo mount v4+v5, motor mount v5: three pins per side (records GY, GZ, HA)
    - Servo v4 (GY): ear bridges start at z 0, the rail level.
    - Servo v5 (HA): bridges only between the rails (y -12..12); v3/v4's far
    bridge capped the stud-2 peg holes. All six peg holes now open.
    - Motor v5 (GZ): pin sockets at x -16/0/+16 both sides, rails x -20..20.
    Assumes beam holes at +/-16 and nothing hanging below the +/-8 holes.
    - HA corrects GZ's time (21:11 CDT, not 21:13).
    All UNTESTED (not printed). Probes 98/98 and 126/126; check_artifacts
    0 drifted; run_checks 16/16.
2026-10-13 Servo mount v6: bridge-to-rail gussets (record HB)
    Six 4 mm right-triangle gussets, z 0..7.8, where each ear bridge meets a
    rail's inner face; all inside y -12..12, so rail tops and peg holes stay
    clear. UNTESTED (not printed). Probes 109/109; check_artifacts 0 drifted;
    run_checks 16/16.
2026-10-13 Motor mount v6: side walls 3 mm taller (record HC)
    WALL_TOP 26.2 -> 29.2 for the two side walls and their front lips; back
    wall unchanged. New risk noted in HC: tops now above the 27.0 mm black
    steering parts, whose position is unconfirmed. UNTESTED (not printed).
    Probes 134/134; check_artifacts 0 drifted; run_checks 16/16.
2026-10-13 Camera mast research brief: 109 mm, 28-30 deg, front axle, remap (record HD)
    New measurement: the sim camera sat at 0.435 x lane width (corpus lane
    profile, zero at row 42.36 vs horizon 41.97). Camera Module 3 Wide vertical
    FoV is 67 deg vs the sim's 90, so no pose matches without a software remap;
    SIM_TRANSFER_SPEC's row-42 mount target gets a dated correction. Brief went
    through source re-verification and a cold assessment. Desk result only.
2026-10-13 Servo mount v7, camera mast v1, tray/deck v2 cable channel (records HE, HF)
    - Servo mount v7 (HF): servo 1.6 mm forward (SERVO_DX), 0.5 mm higher
    (ear bridges 13.8); rails and peg holes unchanged.
    - Camera mast v1 (HE, new, registered in check_artifacts): pins to the two
    front "+" holes (axle-pins 43093) and servo-mount stud 2 (3L pins 6558);
    slide-in holder, lens 109 mm above floor at 29 deg.
    - Tray/deck v2 (HE): encoder-cable notch in the -y rail + slot through the
    tray floor and deck.
    All UNTESTED (not printed). Probes 113/113, 75/75, 205/205, 79/79;
    check_artifacts 38 checked, 0 drifted; run_checks 16/16.
2026-10-13 Pin holes 4.875 -> 4.95 mm in all five mounts (record HG)
    PIN_D raised 0.075 in servo mount v7, motor mount v6, tray v2, deck v2 and
    camera mast v1, with matching probes. Recesses, snap cavity, deck pegs and
    the fit coupon unchanged. Bore measured in each mesh: vertex radius
    2.4404 -> 2.4780 (+0.075 on the diameter). All renders PASS; check_artifacts
    38 checked, 0 drifted; run_checks 16/16. UNTESTED (not printed).
2026-10-13 Print-friendly CAD rules brief; v6 fit result; XY hole comp 0 (records HH, HI, HK)
    - HH: servo mount v6 printed, pins too tight at 4.875 (settings not recorded).
    - HI: docs/research/2026-10-12_print-friendly-cad-rules.md - 13 ranked rules;
    verified at source, cold-assessed; counts and profile note corrected after
    the 2026-10-13 daily audit (HJ).
    - HK: Bambu Studio X-Y hole compensation is 0 mm (Evan) - CAD owns clearance.
2026-10-13 Fit classes in lib/lego.scad; parts use lego_pin_d() (record HL)
    fit_offset()/fit_d()/lego_pin_d(): friction_pin +0.15, press_shaft +0.15,
    slide 0.30, rotate = assert-fail (not calibrated in PLA), unknown = assert-fail.
    All five mounts set PIN_D = lego_pin_d(); all five STLs re-render
    byte-identical. check_artifacts 38/0 drifted; run_checks 16/16.
2026-10-13 Servo bench: locks, backlash located; servo_bench US_MAX 2800 (records HM-HQ)
    - Right lock ~2600 us = servo end of travel (rack 0.5 mm short of its stop).
    - Left lock ~450 us = rack stop: firmware limit must sit inside first contact.
    - 100-150 us of steering free play = tooth clearance in the gear pair before
    the rack. Fix not chosen.
    - firmware/servo_bench: US_MAX 2600 -> 2800 (Evan).
    uno_control NOT changed or reflashed.
2026-10-13 uno_control: steering backlash compensation, overshoot 125 us and hold (records HR, HS)
    backlashCommand(): servo sits at target + dir x 125 us (dir = last move),
    so the rack lands on the target with the gear teeth loaded. Centre
    1500 -> 1525 (backlash model fit to the bench data, unverified). Safe
    limits 550..2600. 9 new SELFTEST checks. Compiled 11598 B / 388 B;
    NOT flashed, SELFTEST not run yet. firmware-traps: .ino prototype trap.
2026-10-13 uno_control: servo gated to OUT_DRIVE (audit HJ fix); flashed, SELFTEST 86/86 (records HT, HU)
    steerAllowed(): the servo follows steering commands only when the motor
    may drive (armed, pack OK, link alive); otherwise it holds its last pulse.
    5 new SELFTEST checks. Flashed to the Uno 2026-10-13: boot banner
    "SELFTEST PASS 86/86". Board now runs this exact source (important.md #3).
2026-10-13 uno_control: backlash half-gap MEASURED 75 us (was 125 fit), centre 1525 confirmed; banner says servo wired; not flashed - COM3 busy (records HW, HX)
2026-10-13 Record HY: uno_control flashed with backlash 75 us, SELFTEST 86/86; HANDOFF + important #3
2026-10-13 Decision: steering gate unchanged, end-to-end steer test waits for the pack (record HZ)
2026-10-13 Electronics tray + deck v3: print-friendly redo (ribs, tie paths, Pi pocket clearance, lead-ins); fit class 'pocket' (record IA)
2026-10-13 Fit coupon row D + pocket gauge; deck raised 2 mm (holder clash); electronics layout with collision checks, every part placed (record IB)
2026-10-13 PETG fit results; tray v5 (10 mm fences, 3.5 zip slots); deck v6 (rocker 21, LM2596 pegs 57.5 x 31.5); measured sizes in layout (records IC-IH)
2026-10-13 Tray v6 / deck v7: deck +10 mm so the fuse holder lies on the bank; Uno standoffs 6 mm for the USB plug; layout checker: clearance kind, part-on-part support (record II)
2026-10-14 Tray v7 / deck v8: bank, holder and Pi on 4 mm velcro (tie slots could never close); fences 14, Pi brackets 10, deck at 46 (record IJ)
2026-10-14 Tray v8 / deck v9: side lobes on the frames, no zip slots (record IK); docs-sync: HANDOFF prompt, decisions, PRD (record IL)
2026-10-14 Layout: charger USB-C and holder leads on a short end (-x); holder black lead likely short, plan an extension (record IN); scheduled daily-audit entry (record IM)
2026-10-14 BMS moved onto the 2S holder so the unfused B-/MB leads stay short; wire-length estimates; BMS wiring diagram docs/bms_wiring.svg (record IO)
2026-10-14 Pack MB tap: holder rivet is the series node (3.55/3.55 V), MB wire soldered to it; wiring note + hardware bin (records IP-IT)
2026-10-15 BMS wired to the cells; P+ to P- measured 7.21 V (records IU, IV)
2026-10-15 Camera arrived - all parts in, PRD task 8 done (record IX); charger + XT30 on the BMS output pads, 4 x 190 mm (record IW); HANDOFF pack status
2026-10-15 Pack charged: charger reversal found and fixed, first charge stopped early, second stopped at 8.29 V (records IY-JB); HANDOFF next steps
2026-10-15 Charger board 1 retired (swap before 2nd charge); charger polarity warning in build step 2a; LM2596 set to 4.99 V unloaded (records JC-JE)
2026-10-16 Uno powered by the Pi's USB (plain cable, no cut); +5V2 only for servo/strips/encoder; barrel-jack idea test (records JF, JG)
2026-10-16 Pi 5 on Bookworm, first camera photo (records JJ, JK); docs-sync: PRD task 9, hardware bin, HANDOFF (record JL)
2026-10-16 Step 1b PASSED from the Pi (host_test all ok, uno_control 86/86); servo-supply test data; servo on the Uno 5V (Evan) with +5V2 jumper fallback (records JM-JR)
2026-10-16 Pack-side wiring diagram docs/pack_wiring_full.svg; LM2596 stays 5.0 V; motor hookup notes (record JS)
2026-10-16 docs-sync: HANDOFF next action (step 2b), hardware/testing bins (flash from Pi, servo decision), PRD task 9 (record JT)
2026-10-17 Tray v10 + deck v11 for the new 168 x 62.16 x 22.51 bank: fitted to the soldered pack wires, deck +8.5, velcro under every part, rocker on the -y wing, room reserved for plugs and cables (records JU,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
2026-10-17 Tray v11 + deck v12: Evan's bench results - velcro 3.5 mm dots, Pi USB-C on its side (brackets + -y wing re-ordered), bank charge LEDs kept readable from the side (record JW)
2026-10-17 Camera mast v1 added to the layout checker: worst-case 9.0 mm gap to the camera-ribbon zone, self-check (e) (record JX)
2026-10-20 Camera mast: print tabs removed (Evan), geometry back to v1; print note: paint supports under the side members only (records JY, JZ)
2026-10-20 Deck v13: LM2596 +4 mm clear of the lobe boss (Evan caught the clash); layout checker fails parts touching material at a side (record KB)
2026-10-20 Pack wiring diagram redrawn: W1-W17 with lengths, star bar, cut list; generator scripts/pack_wiring_svg.py (record KD)
2026-10-20 BOM wiring section superseded: Uno on the Pi's USB, +5V2 never on the Uno 5V pin, servo on the Uno 5V header (audit KA HIGH #1, record KE)
2026-10-21 Proto shield: hole-by-hole layout (docs/shield_layout.json) + checker scripts/shield_holemap.py -> shield_holemap.svg + SHIELD_BUILD.md; shield nets diagram; docs-sync: HANDOFF current state + prompt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
2026-10-21 Shield map: wires carry their corner holes ("via" in shield_layout.json); w3/w4/w5 drawn as the SHIELD_BUILD step-6 L-routes, not diagonals; holemap check 1 fails a diagonal leg (+ self-check); 3D re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
2026-10-21 HANDOFF: current state + prompt for KI/KJ (3D shield render, via wire routes, svg_text_overlap gate, suite 19); appendix count 296 A-KJ; bins index
2026-10-21 Shield SVG audit (KK): socket arrows to the correct Uno header (4 of 8 were wrong), underside-bridge warning, KEY as a hollow ring, wire-end dots, resistor pins labelled by net, merged legend + red-x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
2026-10-21 Underside 3D render: top-side parts as labelled cyan ghost outlines, wires as pink lines, leaders for labels pushed off their part (record KL)
2026-10-21 Shield renders: true top-down orthographic top view; readable underside (bigger labels on dark plates, thicker outlines, labels allowed past the board edge); renders stacked full-width in the SVG, ca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
2026-10-21 Shield renders: top view labelled (shared label placer, leaders to the part footprint), every hole drawn on the top face too (record KN)
2026-10-21 C1 (470 uF) stands upright on the VMOT/GND tips: build step 1 changed (was lay flat), C2 beside it, renders updated, A0 lead drawn above the can (record KQ)
2026-10-21 docs/SHIELD_SOLDER_GUIDE.md: step-by-step proto-shield soldering guide with per-step checks (holes cross-checked against shield_layout.json); HANDOFF read list (record KR)
2026-10-22 Build guide: GND (black) and 5V (red) rails drawn and named on every board step image (record KT)
2026-10-23 How-it-works page as build-guide panels: per-net 3D renders (shield_render3d.py --flow, docs/guide/flow_*.png), in-phase solder in net colour; scripts/shield_flow_svg.py rebuilt (record KW)
2026-10-23 Strips named by side like the firmware: J3 = left (D4), J4 = right (D7), net DIN_F -> DIN_L; pack + shield wiring diagram texts (audit KU Med #1)
2026-10-23 See-through close-up of the pack-voltage divider: docs/shield_divider_xray.svg (scripts/shield_divider_xray.py), holes asserted against shield_layout.json (record LA)
2026-10-26 Teleop + recording stack in pi/ (custom Python, DonkeyCar dropped): serial link, camera, npz recorder, websocket/web UI with Xbox pad via browser; fake-hardware verified, suite 26; shield photo revie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
2026-10-29 Landing-check + docs-sync after LD: uncited advice recorded, C1 contradiction, DonkeyCar superseded markers, car_data/ ignored, websockets declared (records LE-LG)
2026-10-29 pi/camera.py checked against picamera2 docs: pass fps (default 30 bug), pin the 2304x1296 sensor mode, print the real ScalerCrop at the first frame (record LH)
2026-10-29 Stale power/wiring/firmware text marked superseded with record letters (audits KA/KU MEDs; plan C3+C4); LM2596 4.95 V measured (JE) vs 4.99 V restated (JF/JR) noted, not chosen
2026-10-29 Autopilot mode in teleop (pi/autopilot.py, shared pi/preprocess_frame.py): pad override, deadman, bench throttle 0, log_mode per frame (plan A3)
2026-10-29 Bins split: hardware.md -> router + power / shield-wiring / print-mounts; track.md -> track + track-xodr-closed (no line dropped; plan C6)
2026-10-29 C1 can as a layout entry, checked to lie inside the shield-wiring clearance: margin +1.2 mm (plan C1)
2026-10-30 Pi session de-risk: deploy.sh (--dry-run), preflight.py, protocol rule 3 (2 bad CRCs = link fault), Uno reconnect, arm refused on a dead link, save failures surfaced (plan B2+B3)
2026-10-30 Teleop safety (audit LL highs 1-3): bind 127.0.0.1 + Origin check, NaN model output disarms, AUTO throttle no longer capped twice; control errors disarm and continue; recorder on_error replaces the e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
2026-10-30 Off-car Pi mode: teleop --fake-uno (FakeUno + real camera, episodes flagged fake_uno), preflight --no-uno, README off-car session
2026-10-30 Landing-check fixes: ignore *.onnx exports, test the real-path --no-uno SKIPs, export_onnx usage incl. --untrained
2026-10-30 Record LQ: off-car Pi session software + landing check; HANDOFF item 0a-off, bins and DATA_COLLECTION updated
2026-10-30 Record LR: first code run on the Pi (off-car) - preflight PASS, camera 20 fps, autopilot p95 1.40 ms, fake guard proven; HANDOFF and bins updated
2026-10-30 Record LS: Pi power measured - Anker A1275 sags to 4.52 V under full load; HANDOFF and power bin updated
2026-10-30 Power bin: battery backup USB-C port rating (5V 3A / 9V 3A / 15V 2A)
2026-10-30 Record LV: wall charger holds 5.11-5.15 V, throttled 0x0 - battery backup was the cause; heat flag 77.9 C
2026-10-30 Record LW: bare-board heat, 5 A charger (likely kit PSU), kit fan case is the fix
2026-10-30 Record LX: Anker bank also sags under full load (5/12, 4.539 V, 3 A mode); cable confound open
2026-10-30 Record LY: bank passes with a new cable - the old USB-C cable caused all the sags; corrects LU/LV
2026-10-30 Record LZ: Vilros case slot is for PCIe, not the camera - case OR camera until modified
2026-10-30 Record MA: bare-board heat under real teleop plateaus at 45-47 C, throttled 0x0
2026-10-31 Shield meter test card (scripts/shield_test_card_svg.py -> docs/shield_test_card.svg/.png): steps 0-8 checks in test order, holes cross-checked against shield_layout.json; suite 34
2026-10-31 Record MB: as-built Uno wiring - servo D6, strips on D2/D1 clash with encoder INT0 and serial TX
2026-10-31 Fix record letter citations: the as-built wiring entry is MC (MB is the 2026-10-31 scheduled audit, committed as written in ededa5e)
2026-10-31 Record MD: corrects MC - Uno wires on D7/D6/D5, no clashes; firmware expects D9/D4/D7
2026-10-31 Firmware pins to the as-built wiring (record MD, Evan chose B): servo D9->D7, left strip D4->D6, right strip D7->D5; both sketches compile; NOT flashed
2026-10-31 Layout, generators, regenerated SVG/PNGs and prose docs to servo D7 / strips D6, D5 (record MD); no spare PWM pin left noted; suite 34/34
2026-10-31 Record ME + docs-sync: option B done (servo D7, strips D6/D5), compiled not flashed; important #3, firmware-traps, HANDOFF item 0b re-flash; suite 34
2026-10-31 Audit MB fixes 1-3 (ml): prep_dreamer_corpus back on the legacy split P3 trained on (the HIGH; val = the 12 dreamer/eval files); splits.check_corpus refuses a legacy checkpoint on a hash split, wired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
2026-10-31 Landing-check fixes: teleop signal handler no longer takes the lock (deadlock if SIGTERM landed during shutdown; self-check covers it); stale pin/3dstreet/watchdog/port text struck in SERIAL_PROTOCOL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
2026-10-31 Record MF + docs-sync: audit MB fixes and landing check recorded; HANDOFF stamp
2026-10-31 Records MI + MJ: shield docs moved to as-built direct-to-pin wiring (servo D7, strip DIN D6/D5 as leads; 400 ohm DIN resistors never built; L1/-2-L1/-3 bridge removed); test card section C, guides, r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
2026-10-31 Record MK: rocker rated 6A 250V / 10A 125V (AC marking, no DC rating); judged adequate behind the 3 A fuse, untested
2026-11-01 Record ML: one-page wiring sheets for build steps 2b (power after the rocker, W8-W14) and 5 (motor + encoder, W16); scripts/step_wiring_svg.py generates them from shield_layout.json + the pack cut li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
2026-11-01 Records MM + MN: J5/J6/J1 ends from cut Dupont jumpers in a glued block with an empty KEY (EDGELEC listing has no gauge or amp rating), wiring sheets updated; build step 2b done per Evan, LM2596 outp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
2026-11-01 Records MO-MS: card E PASS (first shield power-up: J5 8.18 V, J3 4.96 V, Uno 5V ~5 V); deck v14 (2 mm Pi corner brackets, pegs 2.5 mm, velcro bars across the Pi vent, two 20 mm Uno velcro pads); tray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
2026-11-01 Records MT + MU: scheduled audit MT (1 high: test card never checks M1/M2 vs Uno 5V/GND before step 5); deck v15 - Pi USB-A clearance 100 mm, Uno turned 180 deg onto a new -y rear wing beside the LM2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
2026-11-01 Records MV-MY: step-5 leads made, not connected; A0 -0.883 V (magnitude PASS, sign = swapped probes, inferred); MX corrects J5 VBAT to L3/10 (P3/10 is KEY); step-5 power-off checks PASS (P3/6-L3/10, 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
2026-11-04 Records MZ-NM: DIR_B D12 -> D9 (flashed); motor_sweep.py; forward stall is mechanical (open J1 +2.10/-2.09 V, freed motor ~1850 ticks/s both ways); CanaKit Pi 5 8 GB stress: run 1 crashed, run 2 PASS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
2026-11-04 HANDOFF: paste-ready prompt STATE + NEXT ACTIONS rewritten for records NE-NM (D9, mechanical forward stall, CanaKit Pi 5 8 GB stress)
2026-11-04 Record NO: six-worker code+docs audit fixes - run_checks catches SystemExit and non-None returns; holemap checks the real layout; staged artifact check triggers on sources; probe key validation; tele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
2026-11-04 Record NP: C2-1 fixed - World Models consumers pair frame t with the action decided on it (splits.decided_on; data contract unchanged); MDN-RNN + 3 controllers retrained (mdnrnn_next, cl_next); eval_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
2026-11-04 Record NQ: audit-NO decisions built - servo reversal deadband 10 us (compiled 12268 B, NOT flashed, expect SELFTEST 91/91); run_checks --strict is the PC done-check; export sidecar stand_tested=false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
